JulesBischof/Praxismodul/README.txt

Praxismodul Julian Bischof

Die Dokumentation wird mit LaTex erstellt. 

Der Projektplan befindet sich auf GitHub unter dem link https://github.com/users/JulesBischof/projects/2/views/13

Das Repo befindet sich unter dem Link https://github.com/JulesBischof/Praxismodul.git
