JulesBischof/Praxismodul/02_Recherche/09_Encoder_Motor_Anschluss.txt

Shield zu Print Verbindung Motor: 

https://www.digikey.ch/de/products/detail/harwin-inc/S8091-46R/3131051
