JulesBischof/Praxismodul/00_Doku/Wiki_stand0805.pdf

# IOLxS Entwicklung

## Bauteile und 2nd Sources

SMD LED's

Grün; Bauform 0805
Lite-On LTST-C171GKT 0.04270 CHF Knightbright APT2012CGCK 0.06434 CHF

### Speisung

Common Mode Choke mit ~0.8mH - Grenzfrequenz ausgelegt auf ca. 60kHz. Störungen sind laut Louis zu erwarten ab 150kHz. Damit trotzdem die Impedanz des Filters nicht zu klein und die Störung einfach auf das Shield umgeleitet wird, wird die Grenzfrequenz bei 60kHz und nicht bei 15kHz angesetzt. Differential Mode Filterung mit ~1.5uH Streuinduktivität - Grenzfrequenz ausgelegt auf fg ~80kHz Dämpfungskondensator nur einbauen wenn benötigt. Aber für Anfang Footprint mal vorsehen, da C recht gross ist und Dämpfung gering. Weiter hinten in Richtung Motorentreiber befinden sich weitere Kapazitäten als Stützkondensatoren, welche ebenfalls dabei helfen Differentialmode Störungen zu unterdrücken. Von dem her wird davon abgesehen, die Grenzfrequenz allzu niedrig anzusetzen.

Inrush Limiter mit einer Ladekonstante für das C von in etwa 1ms. Dadurch wird der Anstieg des Stromes während der ersten paar us für die Stützkondensatoren auf ein gewisses Mass begrenzt. Durch die höheren Widerstände wird gewährleistet, dass im Zweifelsfall schnell auf eine Höhere Kapazität ausgewichen werden kann falls die Begrenzung bei der Inbetriebnahme nicht ausreichen sollte.

3.3V über LDO bereitstellen.

Bauteile & Secondsourcen

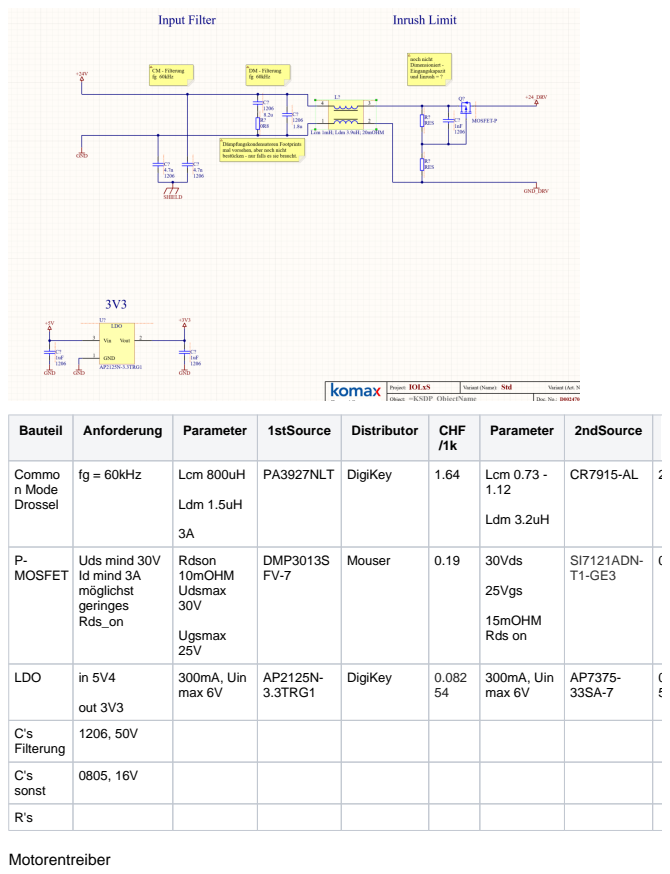
[picture p1: page 2]
Bauteil; Anforderung; Parameter; 1stSource; Distributor; CHF; 2ndSource; Commo n Mode Drossel; fg = 60kHz; Lcm 800uH; Ldm 1.5uH; PA3927NLT DigiKey; Lcm 0.73 -; Ldm 3.2uH; P- MOSFET; Uds mind 30V Id mind 3A möglichst geringes Rds_on; Rdson 10mOHM Udsmax 30V; Ugsmax 25V; DMP3013S FV-7; Mouser; 30Vds; 25Vgs; 15mOHM Rds on; SI7121ADN- T1-GE3; LDO; out 3V3; 300mA, Uin max 6V; AP2125N- 3.3TRG1; DigiKey; C's Filterung; C's sonst; Motorentreiber

Stützkondensator - worst Case Szenario für den Stützkondensator ist, wenn bei der niedrigsten PWM-Frequenz der volle Strom benötigt wird. Überschlagsmässig gerechnet mit einer Frequenz von ~20kHz (Datenblatt). Der Ausgangswiderstand eines Standartnetzteils beträgt zurückgerechnet über die Load Regulation (1%) 12mOHM. 10 Meter Kabel (5m Speisung) haben erwartungsgemäss bei einem Querschnitt von 075mm2 einen Innenwiderstand 680mOHM. Die dies ergibt gesamthaft ein R von ~700mOHM (inkl Choke + Leiterbahnen) parasitäre Indutivitäten und Kapazitäten mal vernachlässigt. Über die Formel U(t) = U0*e^(-t/tau) lässt sich das sich ergebende Spannungsripple pro Periode abschätzen. Bei einem C von 470uF kommt man so auf in etwa 107mV. Dies sollte vorerst ausreichen, das die Differentialmode Filterung ebenfalls noch einen Teil dieses Ripples herausfiltern wird und laut Datenblatt des Industrienetzteils ein Ripple von 100mV so oder so zu erwarten ist. Ausserdem betrachten wir hierbei den Worst-Case.

Die Weiteren Kondensatoren vor der Speisung wurden so vom Evaluationboard übernommen und werden bei höheren Frequenzen bereits niederohmig und sollen so Hochfrequente Spitzen bereits abfangen können.

Clock

Bezüglich des Encoders kann der interne Clock genug schnell zählen, um alle Schritte zu erfassen. (bis zu 2/3 des Clocks ist ein typischer Wert).

Der interne Clock ist allerdings nicht sehr genau (+-0.65MHz). Es ist abzuwägen, ob von Board zu Board eine Abweichung von +-5% tolerierbar sind oder nicht. Das Board bezieht sich in seinen Rechnungen für Geschwindigkeit und Beschleunigung auf den Clock als Zeitreferenz.

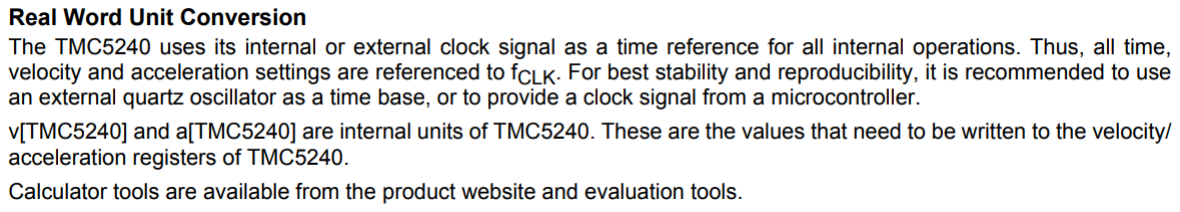
[picture p2: figure]
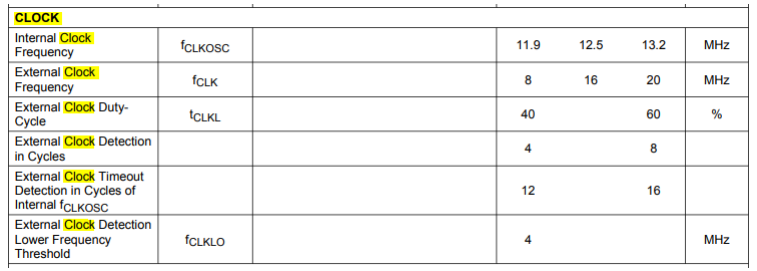
[picture p3: figure]
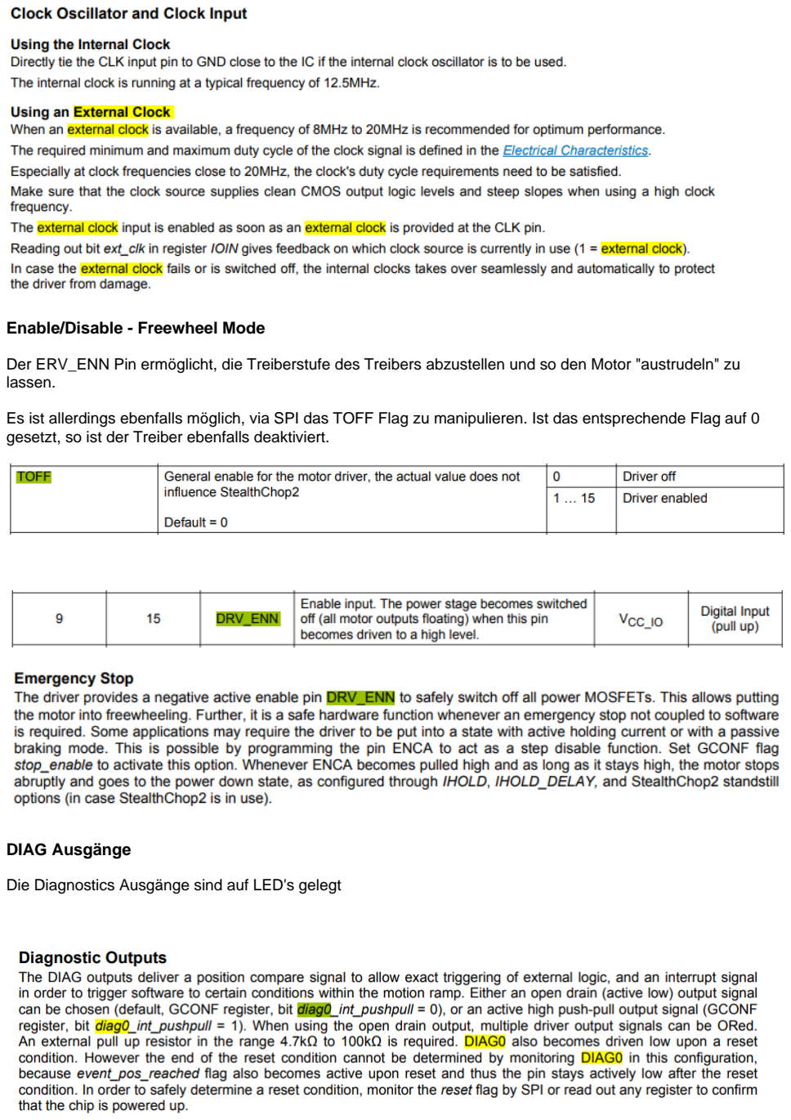
[picture p4: page 4]

Enable/Disable - Freewheel Mode

Der ERV_ENN Pin ermöglicht, die Treiberstufe des Treibers abzustellen und so den Motor "austrudeln" zu lassen.

Es ist allerdings ebenfalls möglich, via SPI das TOFF Flag zu manipulieren. Ist das entsprechende Flag auf 0 gesetzt, so ist der Treiber ebenfalls deaktiviert.

DIAG Ausgänge

Die Diagnostics Ausgänge sind auf LED's gelegt

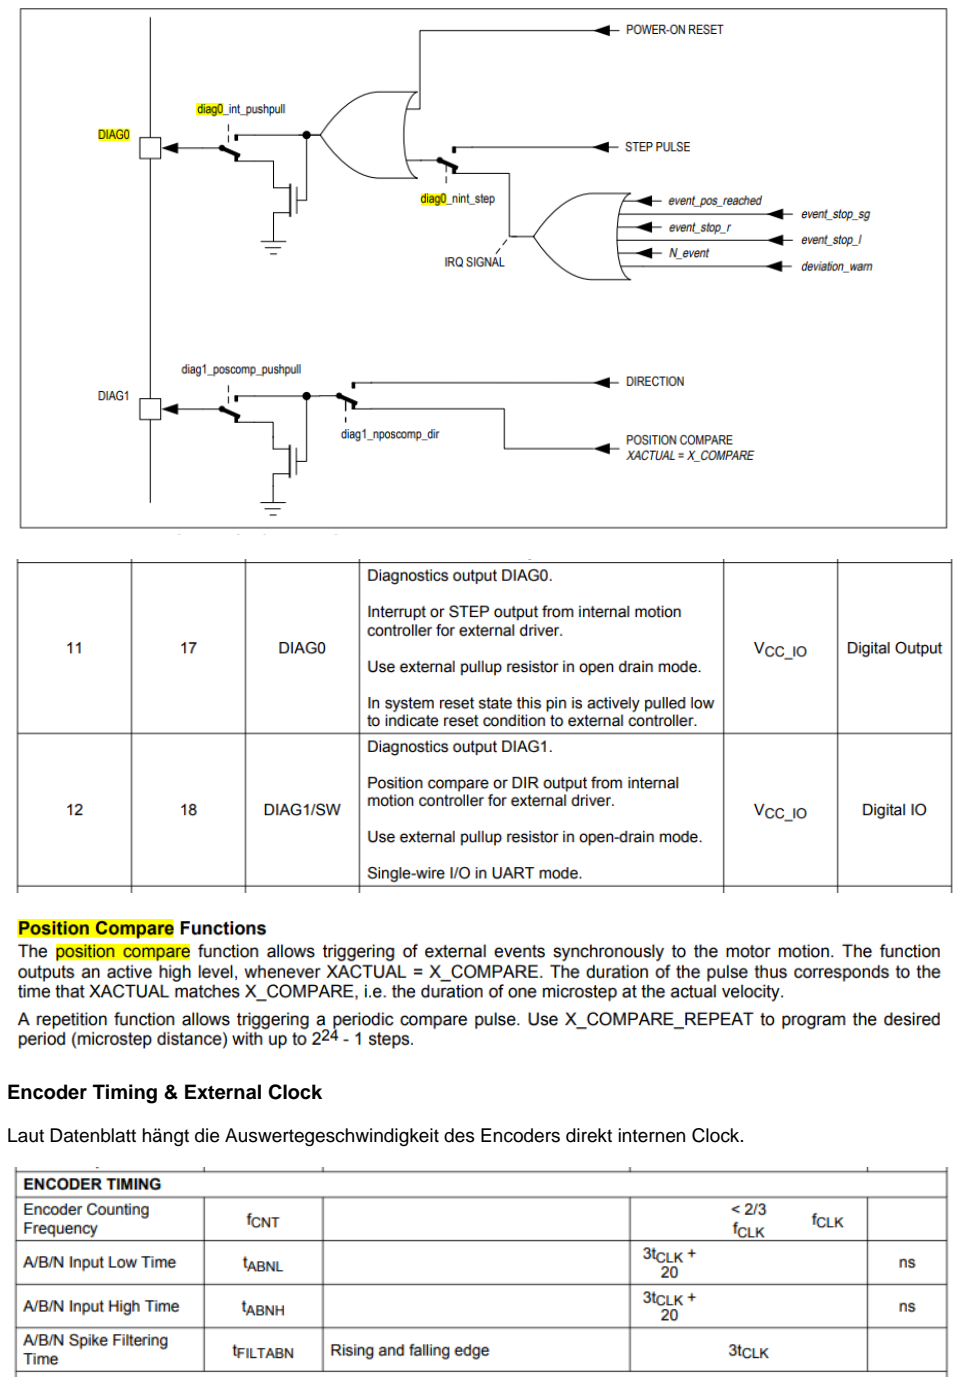
[picture p5: page 5]

Encoder Timing & External Clock

Laut Datenblatt hängt die Auswertegeschwindigkeit des Encoders direkt internen Clock.

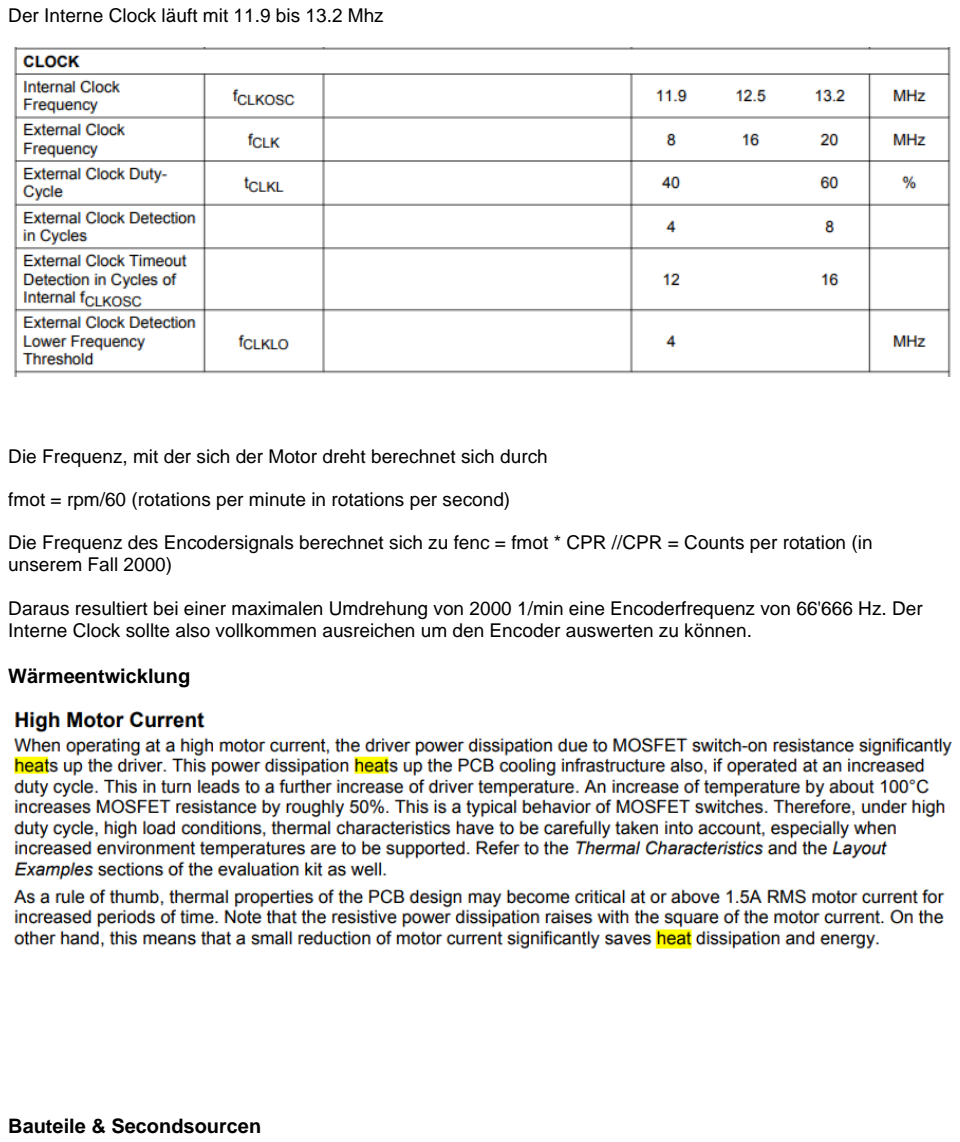
[picture p6: page 6]

Der Interne Clock läuft mit 11.9 bis 13.2 Mhz

Die Frequenz, mit der sich der Motor dreht berechnet sich durch

fmot = rpm/60 (rotations per minute in rotations per second)

Die Frequenz des Encodersignals berechnet sich zu fenc = fmot * CPR //CPR = Counts per rotation (in unserem Fall 2000)

Daraus resultiert bei einer maximalen Umdrehung von 2000 1/min eine Encoderfrequenz von 66'666 Hz. Der Interne Clock sollte also vollkommen ausreichen um den Encoder auswerten zu können.

Wärmeentwicklung

Bauteile & Secondsourcen

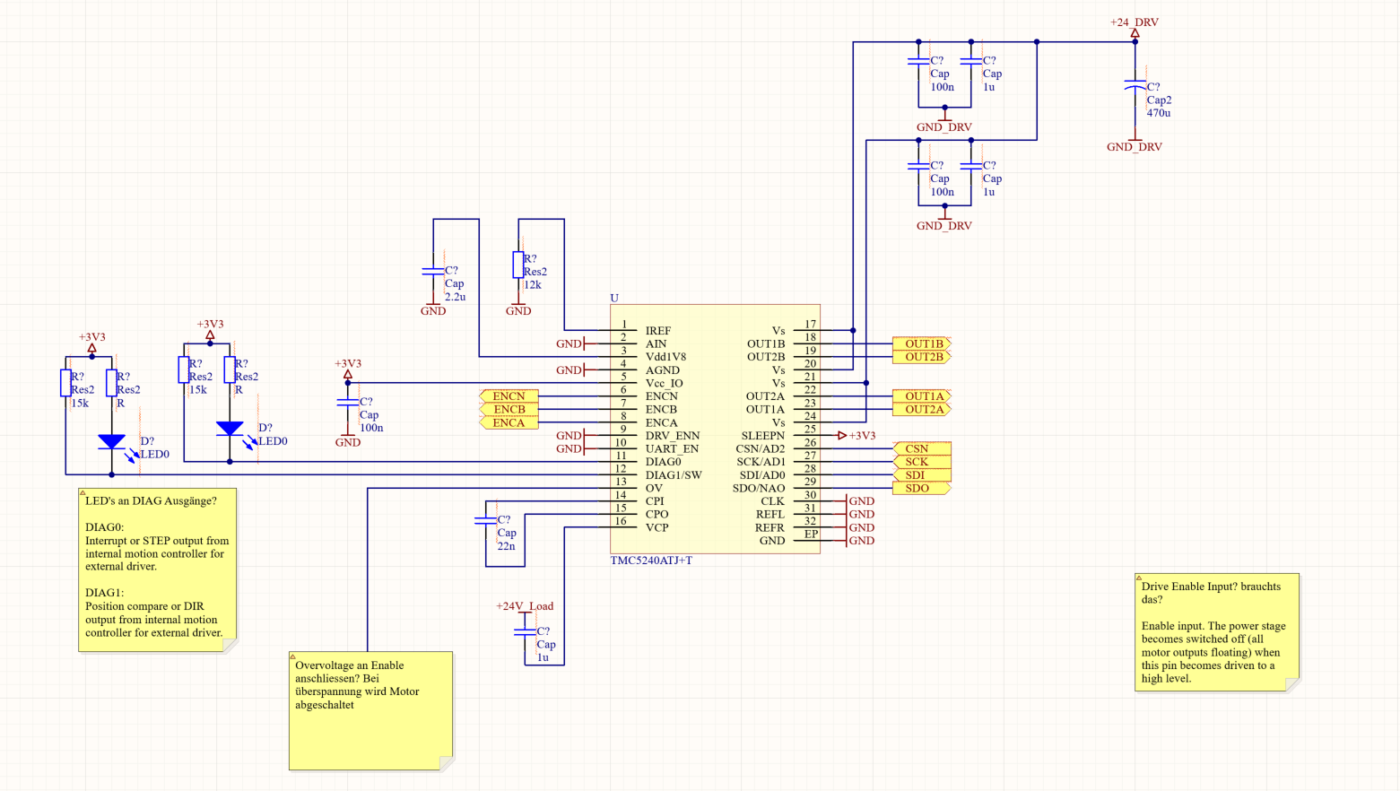
[picture p7: figure]
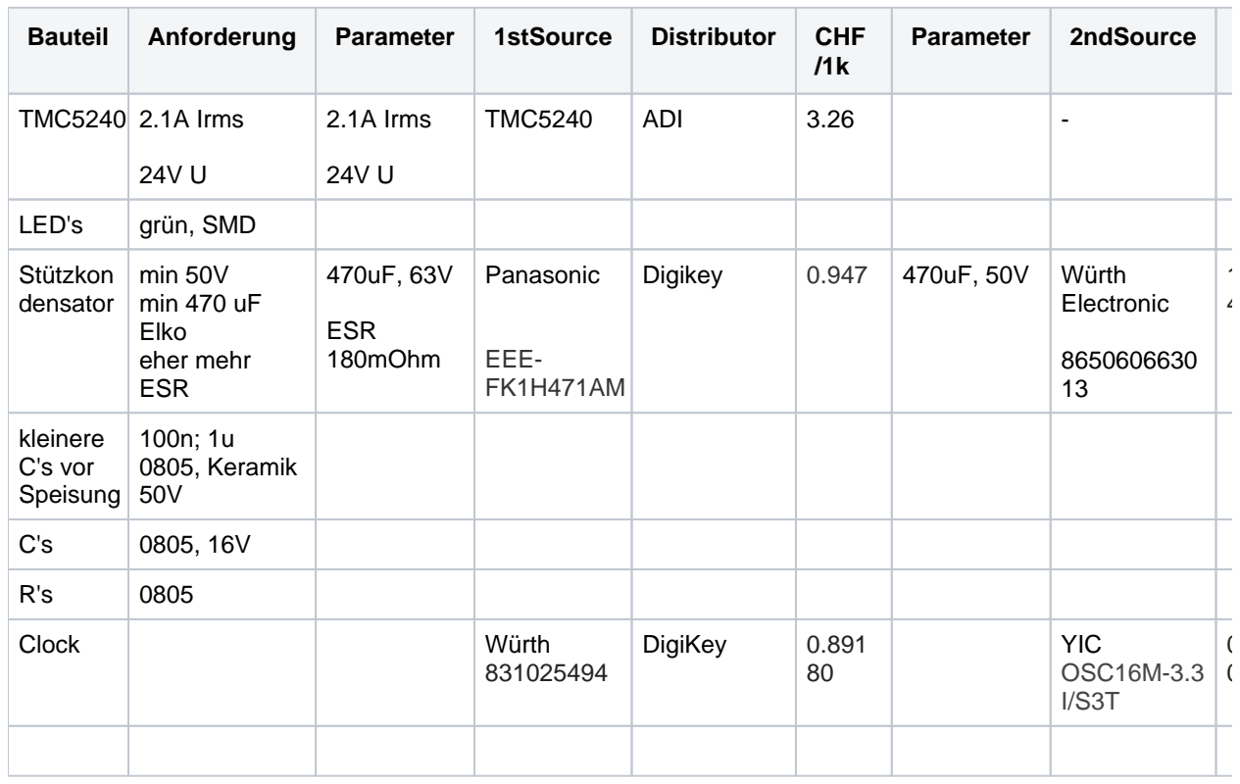
[picture p8: figure]
Bauteil; Anforderung; Parameter; 1stSource; Distributor; CHF; 2ndSource; TMC5240 2.1A Irms; 2.1A Irms; TMC5240; ADI; LED's; grün, SMD; Stützkon densator; min 50V min 470 uF Elko eher mehr ESR; ESR 180mOhm; Panasonic; EEE- FK1H471AM; Digikey; 470uF, 50V Würth; Electronic; kleinere C's vor Speisung; 100n; 1u 0805, Keramik 50V; Clock; Würth; DigiKey; YIC OSC16M-3.3 I/S3T

### Encoderanschluss

Kurzschlusssicherung

Kurzschlusssicherung: P-Fuses in der benötigten Grössenordnung haben einen Widerstand von 1.5OHM im nicht ausgelösten Zustand (z.B. 1206L010/30). Daher, dass die Speisung über die gegebenenfalls lange Encoder Leitung so oder so schon eher knapp ist, wird auf die Kurzschlusssicherung über eine P-Fuse verzichtet und ein USB-Switch mit Stromlimitierung eingesetzt. Der herausgesuchte USB-Switch hat einen Drain-Source Widerstand von ~100mOHM.

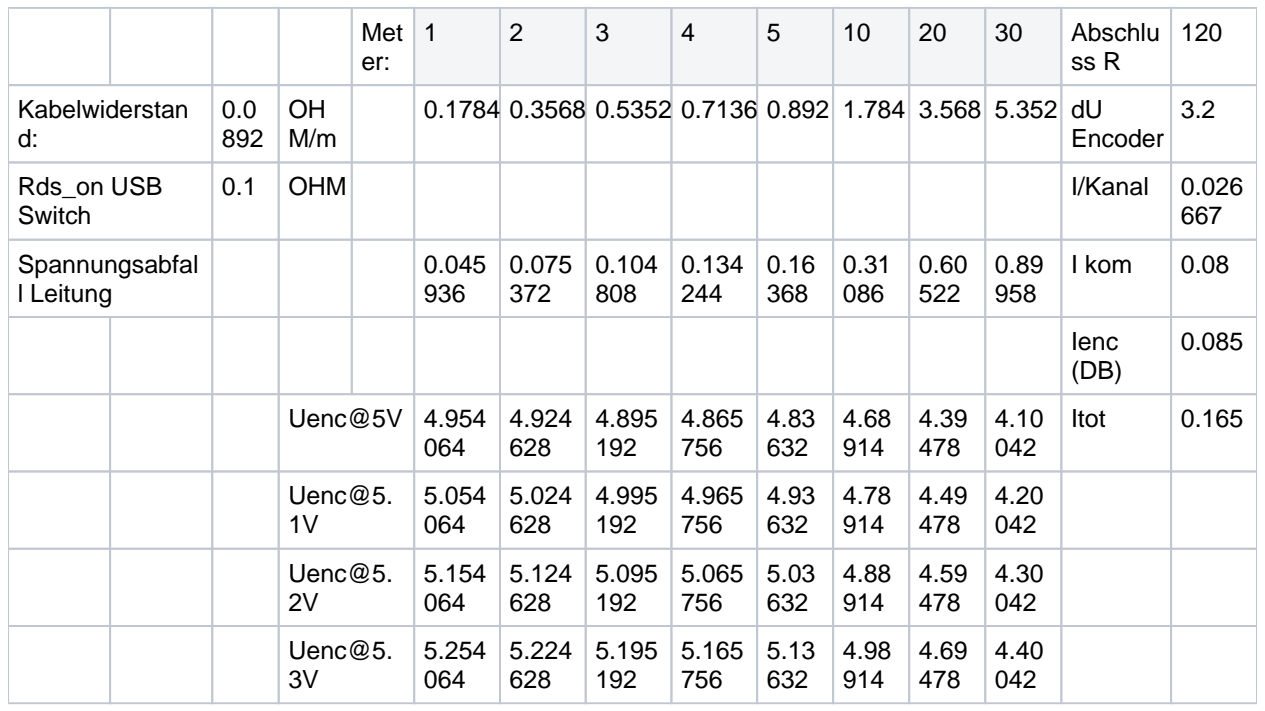
[picture p9: figure]
Met er:; Abschlu; Kabelwiderstan d:; Encoder; Rds_on USB Switch; 0.1 OHM; I/Kanal 0.026; Spannungsabfal l Leitung; I kom; Ienc (DB); Uenc@5V 4.954 064; Itot; Uenc@5. 1V; Uenc@5. 2V; Uenc@5. 3V

0.1784 0.3568 0.5352 0.7136 0.892 1.784 3.568 5.352 dU

Wünschenwert wäre, wenn die 5V Speisung seitens des IOe2 mindestens 5.2V bringen könnte

Die einzelnen Signalleitungen sind über TVS Dioden gegen Ground gegen ESD-Events geschützt. DAs Ausgangssignal des Encoders hat laut Datenblatt US Digital - Business relations (wire CH) - Komax Wiki (https://wiki.komax.org/display/BRDIN/US+Digital) einen Pegel von maximal 4.8V. Die Ausgesuchten TVS Dioden haben eine Durchbruchsspannung von 6 - 8V. Der Reciever Eingang verträgt einen Dauerhaften Pegel von 7V. Einer der beiden Reciever hat selbst gewisse ESD Eigenschaften, wobei der andere maximal Pulse mit 500V verträgt. Die TVS Diode schluckt so ab einem Pegel von typischerweise 7V den Impuls weg, den Rest muss dann der Recievereingang lösen können. Die Speisung ist ebenfalls mit einer TVS Diode gegen Ground geschaltet - wobei bei dieser die Durchbruchsspannung ein wenig höher gewählt wurde. Dies da die Speisespannung für die Encoder ein wenig höher angesetzt wird. Der USB Switch verträgt ebenfalls ein gewisses Mass an ESD-Impulsen. Ein Spannungsunterschied von Ein zu Ausgang von +-6V ist hier zulässig. Also sollte eine TVS Diode mit einer Klemmspannung von 6 - 7V ausreichend sein.

Der RS422 Reciever kann mit 5V Eingängen umgehen, wohingegen der Logik Ausgang nur 3.3V beträgt.

Tiefpass vor Reciever

Siehe weiter oben unter Encoder Timing & External Clock Die maximale Encodergeschwindigkeit, mit welcher zu rechnen ist, beträgt 66'666 kHz unter der Annahme dass die Motoren mit maximal 2000rpm drehen. Um noch ein wenig Kapazität nach oben frei zu haben, wird mit einer Frequenz von 100kHz gerechnet. Die Grenzfrequenz des Eingangs - Tiefpassfilters (einfaches RC Glied) wird deshalb mit 1MHz angenommen. Der Widerstand wird eher hoch angesetzt, damit einerseits die Flanke des einkommenden Signals scharf möglichst scharf bleibt, aber auch übrigbleibsel einkommender ESD-Impulse eher abgeblockt werden können.

Um das Signal nicht zu verfälschen wir auf den Tiefpass verzichtet

Bauteile und Secondsources

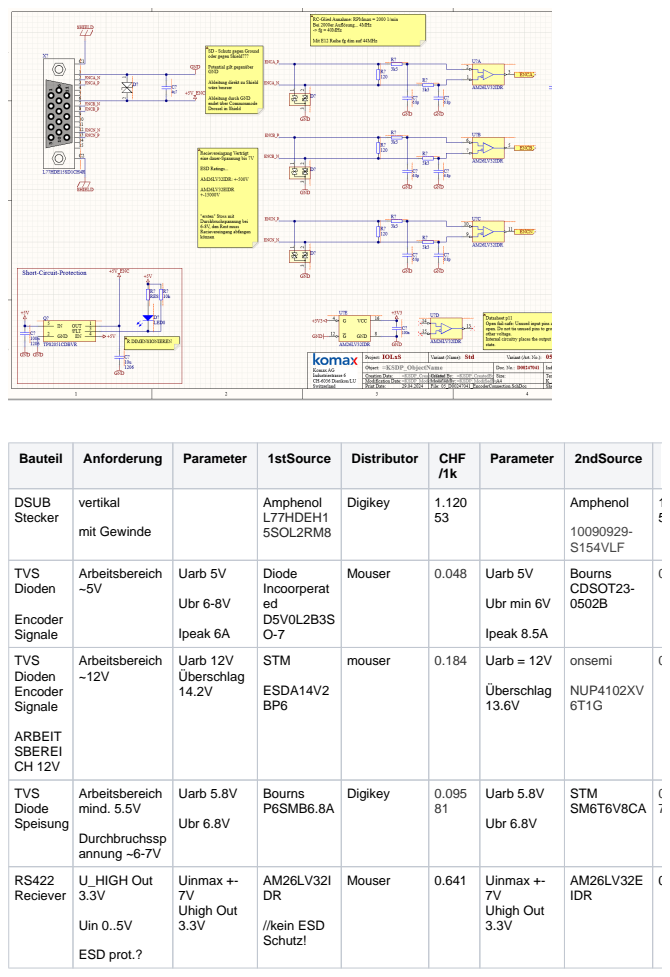
[picture p10: page 9]
Bauteil; Anforderung; Parameter; 1stSource; Distributor; CHF; 2ndSource; DSUB Stecker; vertikal; mit Gewinde; Amphenol L77HDEH1 5SOL2RM8; Digikey; Amphenol; 10090929- S154VLF; TVS Dioden; Encoder Signale; Arbeitsbereich ~5V; Uarb 5V; Ubr 6-8V; Ipeak 6A; Diode Incoorperat ed D5V0L2B3S O-7; Mouser; Ubr min 6V; Ipeak 8.5A; Bourns CDSOT23- 0502B; TVS Dioden Encoder Signale; ARBEIT SBEREI CH 12V; Arbeitsbereich ~12V; Uarb 12V Überschlag 14.2V; STM; ESDA14V2 BP6; mouser; Uarb = 12V; Überschlag 13.6V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

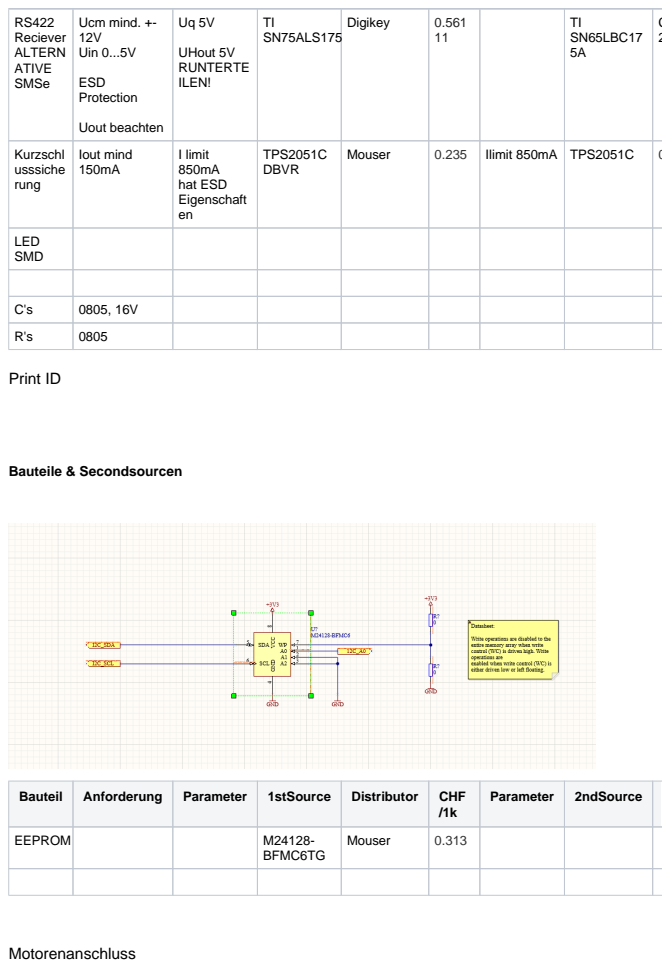
[picture p11: page 10]
RS422 Reciever ALTERN ATIVE SMSe; Ucm mind. +- 12V Uin 0...5V; ESD Protection; Uout beachten; UHout 5V RUNTERTE ILEN!; TI SN75ALS175; Digikey; TI SN65LBC17 5A; CHF 2.30; Kurzschl usssiche rung; Iout mind 150mA; I limit 850mA hat ESD Eigenschaft en; TPS2051C DBVR; Mouser; Ilimit 850mA TPS2051C; LED SMD; Print ID; Bauteile & Secondsourcen; Bauteil; Anforderung; Parameter; 1stSource; Distributor; CHF; 2ndSource; EEPROM; BFMC6TG; Motorenanschluss

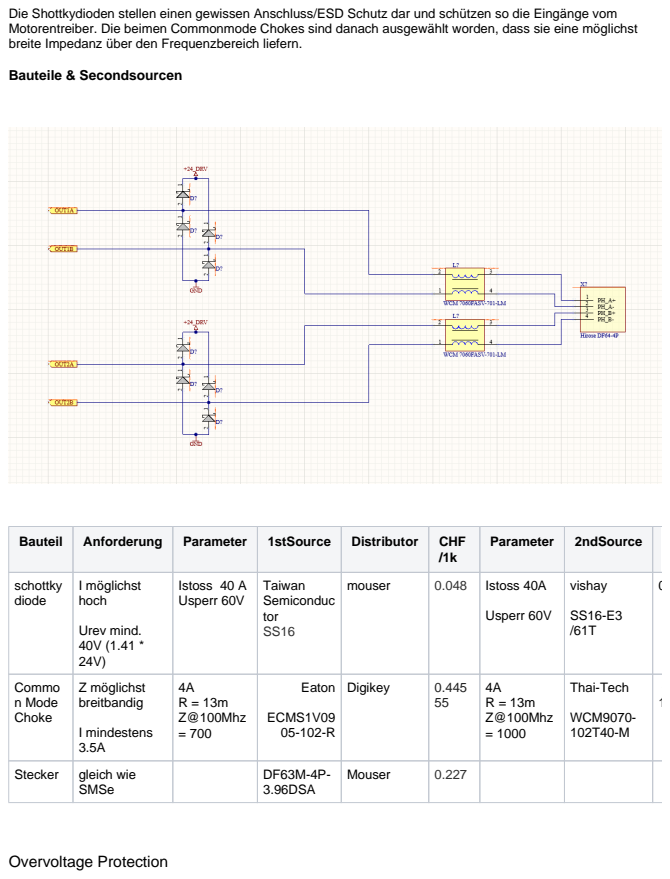
[picture p12: page 11]
Bauteil; Anforderung; Parameter; 1stSource; Distributor; CHF; 2ndSource; schottky diode; I möglichst hoch; Urev mind. 40V (1.41 * 24V); Istoss 40 A Usperr 60V; Taiwan Semiconduc tor SS16; mouser; Istoss 40A; Usperr 60V; vishay; Commo n Mode Choke; Z möglichst breitbandig; I mindestens 3.5A; 4A R = 13m Z@100Mhz = 700; Eaton; ECMS1V09 05-102-R; Digikey; 4A R = 13m Z@100Mhz = 1000; Thai-Tech; WCM9070- 102T40-M; Stecker; gleich wie; SMSe; DF63M-4P- 3.96DSA; Mouser; Overvoltage Protection

Die Shottkydioden stellen einen gewissen Anschluss/ESD Schutz dar und schützen so die Eingänge vom
Motorentreiber. Die beimen Commonmode Chokes sind danach ausgewählt worden, dass sie eine möglichst
breite Impedanz über den Frequenzbereich liefern.
Bauteile & Secondsourcen

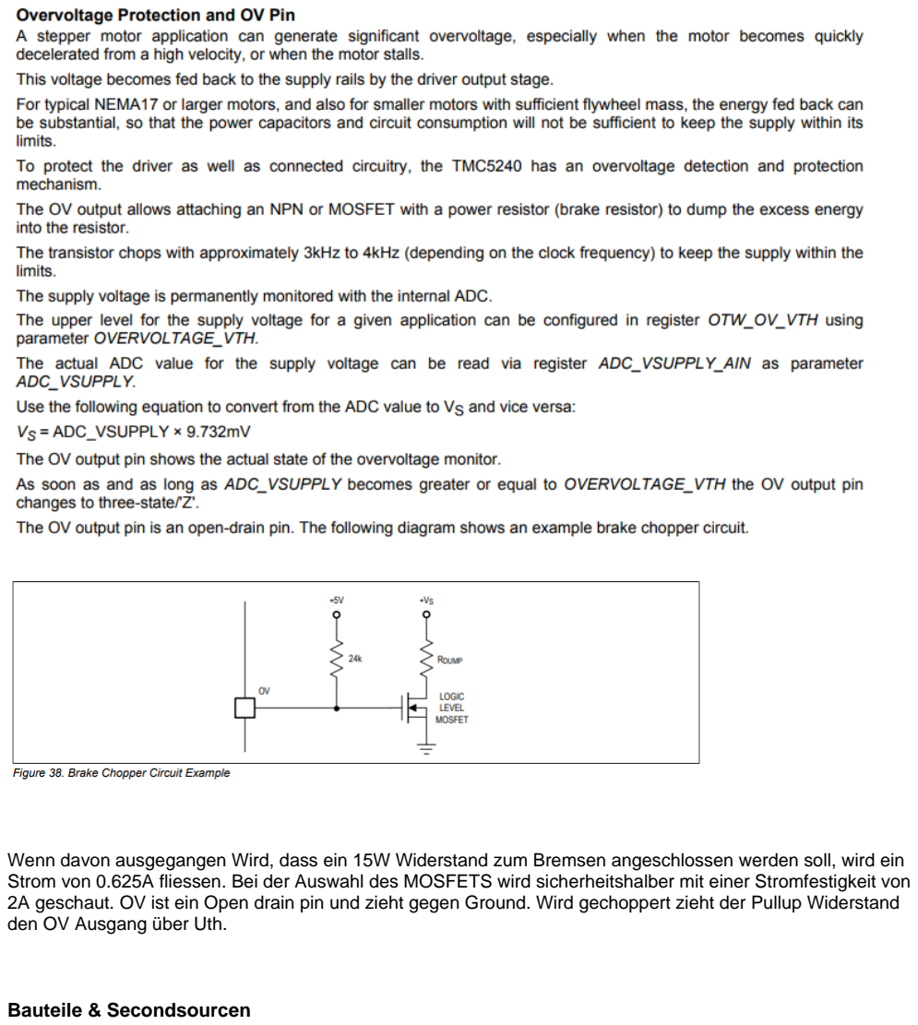
[picture p13: page 12]

Wenn davon ausgegangen Wird, dass ein 15W Widerstand zum Bremsen angeschlossen werden soll, wird ein Strom von 0.625A fliessen. Bei der Auswahl des MOSFETS wird sicherheitshalber mit einer Stromfestigkeit von 2A geschaut. OV ist ein Open drain pin und zieht gegen Ground. Wird gechoppert zieht der Pullup Widerstand den OV Ausgang über Uth.

Bauteile & Secondsourcen

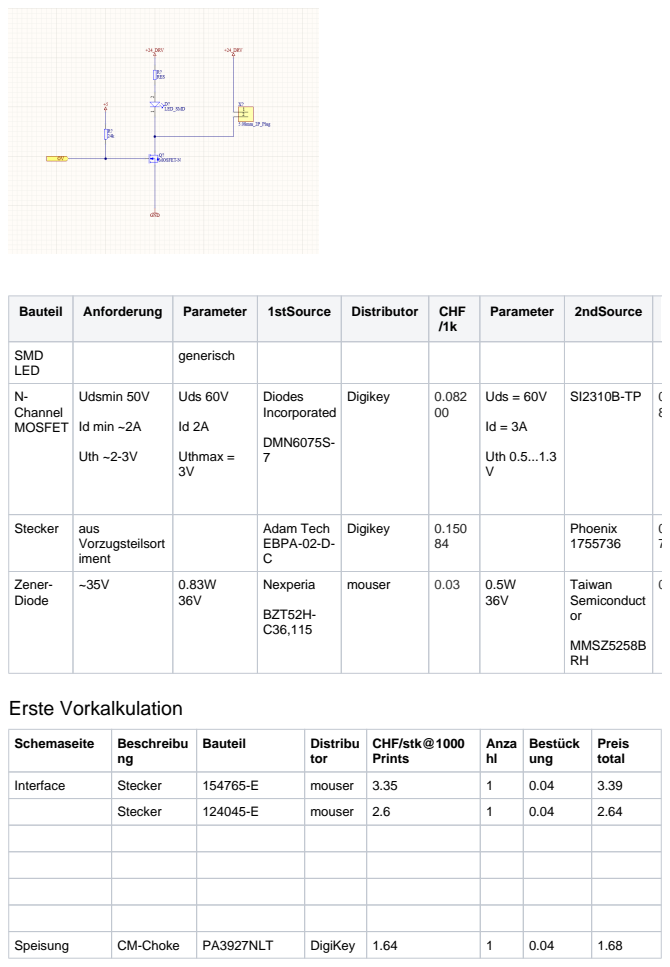
[picture p14: page 13]
Bauteil; Anforderung; Parameter; 1stSource; Distributor; CHF; 2ndSource; SMD LED; generisch; N- Channel MOSFET; Udsmin 50V; Id min ~2A; Uth ~2-3V; Uds 60V; Uthmax = 3V; Diodes Incorporated; DMN6075S- 7; Digikey; Uds = 60V; Uth 0.5...1.3 V; Stecker; aus; Vorzugsteilsort iment; Adam Tech EBPA-02-D- C; Phoenix 1755736; Zener- Diode; Nexperia; BZT52H- C36,115; mouser; Taiwan Semiconduct or; MMSZ5258B RH; Erste Vorkalkulation; Schemaseite; Beschreibu; Distribu; tor; CHF/stk@1000 Prints; Anza hl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

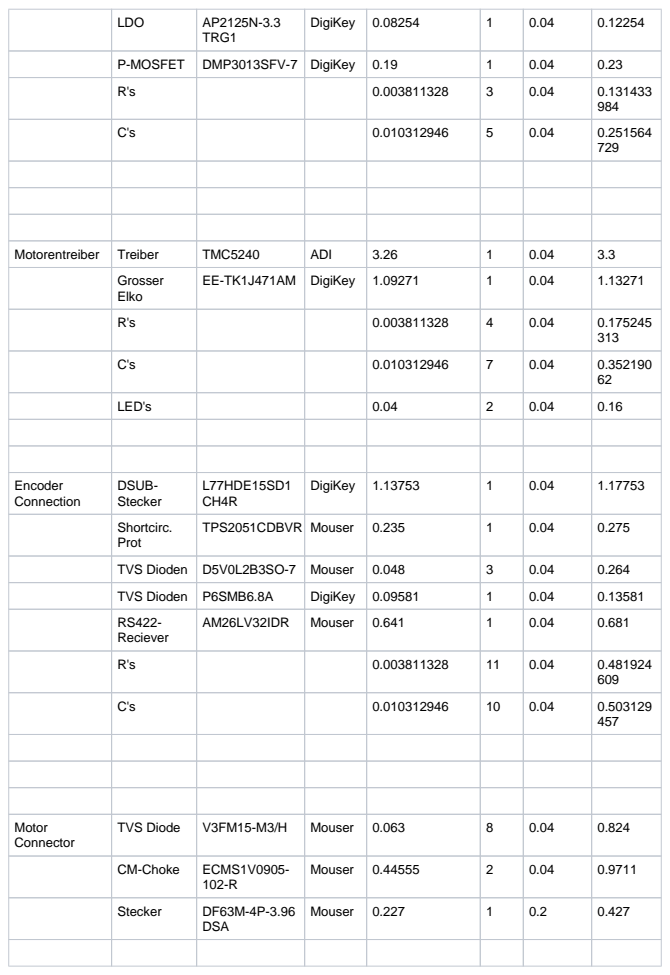
[picture p15: page 14]
LDO; TRG1; DigiKey 0.08254; P-MOSFET DMP3013SFV-7 DigiKey 0.19; Motorentreiber Treiber; TMC5240; ADI; Grosser Elko; EE-TK1J471AM DigiKey 1.09271; LED's; Encoder Connection; DSUB- Stecker; L77HDE15SD1 CH4R; DigiKey 1.13753; Shortcirc. Prot; TPS2051CDBVR Mouser; TVS Dioden D5V0L2B3SO-7 Mouser; TVS Dioden P6SMB6.8A; DigiKey 0.09581; RS422- Reciever; AM26LV32IDR; Mouser; Motor Connector; TVS Diode; CM-Choke; ECMS1V0905-; Stecker; DSA

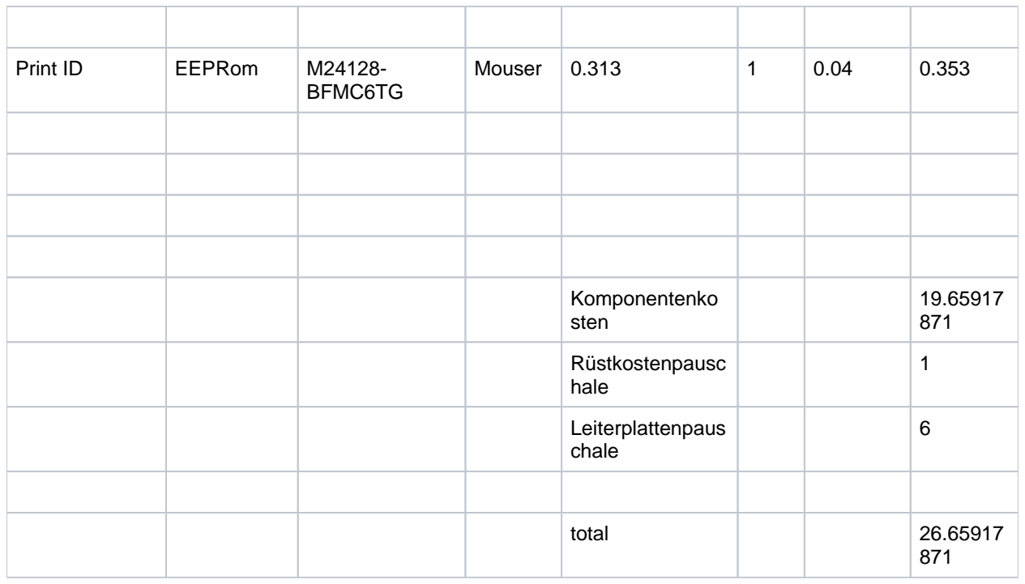
[picture p16: figure]
Print ID; EEPRom; BFMC6TG; Mouser; Komponentenko sten; Rüstkostenpausc hale; Leiterplattenpaus chale; total

1.
2.
3.

## Sitzungsprotokolle

### 30.04.2024 Besprechung der Konzepte

Anwesende
Julian Bischof
Christoph Peter
Rolf Christen
Francesco Casamassima

Themen

Vorstellung der Methodik bei der Konzeptierung (Kostenschätzung u.ä.) Vorstellung ausgearbeiteter Konzepte & Diskussion
Entscheidung für ein Konzept

Notitzen

zu 1.

- bei Berechnung der Leiterplattenkosten wurden die Kosten für die 2. Schnittstelle vergessen
- die Filterschaltung braucht es auch auf der Ausgangsseite

zu 2.

- 6 und 7 sehr ähnlich -> Entscheidung wenn für 7 da bessere Performance bei gleichem Preis & Second Sources.
- Konzept 6 & 7 wahrscheinlich wesentlich aufwändeiger in der Entwicklung Softwareseitig
- Favorit also Nummer 8, da schneller entwickelt, günstig und gute Erfahrungen in der Vergangenheit mit ADI gemacht
- Speisung kann über IOe bezogen werden, da dieses über seine Pins 1.7A pro Pin liefern kann.

zu 3.

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
Entscheid für Konzept 8 unter der Vorraussetzung, dass die Schnittstelle des IOe2 genügend Strom über die Schnittstelle zur Verfügung stellen kann. Dies beinhaltet den Treiberchip TMC5240, Encoderauswertung über diesen auf der Erweiterung sowie Speisung über die IOe2 Schnittstelle.

### 03.04.2024 Präsentation des Zwischenstands

Anwesende
Julian Bischof
Daniel Signer
Rolf Christen
Francesco Casamassima

Themen

Vorstellung des Altium-Schemas und Diskussion Vorstellung der ersten Kostenvorabschätzung
Weiteres Vorgehen besprechen, eventuelle Inputs abholen
offene Fragen klären
Testpunkte - wohin und wieviele
ESD Schutz - Speisungsseite nichts, Motorenausgang besser mit TVS Dioden? Befestigung des Shield von Motorenkabel im Schaltschrank in Ordnung?
Soll ich dem TMC5240 einen seperaten Clock verpassen?
LED's für DIAG Ausgänge?
übriges Budget für Anschlussmöglichkeit eines Brenswiderstands? (z.B. Stecker vorsehen)

Notizen

zu 1.

Es sollte die Möglichkeit eingeplant werden, einen Bremswiderstand zu verbauen. Voraussichtlich wird dieser nicht benötigt, allerdings wäre die Möglichkeit diesen zu bestücken nicht schlecht. Dafür den entsprechenden MOSFET mit einem Anschlussstecker anschliessen. Hierfür auch gegebenenfalls nochmal bei Schleuniger nachfragen, ob sie einen Bremswiderstand für ihre kleineren Boards vorsehen? Testpunkte fehlen noch
Wie schnell kann der Encoder eigentlich drehen? und wie schnell kann der Teiber eigentlich zählen? Nochmals Grenzfrequenz vor Recievereingang prüfen

zu 2.

Gegebenenfalls kommen hier noch eine Ansteckmöglichkeit für einen Bremswiderstand als auch für eine Shieldanbindung des Motorenkabels dazu.

zu 3.

Bei ADI & Bei Schleuniger Infos holen über Wärmeabführung, Brems-R
TVS Dioden sollten gegen Shield geführt werden, nicht gegen GND Wärmeabführung abklären
Encoder-Zählgeschwindigkeit abklären
fg Encodereingang
Enableanschluss der Kurzschlusssicherung auf das IOe hängen - LED behalten. Alle Boards können ruhig auf gleichen GPIO gehängt werden.

zu 4.

a) Testpunkte sollten eingeplant werden. Das Board soll in einem Funktionstest in Betrieb genommen werden. Hierfür also an allen wichtigen Netzen, welche zur Fehlersuche sinnvoll wären, Testpunkte vorsehen.
b) Der Spannungsausgang kann ruhig mit den Dioden wie geplant geklemmt werden. Das sollte er vertragen.

1.
2.
3.
4.
a.
b.
c.
c) Eine Befestigungsmöglichkeit auf dem Print wäre schön - gegebenenfalls bei ICOTEC schauen, ob es anlötbare Klammern gibt. Im Zweifelsfall bräuchte es ein Befestigungsloch im Print mitsamt einer Schraube um das Shield anzubinden
d) Ob der Treiberchip einen externen Clock benötigt sollte bei ADI nachgefragt werden. Ebenfalls, ob es Hinweise oder Tipps bezüglich der Wärmeabführung gäbe.
e) Für den Einrichtbetrieb sicher sinnvoll, ob es das dann späte noch braucht wird sich noch zeigen und kann ggf. immernoch weggelassen werden
f) Ja, wäre sinnvoll

### 01.05.2024 Präsentation des Zwischenstands (nur Christoph und Julian)

Anwesende
Julian Bischof
Christoph Peter

Themen

Vorstellung des Altium-Schemas und Diskussion Vorstellung der ersten Kostenvorabschätzung
Weiteres Vorgehen besprechen, eventuelle Inputs abholen offene Fragen klären
Befestigung des Shield von Motorenkabel auf das Board?
Soll ich dem TMC5240 einen seperaten Clock verpassen?
übriges Budget für Anschlussmöglichkeit eines Brenswiderstands? (z.B. Stecker vorsehen)

Notizen

zu 1.

Die Inrush Limiter Schaltung sollte in einer ersten Bestückung mal versucht werden, wegzulassen. Es wäre interessant zu wissen, ob es diesen tatsächlich benötigt, oder ob wir damit nur einen unnötigen Kostenpunkt erstellen
Die interne Clockreferenz hat eine Streuung von +-0.65%. Es gilt abzuwägen, ob eine genauere Berechnung von Geschwindigkeit und Beschleunigung in den geforderten Anwendungsbereichen überhaupt notwendig ist. Ein Clock kostet ebenfalls wieder 1CHF
Disable DRV_ENN Pin könnte theoretisch auch über TOFF Bit erreicht werden. Es sollte abgeklärt werden, ob mit dem entsprechenden Flag genau die gleiche Funktionalität erreicht werden kann wie mit dem Enable Pin.
