JulesBischof/Praxismodul/04_Konzepte/Visio_PDF.pdf

Fuer dieses Dokument und den darin dargestellten Gegenstand behalten wir uns alle Rechte vor. Vervielfaeltigung, Bekanntgabe an Dritte oder Verwendung seines Inhaltes sind ohne unsere ausdrueckliche Zustimmung verboten.
© Komax AG CH-6036 Dierikon Schweiz

We reserve all rights in this document and the information contained therein. Reproduction, use or disclosure to third parties without express authority is strictily forbidden.
© Komax AG CH-6036 Dierikon Switzerland

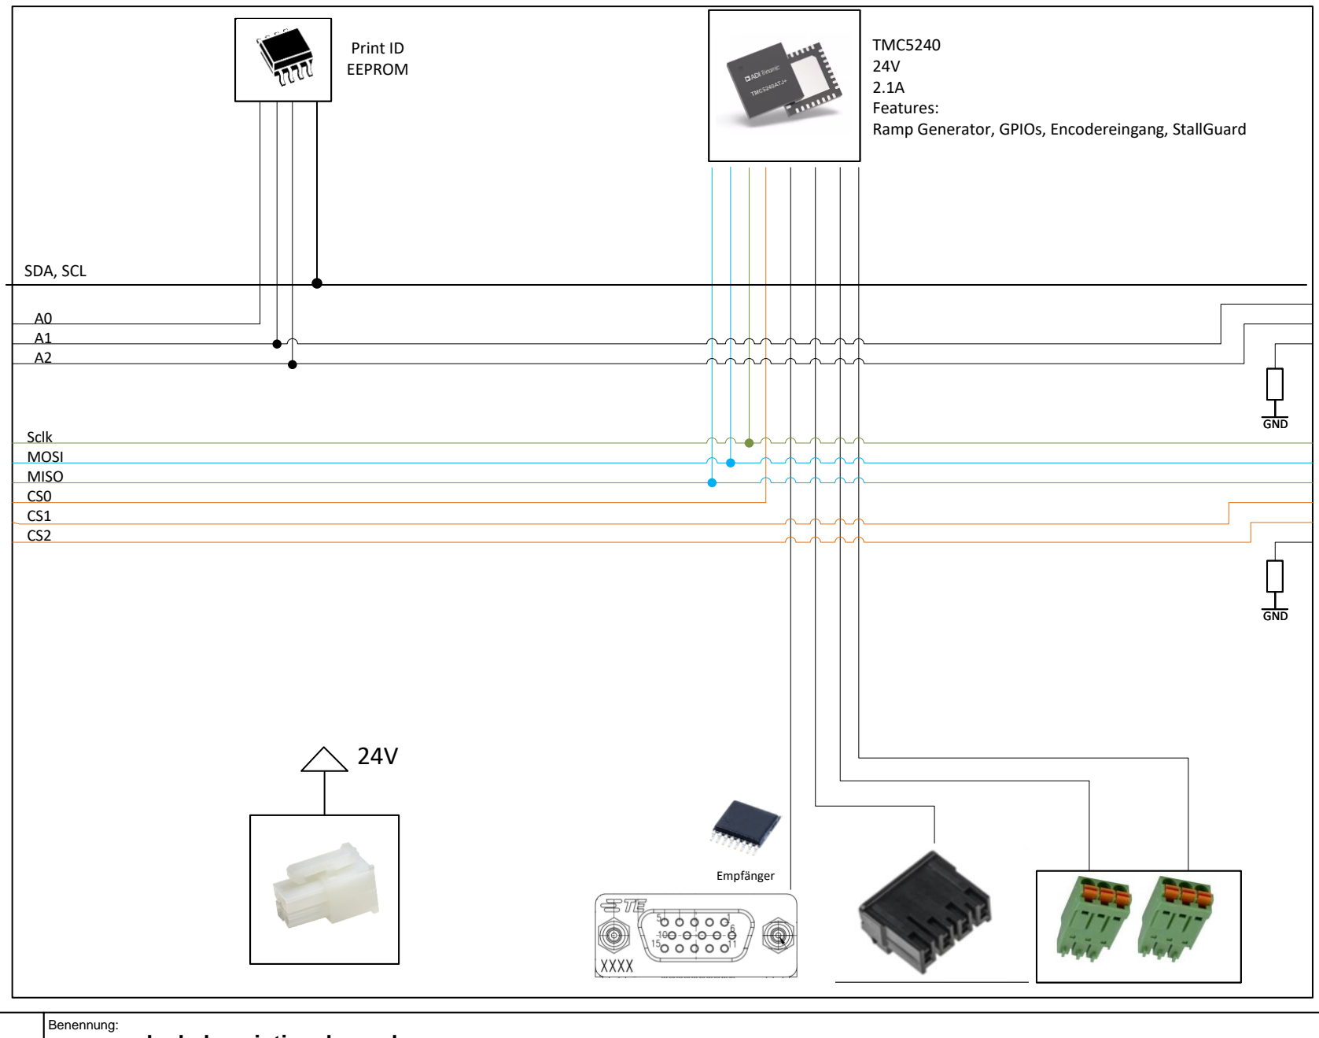
[picture p17: figure]
Benennung:; GND; Sclk MOSI MISO CS0 CS1 CS2; Empfänger; Print ID EEPROM; TMC5240 24V 2.1A Features:; SDA, SCL

Dok.Nr:

Verwendung in ArtNr: | A4 quer | Seite: | 1 of 8
Index: | Status: | Erstellt: | Freigabe: | Geändert:
| | 01_Konzepte_Visio.vsdx

# <kxd_description_long_de>

D90000043

000 | avle_a | avle_a | avle_a

<joined_status
_name_en>

A0
A1
A2

## Ramp Generator, GPIOs, Encodereingang, StallGuard

## Sclk MOSI MISO

CS0
CS1
CS2

# I2C SPI

# IOe2

© Komax AG CH-6036 Dierikon Schweiz

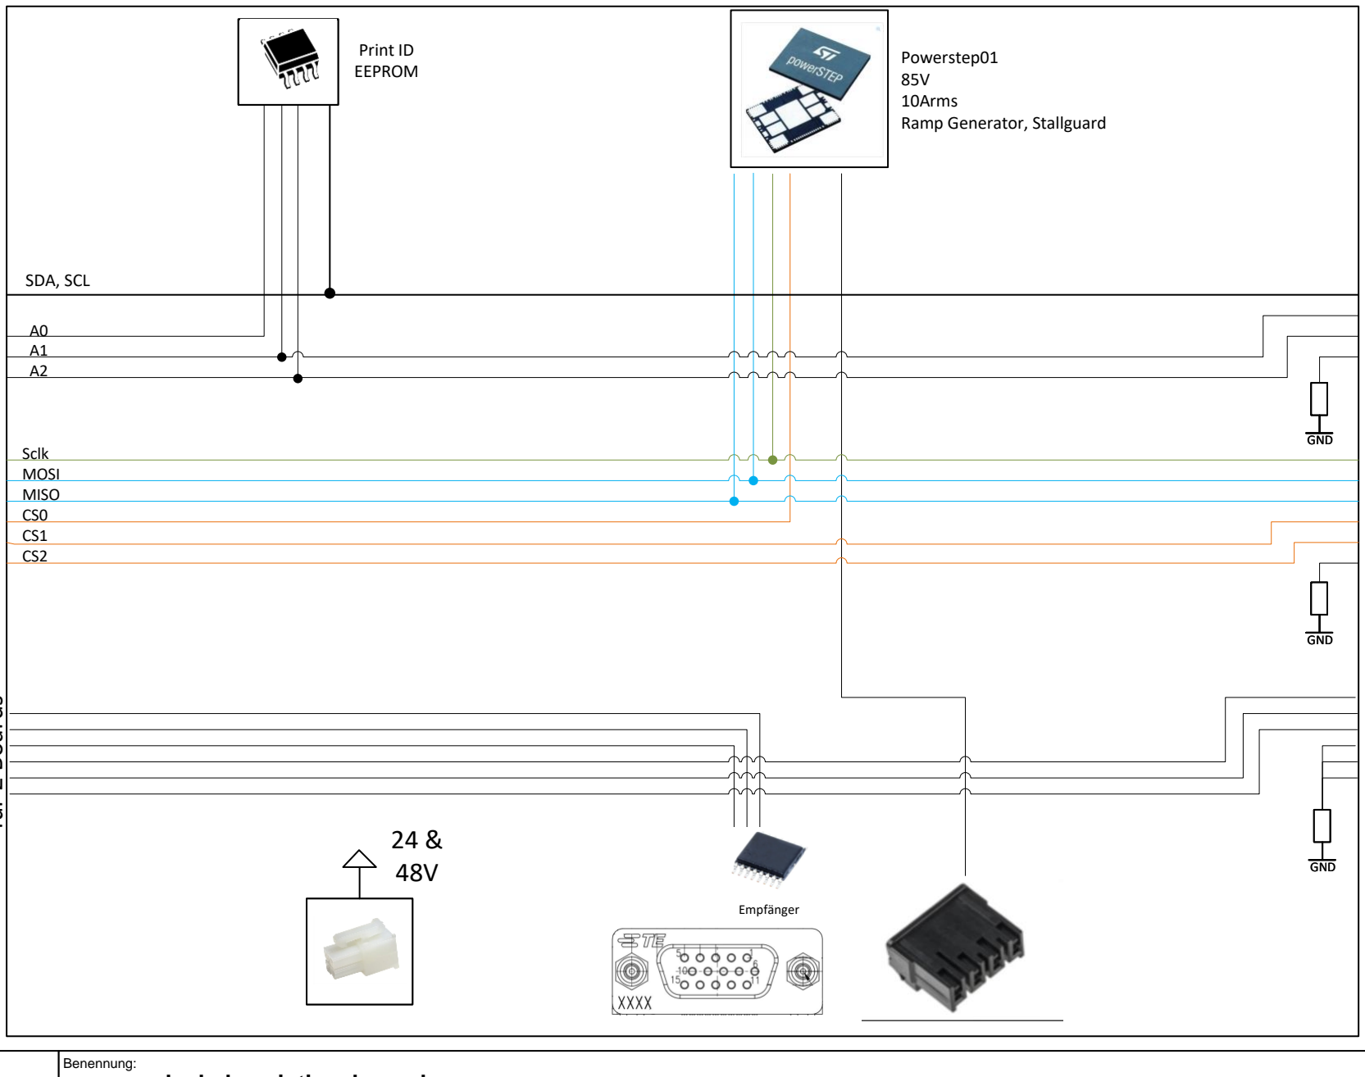
[picture p18: figure]
Benennung:; GND; Sclk MOSI MISO CS0 CS1 CS2; Print ID EEPROM; Powerstep01 85V 10Arms Ramp Generator, Stallguard; Empfänger; SDA, SCL

Verwendung in ArtNr: | A4 quer | Seite: | 2 of 8

# <kxd_description_long_de>

A0
A1
A2

## Sclk MOSI MISO

CS0
CS1
CS2

# I2C SPI

# IOe2

# 6x Encoder

# für 2 Boards

# Ios von IOe2

# Nächster Encoder

© Komax AG CH-6036 Dierikon Schweiz

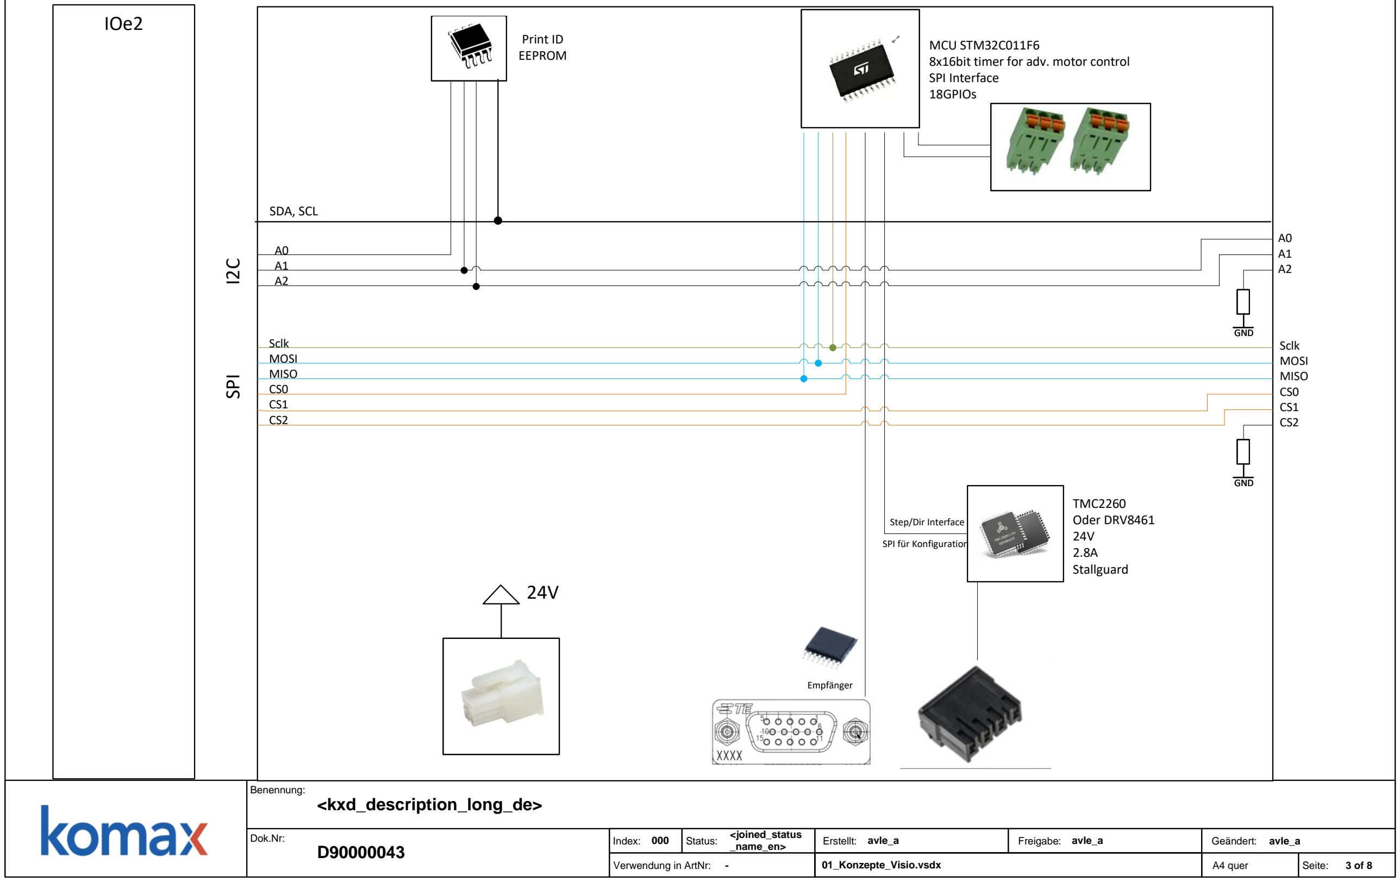
[picture p19: figure]
Benennung:; Verwendung in ArtNr:; A4 quer; Seite:; <kxd_description_long_de>; GND; Sclk MOSI MISO CS0 CS1 CS2; Empfänger; Print ID EEPROM; MCU STM32C011F6 8x16bit timer for adv. motor control SPI Interface 18GPIOs; I2C SPI; IOe2; Step/Dir Interface; TMC2260 Oder DRV8461 24V 2.8A Stallguard; SPI für Konfiguration; SDA, SCL

© Komax AG CH-6036 Dierikon Schweiz

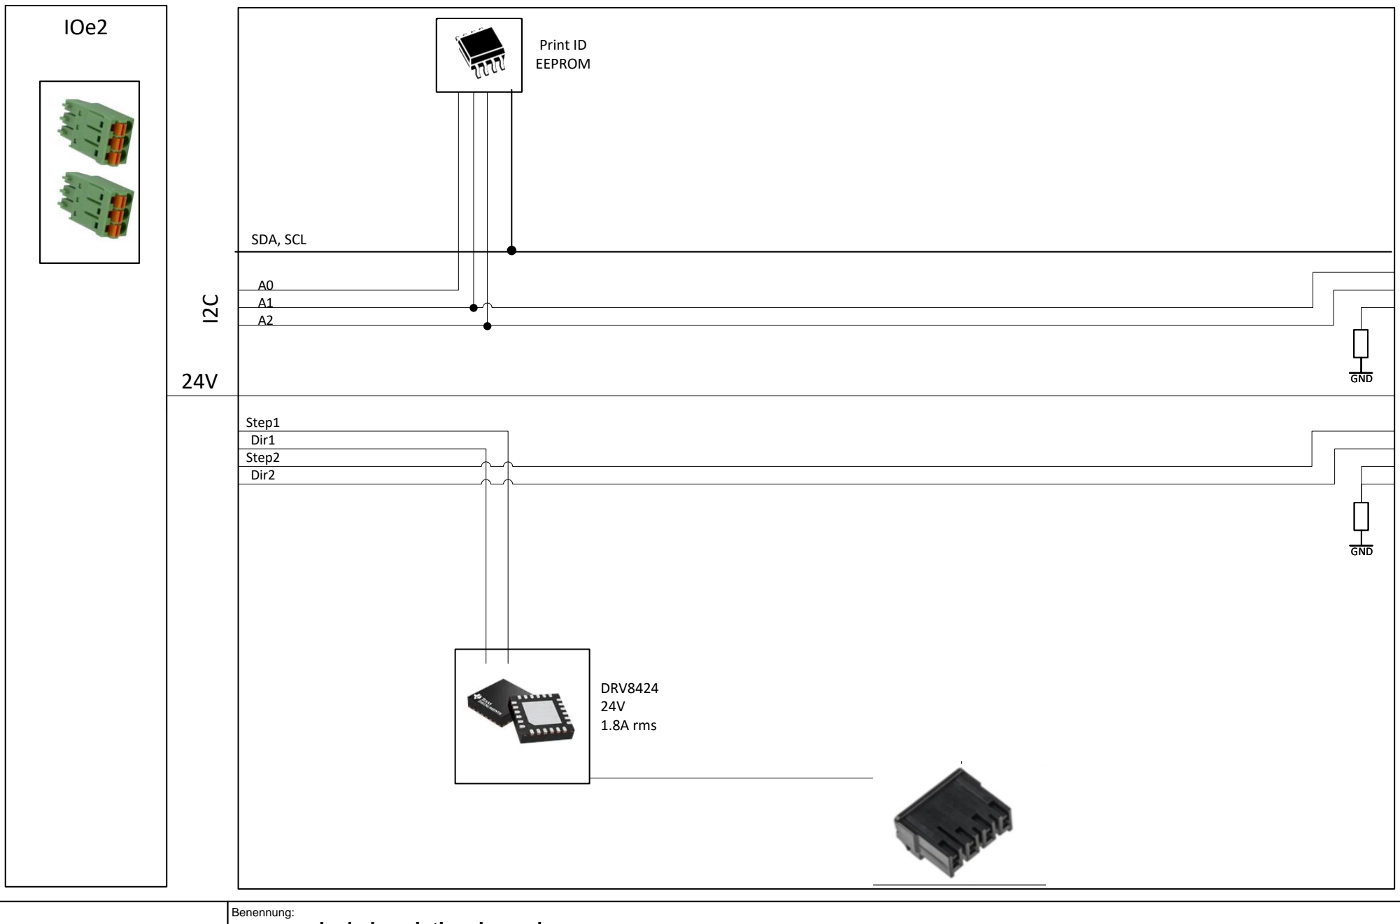
[picture p20: figure]
Benennung:; GND; Print ID EEPROM; DRV8424 24V 1.8A rms; IOe2; Step1 Dir1 Step2 Dir2; SDA, SCL

Verwendung in ArtNr: | A4 quer | Seite: | 4 of 8

# <kxd_description_long_de>

A0
A1
A2

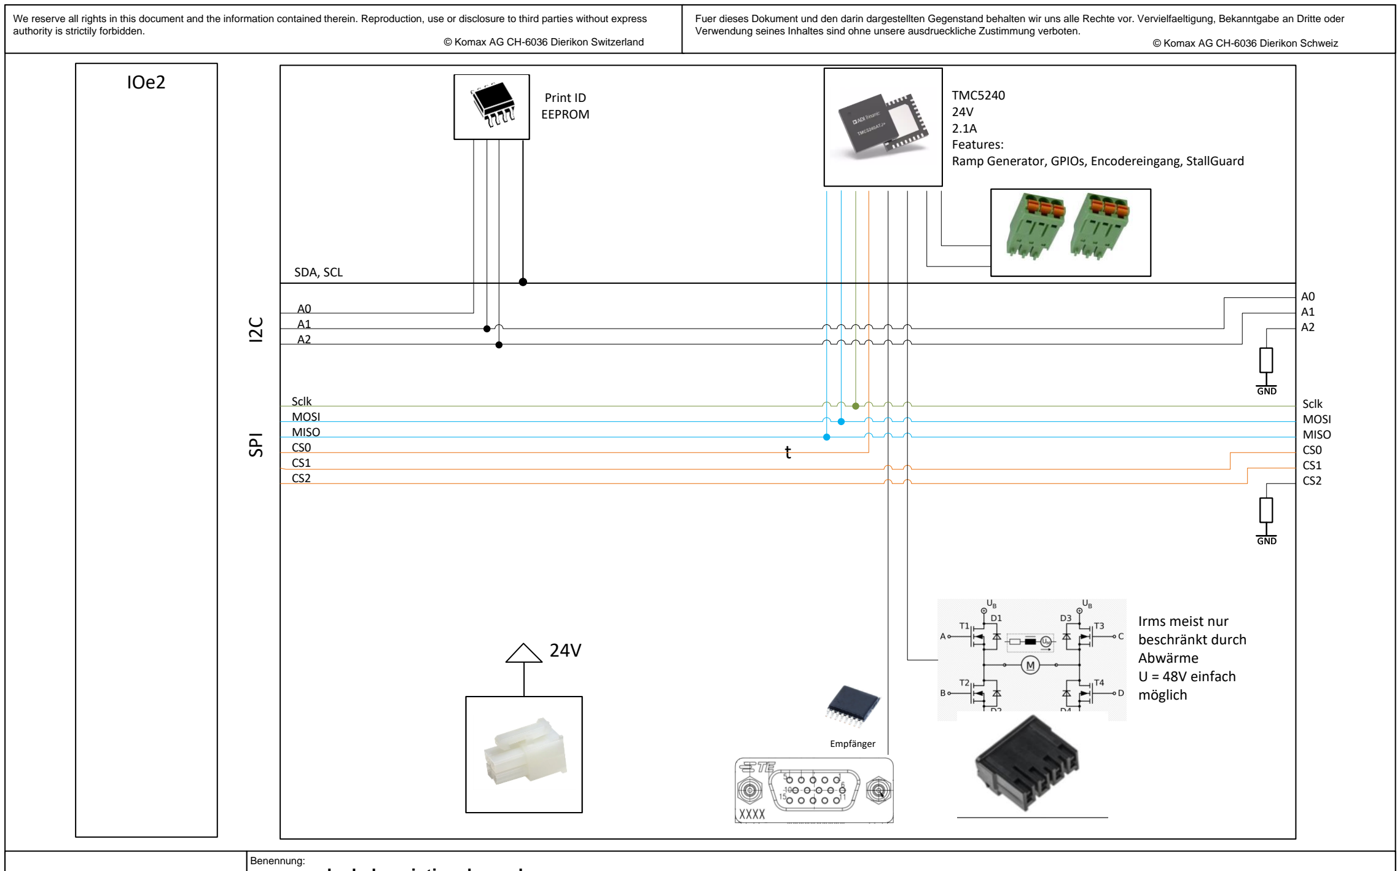
[picture p21: figure]
© Komax AG CH-6036 Dierikon Schweiz; Benennung:; GND; Sclk MOSI MISO CS0 CS1 CS2; Empfänger; Print ID EEPROM; TMC5240 24V 2.1A Features:; I2C SPI; IOe2; Irms meist nur beschränkt durch Abwärme U = 48V einfach möglich; SDA, SCL

Verwendung in ArtNr: | A4 quer | Seite: | 5 of 8

# <kxd_description_long_de>

## Ramp Generator, GPIOs, Encodereingang, StallGuard

© Komax AG CH-6036 Dierikon Schweiz

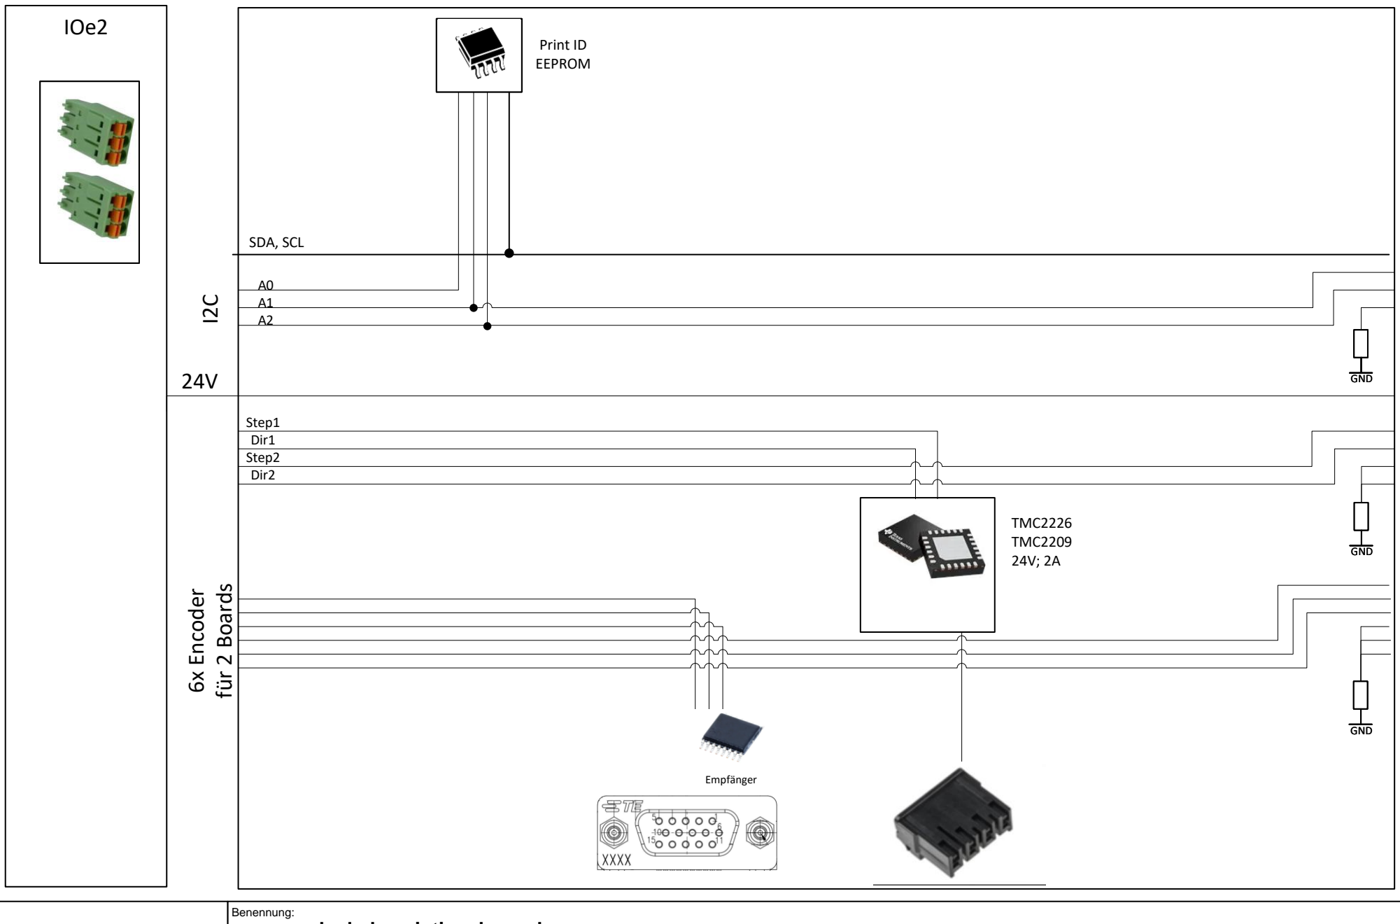
[picture p22: figure]
Benennung:; GND; Print ID EEPROM; TMC2226 TMC2209 24V; 2A; IOe2; Step1 Dir1 Step2 Dir2; 6x Encoder; für 2 Boards; Empfänger; SDA, SCL

Verwendung in ArtNr: | A4 quer | Seite: | 6 of 8

# <kxd_description_long_de>

A0
A1
A2

A0
A1

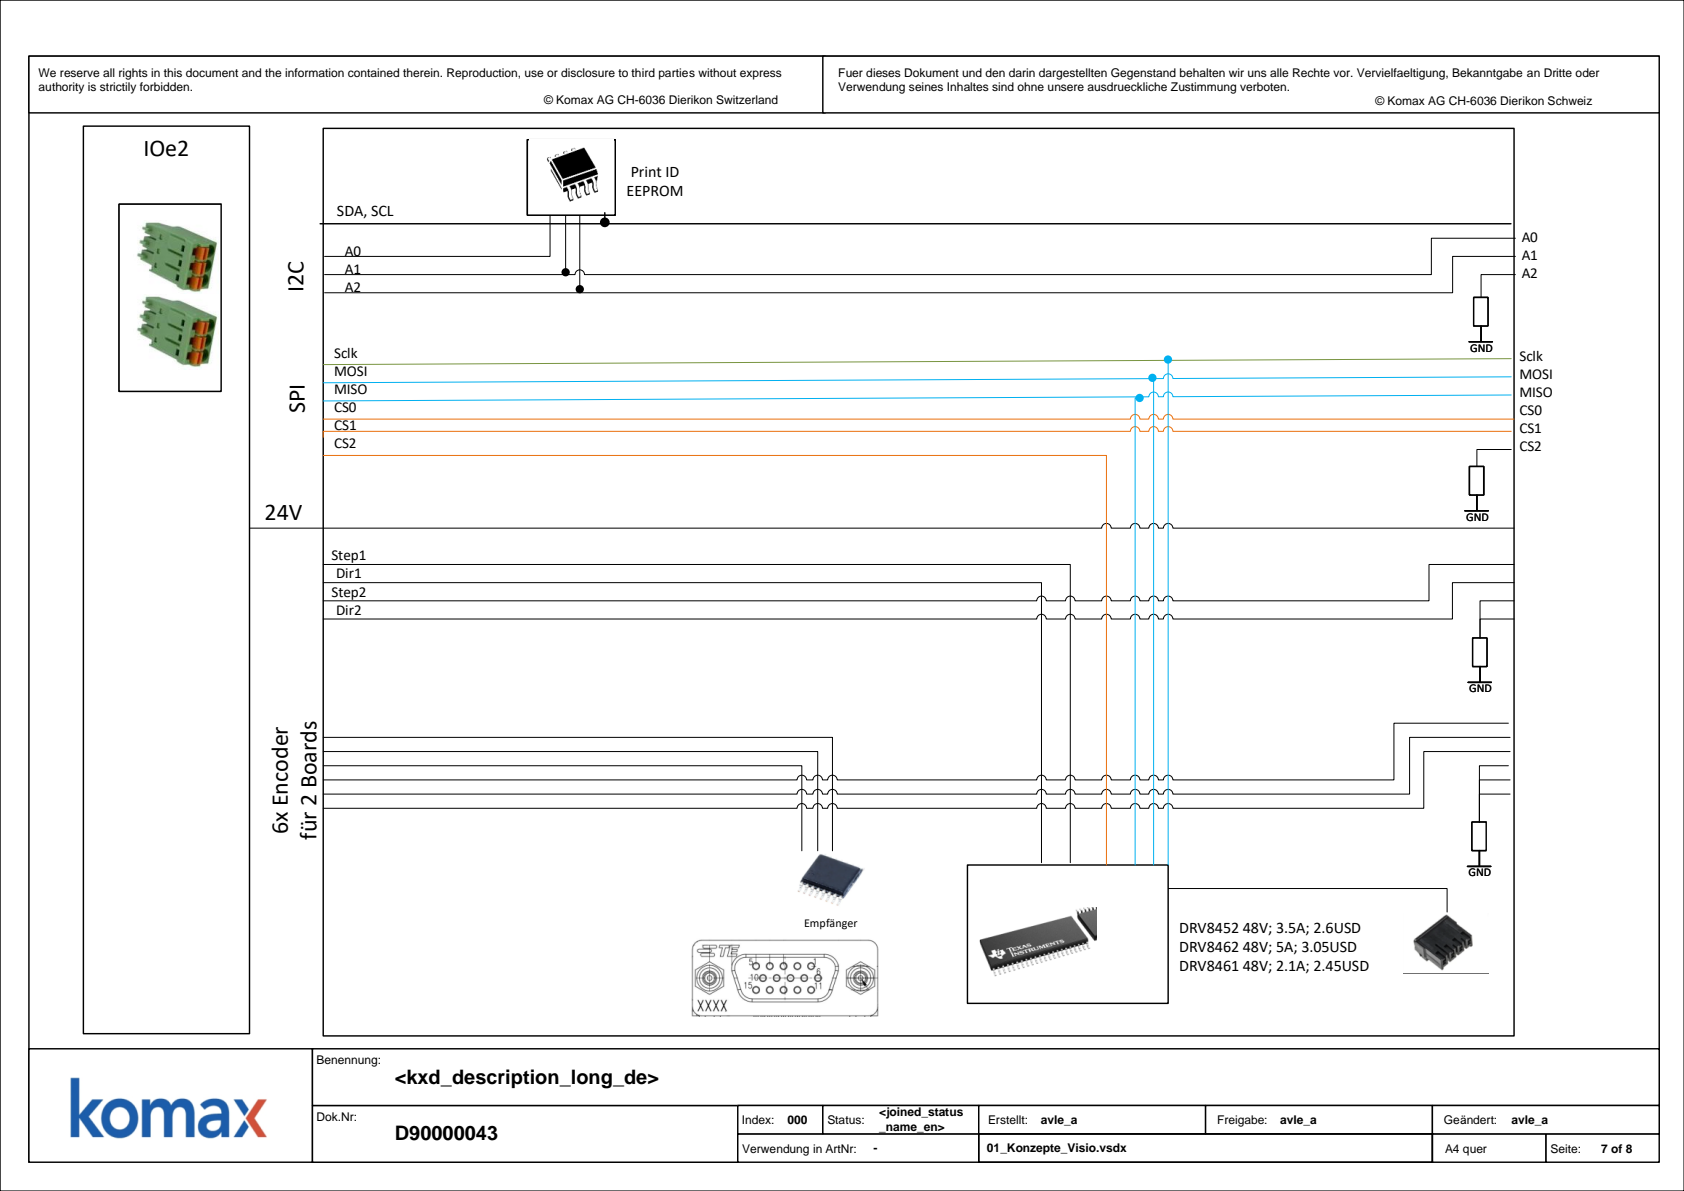
[picture p23: page 7]
Benennung:; Verwendung in ArtNr:; A4 quer; Seite:; <kxd_description_long_de>; GND; Print ID EEPROM; IOe2; Step1 Dir1 Step2 Dir2; 6x Encoder; für 2 Boards; Empfänger; Sclk MOSI MISO CS0 CS1 CS2; SPI; DRV8452 48V; 3.5A; 2.6USD DRV8462 48V; 5A; 3.05USD DRV8461 48V; 2.1A; 2.45USD; SDA, SCL

© Komax AG CH-6036 Dierikon Schweiz

© Komax AG CH-6036 Dierikon Schweiz

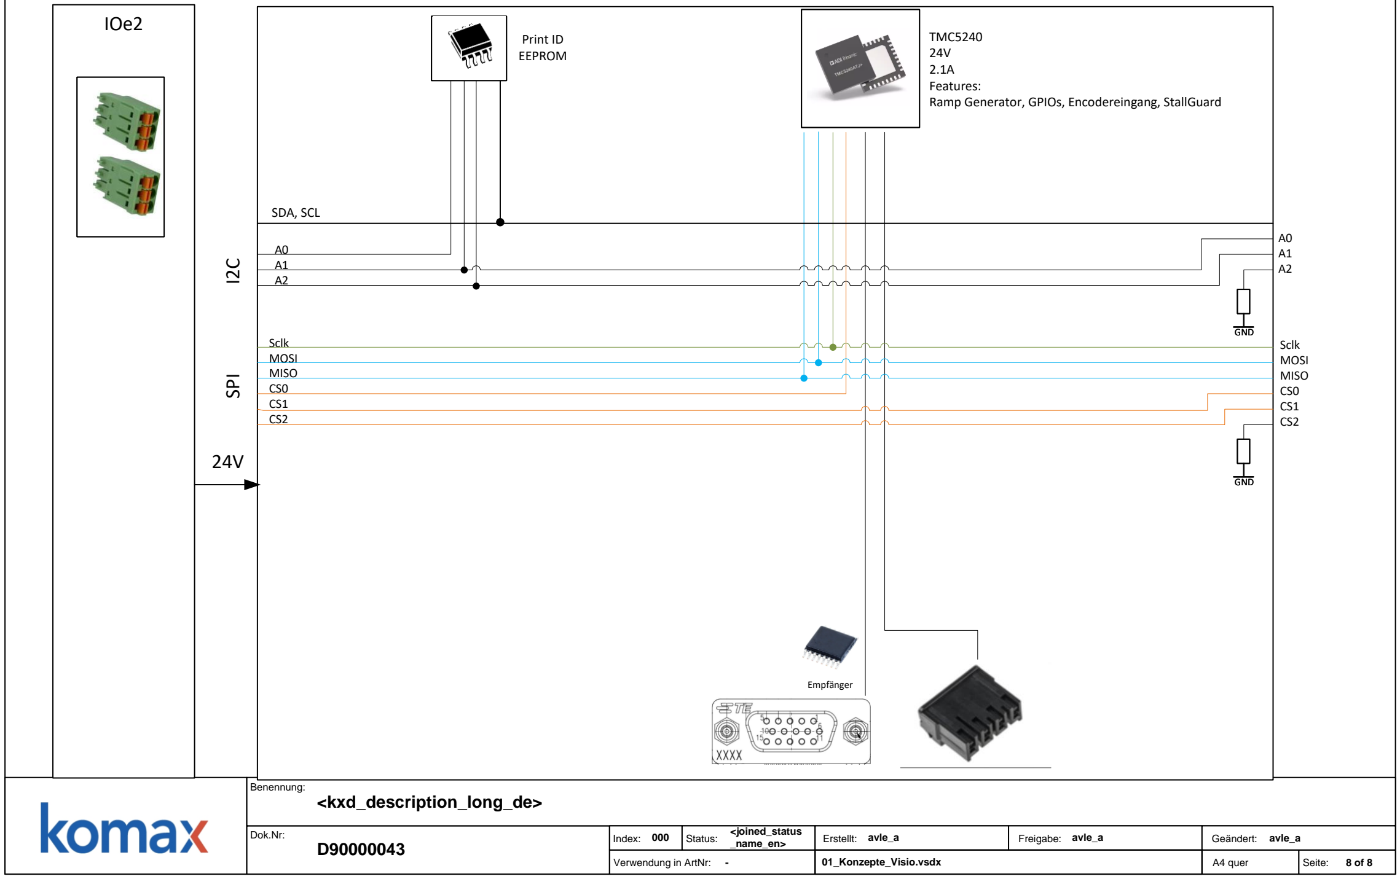
[picture p24: figure]
Benennung:; Verwendung in ArtNr:; A4 quer; Seite:; <kxd_description_long_de>; GND; Sclk MOSI MISO CS0 CS1 CS2; Empfänger; Print ID EEPROM; TMC5240 24V 2.1A Features:; I2C SPI; IOe2; SDA, SCL

## Ramp Generator, GPIOs, Encodereingang, StallGuard
