JulesBischof/Praxismodul/01_Korrespondenzen/02_Lastenheft.pdf

# EtherCAT HW IOe2 Erweiterung Stepper

## Anforderungen

Das IOe2 Stepper Erweiterungsboard (Name wird noch definiert) soll eine einfache Möglichkeit bieten einen zwei Phasen Schrittmotoren im Openloop anzusteueren. Ziel ist es den Print für einfache Stellachsen als kostengünstige Erweiterung zum IOe2Smart einsetzen zu können, ohne gleich einen SMSe zu benötigen. Fokus liegt entsprechend auf HK, Einfachheit und nicht auf Performance.

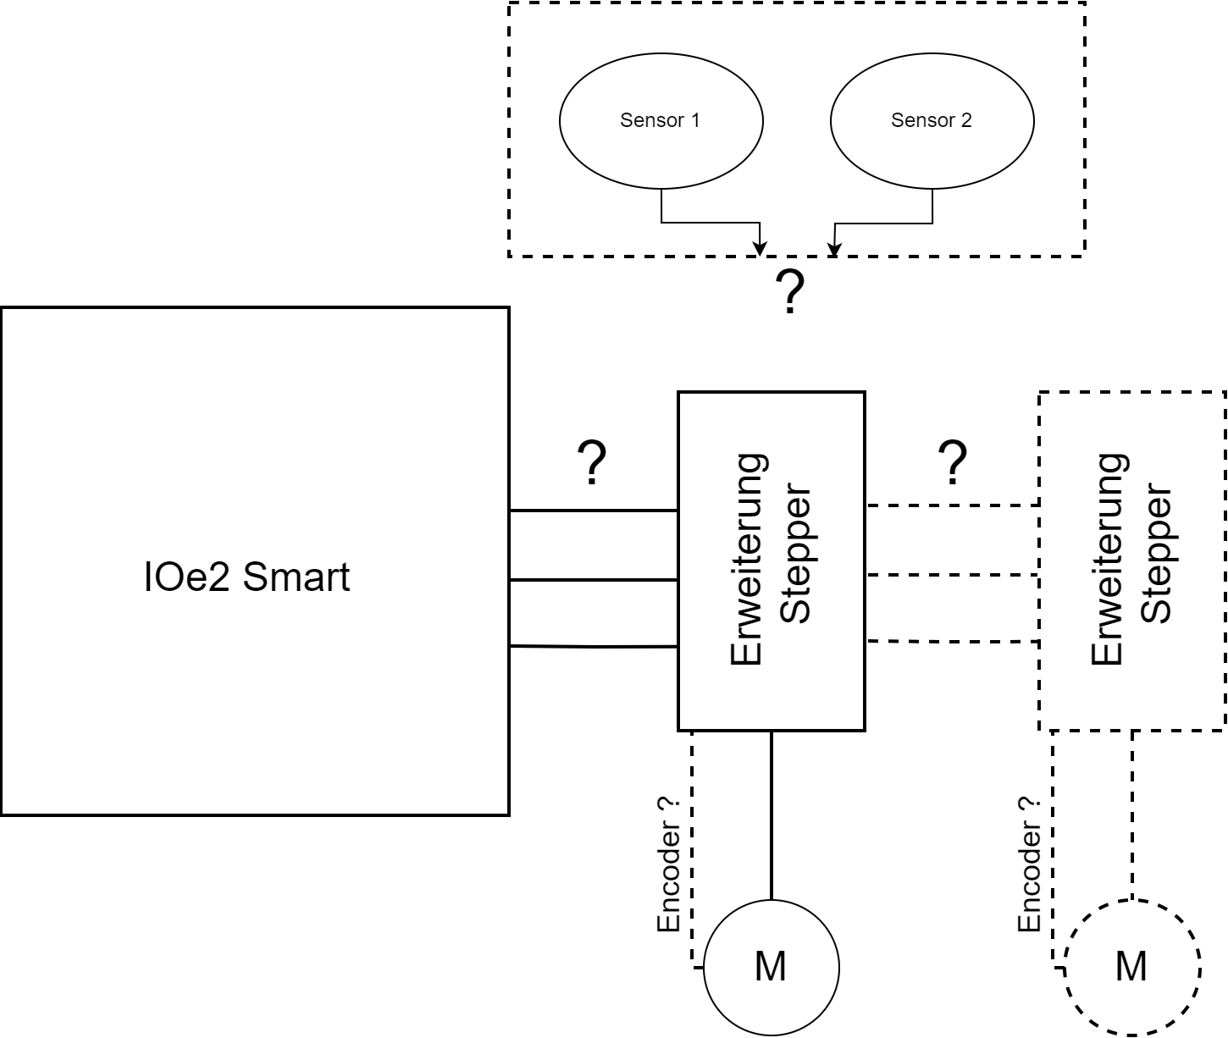
[picture p25: figure]

## Status Jira

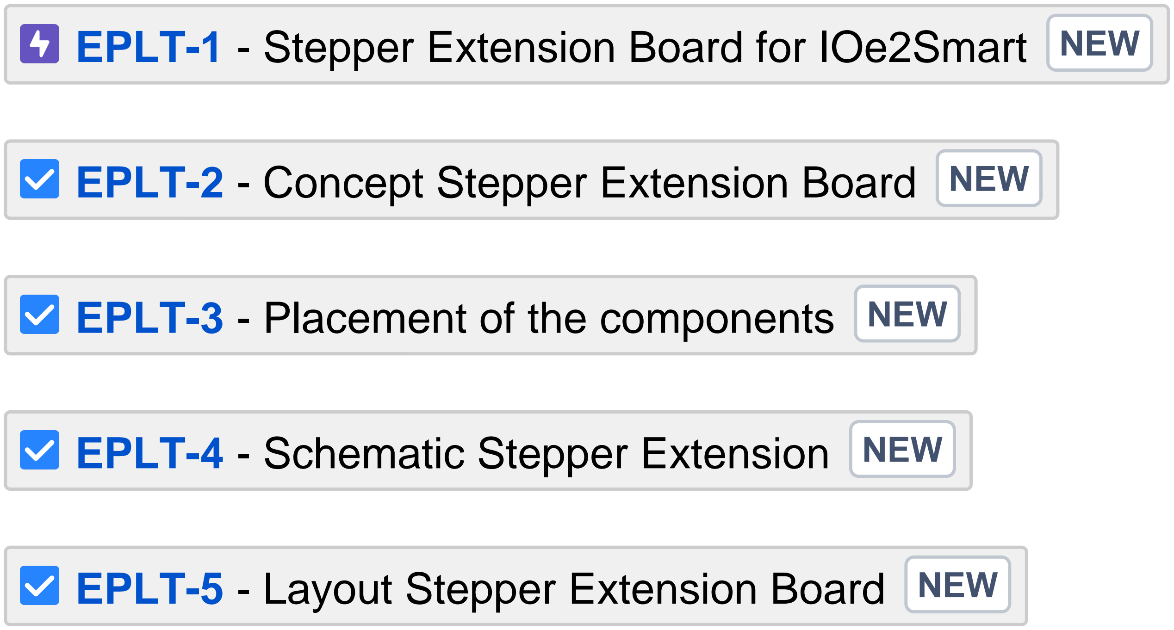
[picture p26: figure]

EPLT-1 (https://jira.komax.org/browse/EPLT-1) - Stepper Extension Board for IOe2Smart NEW

EPLT-2 (https://jira.komax.org/browse/EPLT-2) - Concept Stepper Extension Board NEW

EPLT-3 (https://jira.komax.org/browse/EPLT-3) - Placement of the components NEW

EPLT-4 (https://jira.komax.org/browse/EPLT-4) - Schematic Stepper Extension NEW

EPLT-5 (https://jira.komax.org/browse/EPLT-5) - Layout Stepper Extension Board NEW

## Pflichtenheft

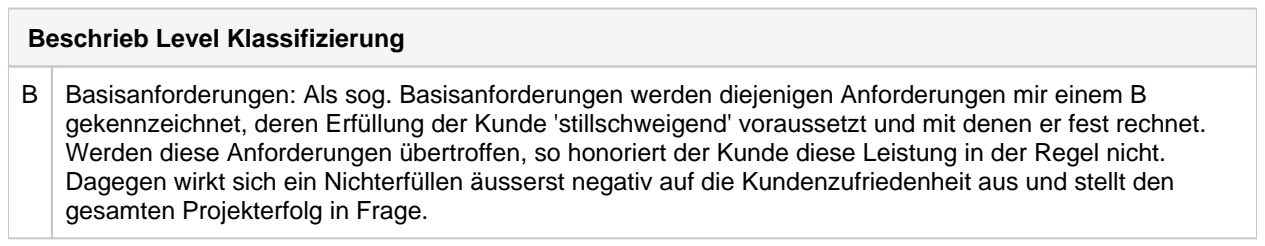
[picture p27: figure]
Beschrieb Level Klassifizierung; gesamten Projekterfolg in Frage.

B Basisanforderungen: Als sog. Basisanforderungen werden diejenigen Anforderungen mir einem B gekennzeichnet, deren Erfüllung der Kunde 'stillschweigend' voraussetzt und mit denen er fest rechnet. Werden diese Anforderungen übertroffen, so honoriert der Kunde diese Leistung in der Regel nicht. Dagegen wirkt sich ein Nichterfüllen äusserst negativ auf die Kundenzufriedenheit aus und stellt den

L Leistungsanforderungen: Extra-Leistungen, die mit Blick auf die Wettbewerber angeboten werden müssen oder angeboten werden sollten, werden als Leistungsanforderung mit einem L gekennzeichnet.

X Anforderungen für das gewisse X-tra: Mit einem X werden sog. Begeisterungsfaktoren gekennzeichnet. Dies sind Anforderungen, mit deren Erfüllung der Kunde nicht rechnet und die bei ihm starke Begeisterung und eine überaus hohe Kundenzufriedenheit auslösen.

V Verzicht: Ein Verzicht kennzeichnet eine Anforderung, auf die bewusst verzichtet wird.

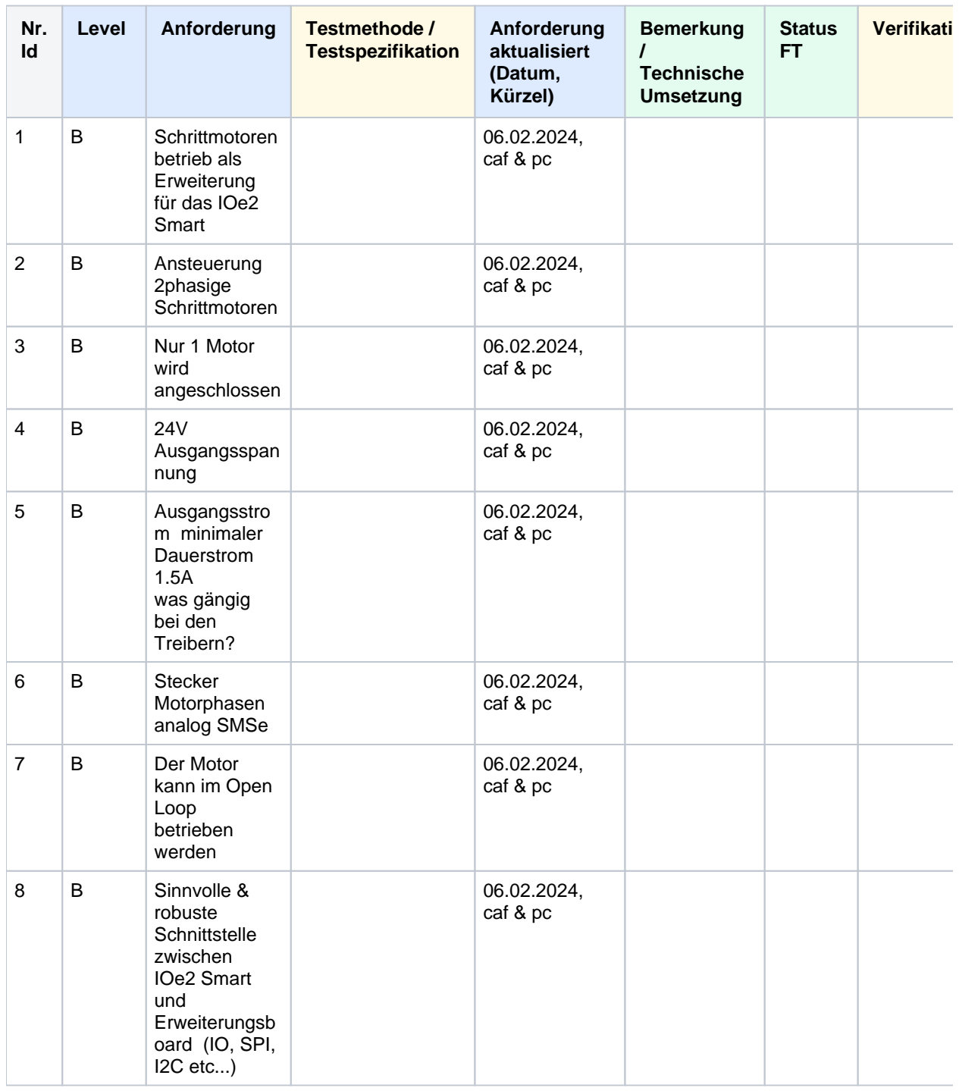
[picture p28: figure]
Level; Anforderung; Testmethode /; Testspezifikation; Anforderung aktualisiert (Datum, Kürzel); Bemerkung / Technische Umsetzung; Status FT; Verifikation; Schrittmotoren; betrieb als Erweiterung für das IOe2 Smart; 06.02.2024, caf & pc; Ansteuerung; 2phasige Schrittmotoren; Nur 1 Motor; wird angeschlossen; Ausgangsspan nung; Ausgangsstro; m minimaler Dauerstrom 1.5A was gängig bei den Treibern?; Stecker; Motorphasen analog SMSe; Der Motor; kann im Open Loop betrieben werden; Sinnvolle &; robuste Schnittstelle zwischen IOe2 Smart und Erweiterungsb oard (IO, SPI, I2C etc...)
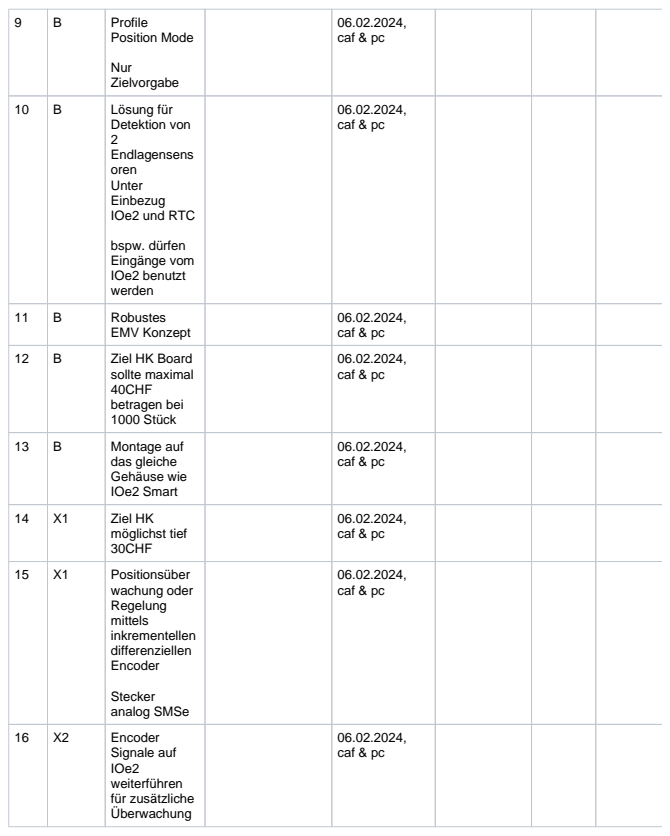
[picture p29: page 3]
Profile; Position Mode; Nur Zielvorgabe; 06.02.2024, caf & pc; Lösung für; Detektion von 2 Endlagensens oren Unter Einbezug IOe2 und RTC; bspw. dürfen Eingänge vom IOe2 benutzt werden; Robustes; EMV Konzept; Ziel HK Board; sollte maximal 40CHF betragen bei 1000 Stück; Montage auf; das gleiche Gehäuse wie IOe2 Smart; Ziel HK; möglichst tief 30CHF; Positionsüber; wachung oder Regelung mittels inkrementellen differenziellen Encoder; Stecker analog SMSe; Encoder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

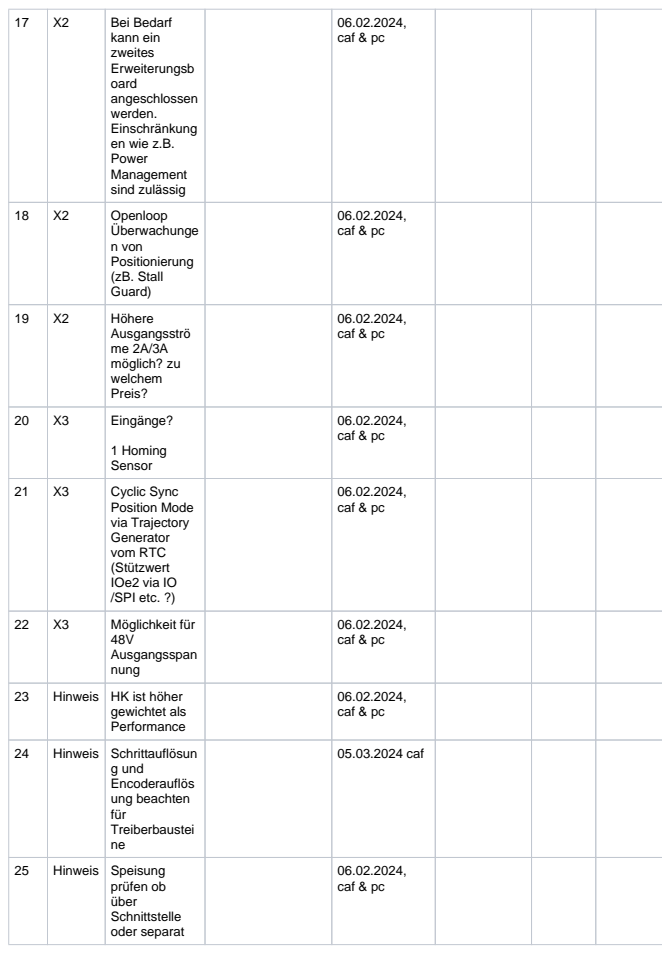
[picture p30: page 4]
Bei Bedarf; kann ein zweites Erweiterungsb oard angeschlossen werden. Einschränkung en wie z.B. Power Management sind zulässig; caf & pc; Openloop; Überwachunge n von Positionierung (zB. Stall Guard); 06.02.2024, caf & pc; Höhere; Ausgangsströ me 2A/3A möglich? zu welchem Preis?; Eingänge?; 1 Homing Sensor; Cyclic Sync; Position Mode via Trajectory Generator vom RTC (Stützwert IOe2 via IO /SPI etc. ?); Möglichkeit für; 48V Ausgangsspan nung; Hinweis HK ist höher; gewichtet als Performance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

26 Hinweis Bei Variantenausa rbeitung sollen Verkabelungsk osten mitberücksichti gt werden
caf & pc

27 Hinweis Initialisation beachten. StallGuard wird heute bspw. beim IP 3734 Motion SGuard verwendet, funktioniert einigermassen . Was haben andere Chips für Möglichkeiten?

13.02.2024 caf

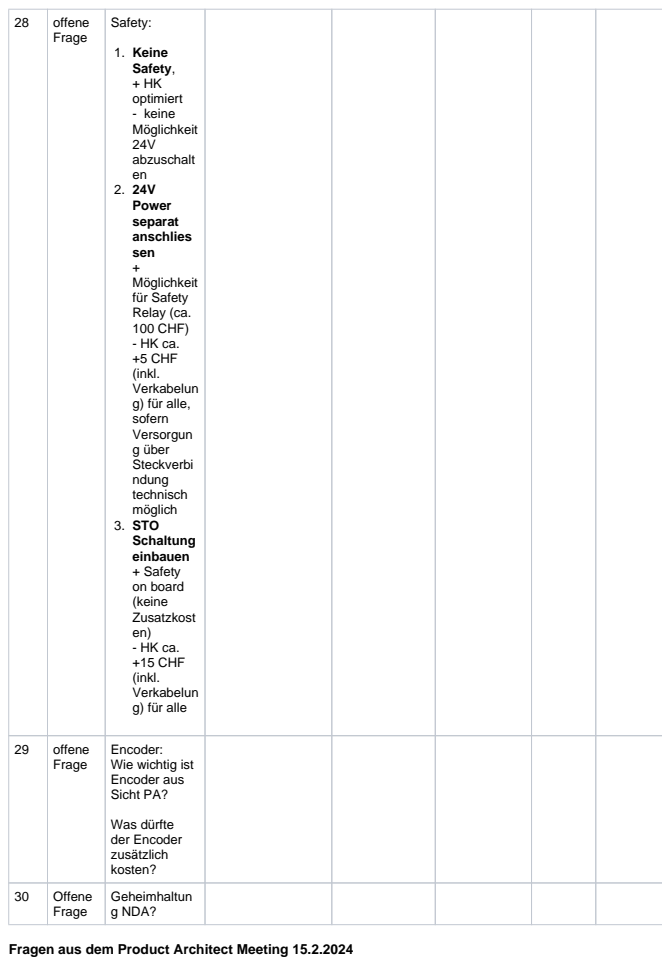
[picture p31: page 6]
offene; Frage; Safety:; Keine Safety, + HK optimiert - keine Möglichkeit 24V abzuschalt en 24V Power separat anschlies sen + Möglichkeit für Safety Relay (ca. 100 CHF) - HK ca. +5 CHF (inkl. Verkabelun g) für alle, sofern Versorgun g über Steckverbi ndung technisch möglich STO Schaltung einbauen + Safety on board (keine Zusatzkost en) - HK ca. +15 CHF (inkl. Verkabelun g) für alle; Was dürfte der Encoder zusätzlich kosten?; Offene; Geheimhaltun g NDA?

Encoder:
Wie wichtig ist
Encoder aus
Sicht PA?

Fragen aus dem Product Architect Meeting 15.2.2024

Alternativer Stepper Driver mit IO-Link. Kosten? caf
Safety: Kein PL, sondern nur Maschinenverhaltensziel mit zusätzlichem Eingang
Idee: Input vom Smart IOe verwenden. Abschaltung innerhalb Firmware des IOe behandeln. Eingang kann wegkonfiguriert werden keine zusätzlichen HK
Kontakt zu Schleuniger für Einsatz/Anwendungen oder Erfahrung einfache Stepper: Timan Schneider / Marco Wyss caf
Kosten Encoder pc
onBoard genauer schätzen
Variante: zusätzlicher ExtensionPrint für Positionsüberwachung
