JulesBischof/Praxismodul/06_Referenzen/TMC5240-EVAL/V10/BOM/TMC5240-EVAL_V10 - BOM.xlsx

Sheet: Revision History
Release | Date | Comment
TMC5240-EVAL_V10 | 2022-01-10 | First release.

Sheet: TMC5240-EVAL_V10
# | QTY | REFDES | VALUE | PACKAGE | HEIGHT | ASSY | CPN | PN | MANUFACTURER | MANUFACTURER PN | SUPPLIER | SUPPLIER PN | COMMON
1 | 1 | R202 | 0R | 0603 | 0.55 | SMD | A00561 | RE7BA082 | Panasonic | ERJ-3GEY0R00V | DigiKey | P0.0GCT-ND | X
2 | 1 | R317 | 1k8/1W | 2512 | 0.65 | SMD | A01714 | REDD95BC | TE Connectivity | CRGCQ2512F1K8 | DigiKey | A129996CT-ND | X
3 | 4 | R206-R208, R306 | 1k/1% | 0603 | 0.55 | SMD | A00314 | REE225C4 | Panasonic | ERJ-3EKF1001V | DigiKey | P1.00KHCT-ND | X
4 | 1 | C309 | 1nF/16V | 0603 | 0.9 | SMD | A01727 | CA93F477 | Yageo | CC0603KRX7R7BB102 | DigiKey | 311-4063-1-ND | X
5 | 5 | C207, C210, C215, C302, C304 | 1uF/16V | 0603 | 0.9 | SMD | A00766 | CAD76FF0 | Kemet | C0603C105K4RACTU | DigiKey | 399-7847-1-ND | X
6 | 2 | C307, C308 | 1uF/50V | 0603 | 0.95 | SMD | A01037 | CAD8CDF3 | Taiyo Yuden | UMK107AB7105KA-T | DigiKey | 587-3247-1-ND | X
7 | 2 | Q301, Q302 | 2N7002 | SOT23 | 1.1 | SMD | A00678 | TR33A3BE | Nexperia | 2N7002P,215 | DigiKey | 1727-4692-1-ND | X
8 | 1 | C208 | 4.7uF/6.3V | 0603 | 0.9 | SMD | A00940 | CA98AC49 | Samsung | CL10B475KQ8NQNC | DigiKey | 1276-2087-1-ND | X
9 | 6 | R203-R205, R209, R210, R307 | 4k7/1% | 0603 | 0.55 | SMD | A00017 | REEB20E6 | Panasonic | ERJ-3EKF4701V | DigiKey | P4.70KHCT-ND | X
10 | 3 | C211-C213 | 15pF/50V | 0603 | 0.9 | SMD | A00287 | CA23E60E | Kemet | C0603C150K5GACTU | DigiKey | 399-7854-1-ND | X
11 | 1 | C303 | 22nF/50V | 0603 | 0.9 | SMD | A00120 | CAEBF3C4 | Yageo | CC0603KRX7R9BB223 | DigiKey | 311-1370-1-ND | X
12 | 6 | R301-R305, R308 | 24k/1% | 0603 | 0.55 | SMD | A01715 | RE8DEBC2 | Panasonic | ERJ-3EKF2402V | DigiKey | P24.0KHCT-ND | X
13 | 1 | J201 | 46-3492-44-3-00-10-PPTR | HLE-122-02-F-DV | 3.7 | SMD | A01716 | CO80AAF7 | W+P | 46-3492-44-3-00-10-PPTR
14 | 1 | IC203 | 74LVC3G17 | VSSOP8 | 1 | SMD | A00031 | ICA678B7 | Nexperia | 74LVC3G17DC,125 | DigiKey | 1727-7043-1-ND | X
15 | 3 | C209, C214, C301 | 100nF/16V | 0603 | 0.9 | SMD | A00239 | CA2CAFF1 | Yageo | CC0603KRX7R7BB104 | DigiKey | 311-1088-1-ND | X
16 | 2 | C305, C306 | 100nF/50V | 0603 | 0.95 | SMD | A00331 | CA1180F6 | Murata | GRM188R71H104KA93D | DigiKey | 490-1519-1-ND | X
17 | 1 | R318 | 100R/1% | 0603 | 0.55 | SMD | A00002 | RE6FD5F9 | Panasonic | ERJ-3EKF1000V | DigiKey | P100HCT-ND | X
18 | 2 | C201, C202 | 150uF/50V | EL100 | 14 | THM | A01717 | CA52BCD9 | Panasonic | EEU-FR1H151 | DigiKey | P14456-ND
19 | 1 | IC202 | AT25128B-SSHL | SO8 | 1.75 | SMD | A00306 | IC8F93C6 | Atmel | AT25128B-SSHL | DigiKey | AT25128B-SSHL-B-ND
20 | 2 | D203, D204 | BAT54A | SOT23 | 1.1 | SMD | A01730 | DI9BE8A4 | Diodes Incorporated | BAT54A-7-F | DigiKey | BAT54A-FDICT-ND | X
21 | 1 | Q303 | DMN6075S-7 | SOT23 | 1.1 | SMD | A01199 | TREC42E2 | Diodes Incorporated | DMN6075S-7 | DigiKey | DMN6075S-7DICT-ND
22 | 1 | J302 | HEADER-1X2 | HEADER-1X2_V | 8.55 | THM | 1004-1 | CO1073A6 | Würth | 61300211121 | DigiKey | 732-5315-ND | X
23 | 1 | J205 | HEADER-1X4 | HEADER-1X4_V | 8.55 | THM | A01012 | CO9237CB | Würth | 61300411121 | DigiKey | 732-5317-ND | X
24 | 1 | J204 | HEADER-1X5 | HEADER-1X5_V | 8.55 | THM | A00722 | COD47CF4 | Würth | 61300511121 | DigiKey | 732-5318-ND | X
25 | 1 | D301 | KPT-1608EC | 0603 | 0.75 | SMD | A00848 | LEE5CE54 | Kingbright | KPT-1608EC | Farnell | 2099221
26 | 1 | IC201 | MAX8881EUT33 | SOT23-6 | 1.45 | SMD | A01723 | ICAFE088 | Maxim Integrated | MAX8881EUT33+T | DigiKey | MAX8881EUT33+TCT-ND
27 | 1 | D302 | MSS1P6 | MICROSMP | 0.8 | SMD | A00045 | DIAF8C11 | Vishay | MSS1P6-M3/89A | DigiKey | MSS1P6-M3/89AGICT-ND
28 | 1 | J303 | PT113-T182-02 | PT113-T182-02 | 8.7 | THM | A01718 | COE63B9B | Metz Connect | 31182102 | Farnell | 2434322
29 | 1 | J203 | PT113-T182-04 | PT113-T182-04 | 8.7 | THM | A01719 | CO4D1B14 | Metz Connect | 31182104 | Farnell | 2434324
30 | 1 | J202 | PT115-T330-02 | PT115-T330-02 | 8.4 | THM | A01720 | CO0C6E35 | Metz Connect | 31330102 | Farnell | 2774498
31 | 1 | IC301 | TMC5240 | TQFN32 | 0.8 | SMD | A01731 | IC7BE886 | Trinamic | TMC5240-LA | Trinamic | TMC5240-LA
32 | 1 | D201 | TPSMB36A | SMB | 2.45 | SMD | A01725 | DIEEB70E | Littelfuse | TPSMB36A | DigiKey | F6324CT-ND
DO NOT MOUNT:
# | QTY | REFDES | VALUE | PACKAGE | HEIGHT | ASSY | CPN | PN | MANUFACTURER | MANUFACTURER PN | SUPPLIER | SUPPLIER PN | COMMON
1 | 2 | R201, R309 | 0R | 0603 | 0.55 | SMD | A00561 | RE7BA082 | Panasonic | ERJ-3GEY0R00V | DigiKey | P0.0GCT-ND | X
2 | 4 | C203-C206 | 1nF/100V | 0603 | 0.9 | SMD | CA7BA082 | CA7BA082 | Kemet | C0603C102K1RACTU | DigiKey | 399-7831-1-ND | X
3 | 1 | R312 | 4k7/1% | 0603 | 0.55 | SMD | A00017 | REEB20E6 | Panasonic | ERJ-3EKF4701V | DigiKey | P4.70KHCT-ND | X
MATING CONNECTORS:
# | QTY | REFDES | VALUE | PACKAGE | HEIGHT | ASSY | CPN | PN | MANUFACTURER | MANUFACTURER PN | SUPPLIER | SUPPLIER PN | COMMON
1 | 1 | Connect to J202 | RP015-T349-02 |  |  |  | A00999 |  | Metz Connect | 31349102 | Farnell | 2774518
2 | 1 | Connect to J203 | RP013-T169-02 |  |  |  | A01722 |  | Metz Connect | 31169104 | Farnell | 2434300
3 | 1 | Connect to J303 | RP013-T169-02 |  |  |  | A01721 |  | Metz Connect | 31169102 | Farnell | 2434298
