JulesBischof/Praxismodul/05_Kostenanalysen/03_DRAFT01_Kostenaufstellung.xlsx

Schemaseite | Beschreibung | Bauteil | Distributor | CHF/stk@1000 Prints | Anzahl | Bestückung | Preis total
Interface | Stecker_mal | NOCH NICHT GANZ GEKLÄRT |  | 5 | 1 | 0.04 | 3.39 | 50p Var | 154765-E | mouser | 3.35
 | Stecker_fem | NOCH NICHT GANZ GEKLÄRT |  | 5 | 1 | 0.04 | 2.64 | 50p Var | 124045-E | mouser | 2.6
Speisung | CM-Choke | PA3927NLT | DigiKey | 1.64 | 1 | 0.04 | 1.68
 | LDO | AP2125N-3.3TRG1 | DigiKey | 0.08254 | 1 | 0.04 | 0.12254
 | P-MOSFET | DMP3013SFV-7 | DigiKey | 0.19 | 1 | 0.04 | 0.23
 | R's |  |  | 0.003811328125 | 3 | 0.04 | 0.1314339844
 | C's |  |  | 0.01031294574 | 5 | 0.04 | 0.2515647287
 | Z-Diode | BZT52H-C36,115 | mouser | 0.03 | 1 | 0.04 | 0.07
Motorentreiber | Treiber | TMC5240 | ADI | 3.26 | 1 | 0.04 | 3.3
 | Grosser Elko | EE-TK1J471AM | DigiKey | 1.09271 | 1 | 0.04 | 1.13271
 | R's |  |  | 0.003811328125 | 4 | 0.04 | 0.1752453125
 | C's |  |  | 0.01031294574 | 9 | 0.04 | 0.4528165116
 | LED's |  |  | 0.04 | 2 | 0.04 | 0.16
 | Cock | 831025494 | DigiKey | 0.8918 | 1 | 0.04 | 0.9318
Encoder Connection | DSUB-Stecker | L77HDE15SD1CH4R | DigiKey | 1.13753 | 1 | 0.04 | 1.17753
 | Shortcirc. Prot | TPS2051CDBVR | Mouser | 0.235 | 1 | 0.04 | 0.275
 | TVS Dioden | D5V0L2B3SO-7 | Mouser | 0.048 | 3 | 0.04 | 0.264
 | TVS Dioden | P6SMB6.8A | DigiKey | 0.09581 | 1 | 0.04 | 0.13581
 | RS422-Reciever | AM26LV32IDR | Mouser | 0.641 | 1 | 0.04 | 0.681
 | R's |  |  | 0.003811328125 | 11 | 0.04 | 0.4819246094
 | C's |  |  | 0.01031294574 | 10 | 0.04 | 0.5031294574
Motor Connector | TVS Diode | V3FM15-M3/H | Mouser | 0.063 | 8 | 0.04 | 0.824
 | CM-Choke | ECMS1V0905-102-R | Mouser | 0.44555 | 2 | 0.04 | 0.9711
 | Stecker | DF63M-4P-3.96DSA | Mouser | 0.227 | 1 | 0.2 | 0.427
Print ID | EEPRom | M24128-BFMC6TG | Mouser | 0.313 | 1 | 0.04 | 0.353
 | R's |  |  | 0.003811328125 | 2 | 0.04 | 0.08762265625
 | C's |  |  | 0.01031294574 | 2 | 0.04 | 0.1006258915
 |  |  |  | Komponentenkosten |  |  | 20.94985315
 |  |  |  | Rüstkostenpauschale |  |  | 1
 |  |  |  | Leiterplattenpauschale |  |  | 6
 |  |  |  | total |  |  | 27.94985315
