JulesBischof/Praxismodul/02_Recherche/03_Verschiedene_Chips.xlsx

Trinamic Suche - integrated smart driver |  |  | usteps 256 |  |  |  |  |  |  |  | Package
Part | 1ku price USD | supply voltage | phase current | communication | Feedback | Motioncontrol
TMC2210 | 2.78 - 3.06 | 4,5 - 36 | 2,1 | Step/Dir | - | MicroPlyer, Passive Braking, SpreadCycle, StealthChop2 | kein Profile mode!
TMC5240 | 3.26 - 3.59 | 4,5 - 36 | 2,1 | SPI, UART | Enc & 2x Ref Sw. In | CoolStep, MicroPlyer, Passive Braking, SpreadCycle, StallGuard2, StallGuard4, StealthChop2 | Profile Generator on board! |  |  | Preis octoparts 4 - 5 dollar | TSSOP38 | TQFN32 | ähnlich: TMC2240, aber ohne Inputs
TMC2240 | 2.78 - 3.06 | 4,5 - 36 | 2,1 | 1wire UART, SPI, Step/Dir | Enc | CoolStep, MicroPlyer, Passive Braking, SpreadCycle, StallGuard2, StallGuard4, StealthChop2 | kein Profile mode!
TMC2260 | 3,44 | 5,0 - 30 | 2,8 | SPI, Step/Dir | - |  | kein Profile mode!
TMC2226 | 1,89 | 5-36V | 2 | Step/Dir, UART | - | CoolStep, MicroPlyer, SpreadCycle, StallGuard4, StealthChop2 | kein Profile mode!
TMC2209 | 1,86 | 5-29V | 2 | Step/Dir, UART | - | CoolStep, MicroPlyer, SpreadCycle, StallGuard4, StealthChop2 | kein Profile mode!
TMC2660C | 3.44 | 5-30V | 2.8 | SPI,Step/Dir | - | CoolStep, MicroPlyer, SpreadCycle, StallGuard2 | kein Profile mode!
Trinamic Suche - ohne Endstufe
TMC262 | 4.62 | 5-60V | ohne Endstufe | SPI,Step/Dir | - | 256 µSteps, CoolStep, StallGuard2 and SpreadCycle
TMC2160 | 3.01 | 8-60V | ohne Endstufe | SPI,Step/Dir | - | 256 µSteps, CoolStep, StallGuard2, SpreadCycle and StealthChop2
TMC5160 | 3.4(mouser) | 8 - 60V | ohne Endstufe | Step/Dir, SPI | Enc & 2x Ref Sw. In |  | OHNE H - BRÜCKE
Trinamic Suche - reine Treiberbausteine |  |  | usteps 128
Part | 1ku price USD | supply voltage | phase current | communication | Feedback | Motioncontrol
MAX22210 | 1,51 | 36V | 2
Trinamic Suche - reine Motion Controller
Part | 1ku price USD | supply voltage | phase current | communication | Feedback | Motioncontrol
TMC429 | 6.7 |  |  | SPI | - | Microstep Table, Ramp Generator
TMC4361 | 7.86 |  |  | PWM, SPI, SSI, Step/Dir | encoder, refwitch | ChopSync, Closed Loop, DcStep, Ramp Generato
TMC454 | ? |  |  | IIC, SPI | encoder, refwitch | Microstep Table | altes teil (2009)
Texas Industries Suche
Part | 1ku price USD | supply voltage | phase current | communication | Feedback | Motioncontrol
DRV8461 | 2.45 | 4.5 - 65V | 2.1 | SPI / STEP/DIR | - | Current Regulation, Integrated Current Sensing, Open-Load Detection, Smart Tune, Stall Detection | kein Profile mode! | Daisychain SPI ready
DRV8462 | 3.67 | 4.5-65V | 7 | SPI / STEP/DIR | - | smart tune, stall detect and auto-torque
DRV8424 | 1.26 | 4.5 - 35V | 1.8 | STEP/DIR | - | Current Regulation,Integrated Current Sensing,Smart Tune
DRV8425 | 1.2 | 24V | 2 | STEP/DIR | - | 265 usteps, current regulation, smart tune(tune decay - different options)
DRV8886 | 1.356 | 24V | 2 | STEP/DIR | - | 16usteps
DRV8811 | 1.292 | 24V | 1.9 | STEP/DIR | - | 8usteps
STMicroelectronicss Suche - intergrated driver
Part | 1ku price USD | supply voltage | phase current | communication | Feedback | Motioncontrol
powerSTEP01 | 7.48 | 7.5 - 85V | 10 | SPI |  | 1/128 usteps, Stalldetection, overcurrent detection, Programmable Speed Profile
STMicroelectronicss Suche - reiner Treiberbaustein
Part | 1ku price USD | supply voltage | phase current | communication | Feedback | Motioncontrol
L6209 | 5.6114 | 8-52V | 2.8 | Paralell |  | fast&slow decay, fullstep & half step, full current protection |  |  | Kein Stallguard!!!
L6470 | 3.555 - 4.1167 | 8-45V | 3A | SPI |  | 1/128 usteps, stall detection, overcurrentprotection, programmable speed profile & positioning | Profile Generator on board!
L6472 | 3.555 - 4.1167 | 8-45V | 3A | SPI |  | 1/16 usteps, overcurrentprotection, programmable speed profile, Programmable non-dissipative overcurrent protection on all power MOS??, Two-level overtemperature protection | nur Geschwindigkeitsvorgabe mögl |  | Kein Stallguard!!!
L6474 | 2.9561 - 3.36 | 8-45V | 3A | Paralell, SPI |  | wie eins drüber, fokus der Funktinnen vor allem auf Protection-Features. A very rich set of protections (thermal, low bus voltage, overcurrent) makes the L6474 device “bullet proof” as required by the most demanding motor control applications |  |  | Kein Stallguard!!!
STSPIN820 | 1.98 | 7-45V | 1.5A | Step/Dir |  | rein Stromgesteuert!! 1/256usteps, full protection set,
TEA3718 | 1.67 - 1.98 | 10-50V | 1.5A | 2xParalell |  | ALT (2009) & treibt nur eine Windung. Braucht also 6 Outpus aus ioe … nee
Toshiba
Part | 1ku price USD | supply voltage | phase current | communication | Feedback | Motioncontrol
TB67S105FTG | (octoparts)22 | 50 | 3 | 8bit shift register | - | Thermal shutdown (TSD), over current shutdown (ISD), and power on reset(POR), Chopping frequency of a motor can be customized, full and half step 4 bit (16 steps) adjustable torque function
TB67S265FTG | (octoparts)1.35 | 50 | 2 | 8bit shift register | - | Thermal shutdown (TSD), over current shutdown (ISD), and power on reset(POR), Chopping frequency of a motor can be customized, full and half step 4 bit (16 steps) adjustable torque function
TB62214AFG | (octoparts)1.482 | 40 | 2 | clock |  | n (TSD), overcurrent shutdown (ISD), and power-on-resets (PORs)
TB67S269FTG | (octoparts)1.32 | 50 | 2 | clock |  | half, quarter, 1/8, 1/16, 1/32 step operation, (Advanced Dynamic Mixed Decay), Error detection (TSD/ISD)
TB62208FTG | (octoparts)1.45 | 40 | 1.8 | Phase
Encoder Empfänger
