JulesBischof/Praxismodul/05_Kostenanalysen/00_Kosten.xlsx

Sheet: Kostenanalys_Features
Feature | Standartkomponenten Anzahl |  |  |  | S-Faktor: | 1.1 |  |  | Stecker |  |  |  |  | IC's |  |  |  |  | sonstiges |  |  |  |  | Kosten/Komponente
 | R | C | L | D | Q | Komp | Bestück. | CHF/tot | Bez. | Bestück. | CHF/stück | Anzahl | CHF/tot | Bez. | Bestück. | CHF/stück | Anzahl | CHF/tot | Bez. | Bestück. | CHF/stück | Anzahl | CHF/tot | R | C | L | D | Q(FETS)
ext Speisung | 10 | 10 |  | 4 | 2 | 1.011256492 | 1.04 | 2.051256492 | Molex Minifit print | 0.2 | 0.2 | 2 | 0.8 |  |  |  |  |  | Filter/Drossel | 0.04 | 0.85 | 2 | 1.78 | 0.001 | 0.002 | 0.16765 | 0.03312133333 | 0.378419375
9.92 |  |  |  |  |  |  |  |  | Molex Minifit steck | 2.28 | 0.03 | 1 | 2.31 |  |  |  |  |  | Ferritkern? | 0.04 | 0.511 | 2 | 1.102
Molex MiniFit |  |  |  |  |  |  |  |  | Crimpkontakte/AEH | 0.58 | 0.1 | 2 | 1.36 |  |  |  |  |  | litzen | 0.1 | 0.16 | 2 | 0.52
7.733256492 | 2 | <- Kabel Mouser@1000 |  | 4.19 | <- Kabel Komax |  |  | 2.051256492 |  |  |  |  | 4.47 |  |  |  |  | 0 |  |  |  |  | 3.402
ext Speisung | 10 | 10 |  | 4 | 2 | 1.011256492 | 1.04 | 2.051256492 | Dinkle_4P_print | 0.2 | 1.42 | 1 | 1.62 |  |  |  |  |  | Filter/Drossel | 0.04 | 0.85 | 2 | 1.78
9.81 |  |  |  |  |  |  |  |  | Dinkle_4P_Litz | 0.2 | 1.6 | 1 | 1.8 |  |  |  |  |  | Ferritkern? | 0.04 | 0.511 | 2 | 1.102
Dinkle |  |  |  |  |  |  |  |  | AEH | 0.45 | 0.02 | 2 | 0.94 |  |  |  |  |  | litzen | 0.1 | 0.16 | 2 | 0.52
 |  |  |  |  |  |  |  | 2.051256492 |  |  |  |  | 4.36 |  |  |  |  | 0 |  |  |  |  | 3.402
Speisung IOe2 | 10 | 10 |  | 4 | 2 | 0.1787338667 | 1.04 | 1.218733867 |  |  |  |  |  |  |  |  |  |  | Filter/Drossel | 0.04 | 0.85 | 2 | 1.78
4.1 |  |  |  |  |  |  |  |  |  |  |  |  |  |  |  |  |  |  | Ferritkern? | 0.04 | 0.511 | 2 | 1.102
 |  |  |  |  |  |  |  | 1.218733867 |  |  |  |  | 0 |  |  |  |  | 0 |  |  |  |  | 2.882
Leiterplatte |  | 4 |  |  |  | 0.0088 | 0.16 | 0.1688 | Interface Ioe | 0.04 | 3.25935 | 2 | 6.5987 | I2C PrintID | 0.02 | 0.32756 | 1 | 0.34756 | Leiterplatte |  | 6 | 1 | 6
15.36606 |  |  |  |  |  |  |  |  | Motorstecker | 0.2 | 0.511 | 1 | 0.711 |  |  |  |  |  | Filter/Drossel |  | 0.77 | 2 | 1.54
 |  |  |  |  |  |  |  | 0.1688 |  |  |  |  | 7.3097 |  |  |  |  | 0.34756 |  |  |  |  | 7.54
Encoderstecker | 12 | 6 |  |  |  | 0.0264 | 0.72 | 0.7464 | Encoder Stecker | 0.2 | 1.01 | 1 | 1.21 | Diff. Reciever | 0.04 | 0.65565 | 1 | 0.69565
2.65205
 |  |  |  |  |  |  |  | 0.7464 |  |  |  |  | 1.21 |  |  |  |  | 0.69565 |  |  |  |  | 0
Inp OnBoard | 5 | 4 |  | 2 |  | 0.08716693333 | 0.44 | 0.5271669333 | MTA100 | 0.2 | 0.395 | 1 | 0.595 | HexTrigger | 0.04 | 0.054 | 1 | 0.094
1.216166933
 |  |  |  |  |  |  |  | 0.5271669333 |  |  |  |  | 0.595 |  |  |  |  | 0.094 |  |  |  |  | 0
MCU on Board | 8 | 8 |  |  |  | 0.0264 | 0.64 | 0.6664 |  |  |  |  |  | STM32C011F6P6 | 0.04 | 0.746 | 1 | 0.786 | Spannungsregler | 0.04 | 0.09421 | 1 | 0.13421
1.58661
Wie kalkulieren |  |  |  |  |  |  |  | 0.6664 |  |  |  |  | 0 |  |  |  |  | 0.786 |  |  |  |  | 0.13421
Treiber+Index | 5 | 10 |  |  |  | 0.0275 | 0.6 | 0.6275 |  |  |  |  |  | Baustein | 0.04 | 3.67 | 1 | 3.71 | Dicke Elkos | 0.2 | 0.08068 | 2 | 0.56136
4.89886 | TMC5240 | DRV8424 | DRV8462 |  |  |  |  |  |  |  |  |  |  |  | TMC5240 | DRV8424 | DRV8462
1.8-2.1A ; 24V | 3.59 | 1.26 | 3.67 |  |  |  |  |  |  |  |  |  |  |  | 3.59 | 1.26 | 3.67
Step/Dir, StGrd | 4.77886 | 2.44886 | 4.85886 |  |  |  |  | 0.6275 |  |  |  |  | 0 |  |  |  |  | 3.71 |  |  |  |  | 0.56136
Treiber+Index | 5 | 10 |  |  |  | 0.0275 | 0.6 | 0.6275 |  |  |  |  |  | Baustein | 0.04 | 3.5 | 1 | 3.54 | Dicke Elkos | 0.2 | 0.08068 | 2 | 0.56136
4.72886 |  |  |  |  |  |  |  |  |  |  |  |  |  | z.B.
2.8A ; 24V |  |  |  |  |  |  |  |  |  |  |  |  |  | TMC2260
Step/Dir, StGrd |  |  |  |  |  |  |  | 0.6275 |  |  |  |  | 0 |  |  |  |  | 3.54 |  |  |  |  | 0.56136
Treiber+Index | 5 | 10 |  |  |  | 0.02528141229 | 0.6 | 0.6252814123 |  |  |  |  |  | Baustein | 0.04 | 7.4868 | 1 | 7.5268 | Dicke Elkos | 0.2 | 0.08068 | 2 | 0.56136
8.713441412 |  |  |  |  |  |  |  |  |  |  |  |  |  | PowerStep01
10A ; 48V
Step/Dir, StGrd |  |  |  |  |  |  |  | 0.6252814123 |  |  |  |  | 0 |  |  |  |  | 7.5268 |  |  |  |  | 0.56136
Treiber+Index | 5 | 10 |  |  |  | 0.0275 | 0.6 | 0.6275 |  |  |  |  |  | Baustein | 0.04 | 3.67 | 1 | 3.71 | Dicke Elkos | 0.2 | 0.08068 | 2 | 0.56136
4.89886 |  |  |  |  |  |  |  |  |  |  |  |  |  | z.B.
7A; 48V |  |  |  |  |  |  |  |  |  |  |  |  |  | DRV8462
Step/Dir, StGrd |  |  |  |  |  |  |  | 0.6275 |  |  |  |  | 0 |  |  |  |  | 3.71 |  |  |  |  | 0.56136
Indexer | 5 | 5 |  |  |  | 0.0165 | 0.4 | 0.4165 |  |  |  |  |  | Baustein | 0.04 | 3.01 | 1 | 3.05
3.4665 |  |  |  |  |  |  |  |  |  |  |  |  |  | z.B.
Ohne Endstufe |  |  |  |  |  |  |  |  |  |  |  |  |  | TMC2160
Step/Dir, StGrd |  |  |  |  |  |  |  | 0.4165 |  |  |  |  | 0 |  |  |  |  | 3.05
Eigene Endstufe | 12 | 8 |  |  |  | 0.0308 | 0.8 | 0.8308 |  |  |  |  |  | N_Channel MOSFET | 0.04 | 0.47146 | 8 | 4.09168 | Dicke Elkos | 0.2 | 0.08068 | 2 | 0.56136
5.48384 |  |  |  |  |  |  |  |  |  |  |  |  |  |  | 40A-> | 0.719
 |  |  |  |  |  |  |  |  |  |  |  |  |  |  | oben 7A
 |  |  |  |  |  |  |  | 0.8308 |  |  |  |  | 0 |  |  |  |  | 4.09168 |  |  |  |  | 0.56136
Shift f. I2C | 5 | 5 |  |  |  | 0.0165 | 0.4 | 0.4165 |  |  |  |  |  | Schiebereg. | 0.04 | 0.0154 | 1 | 0.0554
 |  |  |  |  |  |  |  | 0.4165 |  |  |  |  |  |  |  |  |  | 0.0554
Treiber vollInt. | 5 | 10 |  |  |  | 0.0275 | 0.6 | 0.6275 |  |  |  |  |  | Baustein | 0.04 | 3.91161 | 1 | 3.95161 | Dicke Elkos | 0.2 | 0.08068 | 1 | 0.28068
4.85979
2.1A; 24V
SPI, Step/dir |  |  |  |  |  |  |  | 0.6275 |  |  |  |  | 0 |  |  |  |  | 3.95161 |  |  |  |  | 0.28068
Indexer vollInt. | 5 | 10 |  |  |  | 0.0275 | 0.6 | 0.6275 |  |  |  |  |  | Baustein | 0.04 | 3.91161 | 1 | 3.95161 | Dicke Elkos | 0.2 | 0.08068 | 1 | 0.28068
4.85979
2.1A; 24V
SPI, Step/dir |  |  |  |  |  |  |  | 0.6275 |  |  |  |  | 0 |  |  |  |  | 3.95161 |  |  |  |  | 0.28068

Sheet: Morphologischer Kasten
 |  |  |  |  |  |  |  | Konzept 1 |  | Konzept 2 |  | Konzept 3 |  | Konzept 4 |  | Konzept 5 |  | Konzept 6 |  | Konzept 7 |  | Konzept 8
 |  |  |  |  |  |  | Leiterplatte |  | 15.36606 |  | 15.36606 |  | 15.36606 |  | 15.36606 |  | 15.36606 |  | 15.36606 |  | 15.36606 |  | 15.36606
 |  |  |  |  |  |  | 15.36606
1 | Chip | Treiber+Indexer | reiner Indexer | Vollintegriert |  |  |  | TMC5240 | 4.77886 | powerstep01 | 8.713441412 | TMC2260 | 4.72886 | DRV8424 | 2.44886 | TMC5160 | 4.77886 | TMC2226 | 4.77886 | DRV8462 | 4.85886 | TMC5240 | 4.77886
 |  |  |  |  |  |  |  |  |  |  |  | DRV8462 |  |  |  |  |  | TMC2209 |  | 2 Alternativen
2 | Irms | 1.5A - 2A | 2A - 2.5A | > 2.5A |  |  |  | 24V |  | 48V |  | 24V |  | 24V |  | 48V |  | 24V |  | 24V
 |  |  |  |  |  |  |  |  |  |  |  |  |  |  |  |  |  |  |  | 24 begrenz durch IOe2
3 | Uout | 24V | 48V |  |  |  |  | 2.1A |  | 10A |  | 2.8A |  | 1.8 |  | abh. V. Endstufe |  | 2A |  | 3.5A |  | 2.1A
 |  |  |  |  |  |  |  |  |  |  |  |  |  |  |  |  |  |  |  | 2.1 & 7A alternativen |  | 2.1 & 7A alternativen
4 | Endstufe | integriert im Treiber | eigenbau |  |  |  |  | integriert im Treiber |  | integriert im Treiber |  | integriert im Treiber |  | integriert im Treiber |  | eigenbau | 5.48384 | integriert im Treiber |  | integriert im Treiber |  | integriert im Treiber
 |  | 0 | 5.48384
5 | Anzahl Erweiterungen | 1 | 2 | mehr |  |  |  | mehr |  | 2 |  | mehr |  | 1 |  | mehr |  | 1 |  | 1 |  | mehr
6 | Schnittstelle zu IOe2 | Step/dir | SPI | UART | I2C |  |  | SPI |  | SPI, Step/dir |  | SPI |  | Step/Dir |  | /Step/Dir/SPI |  | Step/Dir |  | Step/Dir |  | SPI
7 | Adresskonfiguration I2C | Inkrementelle Leiter | mit Shiftregister |  |  |  |  | Inkrementelle Leiter |  | Inkrementelle Leiter |  | Inkrementelle Leiter |  | Inkrementelle Leiter |  | Inkrementelle Leiter |  | Inkrementelle Leiter |  | Inkrementelle Leiter |  | Inkrementelle Leiter
8 | SPI Board erweitern | Inkrementelle Leiter | Logisch verknüpfung | garnicht |  |  |  | Inkrementelle Leiter |  | Inkrementelle Leiter |  | Inkrementelle Leiter |  | garnicht |  | Inkrementelle Leiter |  | garnicht |  | garnicht |  | Inkrementelle Leiter
9 | Sensoren anschliessen | Stecker auf Board | an Ioe direkt | An MCU/Controller |  |  |  | integriert in Treiber | 2.432333867 | an Ioe direkt |  | Stecker auf Board | 2.432333867 | an Ioe |  | an Ioe |  | an Ioe direkt |  | an Ioe direkt |  | an Ioe direkt
 |  | 2.432333867 | 0 | 2.432333867
10 | Encoder auswerten | Stecker auf Board | eigener MCU | integriert in Treiber | an Ioe weiterleiten | garnicht |  | integriert in Treiber | 2.65205 | an Ioe weiterleiten | 0 | eigene MCU | 2.65205 | garnicht | 0 | integriert in Treiber | 2.65205 | an Ioe Weiterleiten | 0 | an Ioe Weiterleiten | 0 | an Ioe Weiterleiten | 0
 |  | 2.65205 |  | 0 |  | 0
11 | Ramp Generation | Ioe macht das | eigener MCU | integriert in Treiber |  |  |  | integriert in Treiber |  | Ioe macht das |  | eigene MCU |  | Ioe macht das |  | Ioe macht das |  | Ioe macht das |  | Ioe macht das |  | Ioe macht das
12 | Spannungsversorgung | extern | über IOe2 |  |  |  |  | extern | 9.92 | extern | 9.92 | extern | 9.92 | Über IOe2 | 4.1 | extern | 9.92 | über IOe2 | 4.1 | über IOe2 | 4.1 | über IOe2 | 4.1
 |  | 9.92 | 4.1
13 | Schrittsteuerung | von IOe2 | über MCU | über Controller |  |  |  | über Controller | 0 | vom IOe2 | 0 | MCU | 1.58661 | von IOe2 | 0 | von IOe2 | 0 | über IOe2 | 0 | über IOe2 | 0 | über IOe2 | 0
 |  | 0 | 1.58661
 |  |  |  |  |  |  |  |  |  |  |  | Entwicklungsaufw. |  | Entwicklungsaufw. |  | Entwicklungsaufw.
 |  |  |  |  |  |  |  |  |  |  |  | höher |  | höher |  | höher
 |  |  |  |  |  |  | Gehäuse |  | 3 |  | 3 |  | 3 |  | 3 |  | 3 |  | 3 |  | 3 |  | 3
 |  |  |  |  |  |  | 3
 |  |  |  |  |  |  | Rüstk. pauschal |  | 1 |  | 1 |  | 1 |  | 1 |  | 1 |  | 1 |  | 1 |  | 1
 |  |  |  |  |  |  | 1
 |  |  |  |  |  |  | HK vorkalkulation |  | 39.14930387 |  | 37.99950141 |  | 40.68591387 |  | 25.91492 |  | 42.20081 |  | 28.24492 |  | 28.32492 |  | 28.24492
 |  |  |  |  |  |  | Reserve-Faktor
 |  |  |  |  |  |  | 1.2 |  | 46.97916464 |  | 45.59940169 |  | 48.82309664 |  | 31.097904 |  | 50.640972 |  | 33.893904 |  | 33.989904 |  | 33.893904 |  | 48V | 24V
 |  |  |  |  |  |  |  |  |  |  |  |  |  |  |  |  |  |  |  |  |  |  |  | Treiber mit eigenbau Endstufe: | 9 | 9
 |  |  |  |  |  |  |  |  |  |  |  |  |  |  |  |  |  |  |  |  |  |  |  | reiner indexer + Tteiber | 3.67 | 3.3
 |  |  |  |  |  | Pflichtenheft Erfüllung |  |  |  |  |  |  |  |  |  |  |  |  |  |  |  |  |  | integrierter treiber | 7.48 | 3.6
 |  |  |  |  |  | B | 1
 |  |  |  |  |  | B | 2
 |  |  |  |  |  | B | 3
 |  |  |  |  |  | B | 4
 |  |  |  |  |  | B | 5
 |  |  |  |  |  | B | 6
 |  |  |  |  |  | B | 7
 |  |  |  |  |  | B | 8
 |  |  |  |  |  | B | 9
 |  |  |  |  |  | B | 10
 |  |  |  |  |  | B | 11
 |  |  |  |  |  | B | 12
 |  |  |  |  |  | B | 13
 |  |  |  |  |  | X1 | 14
 |  |  |  |  |  | X1 | 15
 |  |  |  |  |  | X2 | 16
 |  |  |  |  |  | X2 | 17
 |  |  |  |  |  | X2 | 18
 |  |  |  |  |  | X2 | 19 |  |  |  |  |  |  | je nach Treiber | je nach Treiber
 |  |  |  |  |  | X3 | 20
 |  |  |  |  |  | X3 | 21
 |  |  |  |  |  | X3 | 22 |  |  |  |  | ADI-nein TI-ja | ADI-nein TI-ja
 |  |  |  |  |  | NWA
 |  |  |  |  |  | Pflichtenheft | Gewichtung | Bewertung [%] | Teilnutzwert | Bewertung [%] | Teilnutzwert | Bewertung [%] | Teilnutzwert | Bewertung [%] | Teilnutzwert | Bewertung [%] | Teilnutzwert | Bewertung [%] | Teilnutzwert | Bewertung [%] | Teilnutzwert | Bewertung [%] | Teilnutzwert
 |  |  |  |  |  | 1 | 4 | 100 | 400 | 100 | 400 | 100 | 400 | 100 | 400 | 100 | 400 | 100 | 400 | 100 | 400 | 100 | 400
 |  |  |  |  |  | 2 | 4 | 100 | 400 | 100 | 400 | 100 | 400 | 100 | 400 | 100 | 400 | 100 | 400 | 100 | 400 | 100 | 400
 |  |  |  |  |  | 3 | 4 | 100 | 400 | 100 | 400 | 100 | 400 | 100 | 400 | 100 | 400 | 100 | 400 | 100 | 400 | 100 | 400
 |  |  |  |  |  | 4 | 4 | 100 | 400 | 100 | 400 | 100 | 400 | 100 | 400 | 100 | 400 | 100 | 400 | 100 | 400 | 100 | 400
 |  |  |  |  |  | 5 | 4 | 100 | 400 | 100 | 400 | 100 | 400 | 100 | 400 | 100 | 400 | 100 | 400 | 100 | 400 | 100 | 400
 |  |  |  |  |  | 6 | 4 | 100 | 400 | 100 | 400 | 100 | 400 | 100 | 400 | 100 | 400 | 100 | 400 | 100 | 400 | 100 | 400
 |  |  |  |  |  | 7 | 4 | 100 | 400 | 100 | 400 | 100 | 400 | 100 | 400 | 100 | 400 | 100 | 400 | 100 | 400 | 100 | 400
 |  |  |  |  |  | 8 | 4 | 100 | 400 | 100 | 400 | 50 | 200 | 80 | 320 | 100 | 400 | 100 | 400 | 100 | 400 | 100 | 400
 |  |  |  |  |  | 9 | 4 | 100 | 400 | 100 | 400 | 100 | 400 | 100 | 400 | 100 | 400 | 100 | 400 | 100 | 400 | 100 | 400
 |  |  |  |  |  | 10 | 4 | 100 | 400 | 100 | 400 | 100 | 400 | 100 | 400 | 100 | 400 | 100 | 400 | 100 | 400 | 100 | 400
 |  |  |  |  |  | 11 | 4 |  | 0 |  | 0 |  | 0 |  | 0 |  | 0 |  | 0 |  | 0 |  | 0
 |  |  |  |  |  | 12 | 5 | 50 | 250 | 80 | 320 | 80 | 400 | 100 | 500 | 50 | 250 | 100 | 500 | 100 | 500 | 100 | 500
 |  |  |  |  |  | 13 | 4 | 100 | 400 | 100 | 400 | 100 | 400 | 100 | 400 | 100 | 400 | 100 | 400 | 100 | 400 | 100 | 400
 |  |  |  |  |  | 14 | 4 | 0 | 0 | 0 | 0 | 0 | 0 | 100 | 400 | 0 | 0 | 100 | 400 | 100 | 400 | 20 | 80
 |  |  |  |  |  | 15 | 3 | 100 | 300 | 100 | 200 | 100 | 300 | 0 | 0 | 100 | 300 | 100 | 300 | 100 | 300 | 100 | 300
 |  |  |  |  |  | 16 | 2 | 100 | 200 | 100 | 200 | 100 | 200 | 0 | 0 | 100 | 200 | 100 | 200 | 100 | 200 | 100 | 200
 |  |  |  |  |  | 17 | 2 | 100 | 200 | 100 | 200 | 100 | 200 | 100 | 200 | 100 | 200 | 100 | 200 | 100 | 200 | 100 | 200
 |  |  |  |  |  | 18 | 2 | 100 | 200 | 100 | 200 | 0 | 0 | 0 | 0 | 100 | 200 | 0 | 0 | 100 | 200 | 100 | 200
 |  |  |  |  |  | 19 | 2 | 50 | 100 | 100 | 100 | 75 | 150 | 20 | 40 | 100 | 200 | 50 | 100 | 100 | 200 | 50 | 100
 |  |  |  |  |  | 20 | 1 | 100 | 100 | 100 | 100 | 100 | 100 | 0 | 0 | 100 | 100 | 100 | 100 | 100 | 100 | 100 | 100
 |  |  |  |  |  | 21 | 1 |  | 0 |  | 0 |  | 0 |  | 0 |  | 0 |  | 0 |  | 0 |  | 0
 |  |  |  |  |  | 22 | 1 | 0 | 0 | 100 | 0 | 0 | 0 | 100 | 100 | 100 | 100 | 0 | 0 | 0 | 0 | 0 | 0
 |  |  |  |  |  | Gesamtnutzwert |  |  | 5750 |  | 5720 |  | 5550 |  | 5560 |  | 5950 |  | 6200 |  | 6500 |  | 6080
 |  |  |  |  |  | Ranking |  |  | 5 |  | 6 |  | 8 |  | 7 |  | 4 |  | 2 |  | 1 |  | 3
 |  |  |  |  |  |  |  | Kostentechnisch knapp |  | Kostentechnisch knapp |  | zu teuer! |  |  |  | zu teuer!

Sheet: Kostenanalyse_SMSe
Erfahrungs-/Durchschnittswerte SMSe
Position: | R | C | L | D | Q (fets) | Schm.Trig. | Best. SMD | Best. THT | Leiterplatte
ges.Kosten | 0.9757 | 1.33037 | 1.6765 | 2.4841 | 12.10942 | 0.11
ges.Anzahl | 256 | 129 | 10 | 75 | 32 | 1 |  |  | maximal
Preis/Stück | 0.003811328125 | 0.01031294574 | 0.16765 | 0.03312133333 | 0.378419375 | 0.11 | 0.04 | 0.02 | 6
Rüstkosten |  | 9 pro Komponente @ 500stk
 |  | 1.48 pro SMSe bei 82 Komponenten |  |  |  | : 1CHF annahme
ICT ?
