JulesBischof/Praxismodul/(list of files, cad)

Other CAD files:
06_Referenzen/SGuard/3D/D00173334_IP3734_pcb.DWG
