JulesBischof/Praxismodul/06_Referenzen/TMC5240-EVAL/V10/FABRICATION/TMC5240-EVAL_V10 - Info.txt

Date:				2022-01-10
Name:				TMC5240-EVAL_V10
Layers:				4
PCB Width:			55mm
PCB Height:			85mm
PCB Thickness:			1.6mm

Outer Layer Copper:		35µm (end)
Inner Layer Copper:		35µm

Silk Screen Top:		required (black)
Silk Screen Bottom:		required (black)
Solder Mask Top:		white
Solder Mask Bottom:		white
UL logo:			required (not for protos / pool services)
