JulesBischof/Praxismodul/(threads)

Thread 20 (2024-03-07):

Chip-Suchstrategie aufstellen

JulesBischof, 2024-03-07:

JulesBischof, 2024-03-25:
Allgemeinen Überblick über Hersteller verschafft, Kenngrössen herausgesucht - paralellen zwischen MArkenbezeichnungen finden (z.B. Stallguard bei STM/TI)

Haben alle sehr ähnliche Bezeichnungen.

Gesucht werden sollte in den Kategorien:
-> Vollintegrierter Treiber mit Kommunikationsschnittstelle, Indexer und Endstufe.

Closed 2024-03-25.

Thread 5 (2024-03-07):

Schnittstellen final abklären

JulesBischof, 2024-03-07:

JulesBischof, 2024-03-25:
Es steht noch nicht zu 100% fest welche Ausgänge alle auf der IOe2 Schnittstelle vorhanden sein werden

JulesBischof, 2024-04-15:
5.4V bekomme ich über SChnittstelle, Ansonten genug pins für 24V Speisung vorhanden

Closed 2024-04-15.

Thread 42 (2024-03-08):

Cyclic Sync Position Mode via Trajectory Generator?

JulesBischof, 2024-03-08:

JulesBischof, 2024-03-25:
Aktuell ist die Ansteuerung der Motoren auf der Maschine so gelöst, dass der RT-Controller dem Print in sehr kleinen Inkrementen eine neue soll-position vorgiebt, die der Motorentreiber dann anfahren muss. So steuert indirekt der RT-Controller also das steuern der Motoren

JulesBischof, 2024-03-25:
Positionsüberwachung heisst: IOe2 bekommt Rückmeldung darüber an welchemOrt der Motor aktuell steht. Regelung hingegen würde bedeuten, dass aktiv nach dem Encodersignal die Position eingeregelt wird.

Closed 2024-03-25.

Thread 46 (2024-03-08):

Stall Guard - was ist das? (Openloop überwachung, pkt 18)

JulesBischof, 2024-03-08:

Closed 2024-03-11.

Thread 47 (2024-03-08):

Initialisierung über Stallguard

JulesBischof, 2024-03-08:

JulesBischof, 2024-03-25:
Stallguard bedeutet die "Back-EMF" des Motors zu überwachen und darüber Rückschlüsse über den momentanen Lastzustand sowie eventuelle Schrittverluste zu erkennen.

Closed 2024-03-25.

Thread 49 (2024-03-11):

MotionControl

JulesBischof, 2024-03-11:
https://www.analog.com/en/lp/001/motion-control-technology.html

lesen und verstehen

JulesBischof, 2024-03-11:
es gibt Stromgesteuerte und Spannungsgesteuerte Chopper mit ihren jeweiligen vor und Nachteilen.

Spannungsgesteuerte Chopper haben eine höhere Laufruhe, verlieren allerdings früher an Drehmoment. Stromgesteuerte Chopper hingegen sind unruhiger - liefern dagegen ein besseres Drehmoment. Trinamic bietet eine Kombination von beiden für verschiedene Drehzahlbereiche.

Closed 2024-03-11.

Thread 50 (2024-03-11):

Parameterization of StallGuard2™ & CoolStep™

JulesBischof, 2024-03-11:
