JulesBischof/Praxismodul/06_Referenzen/TMC5240-EVAL/V10/PDF/TMC5240-EVAL_V10 - Schematic Drawing.pdf

## Revision History

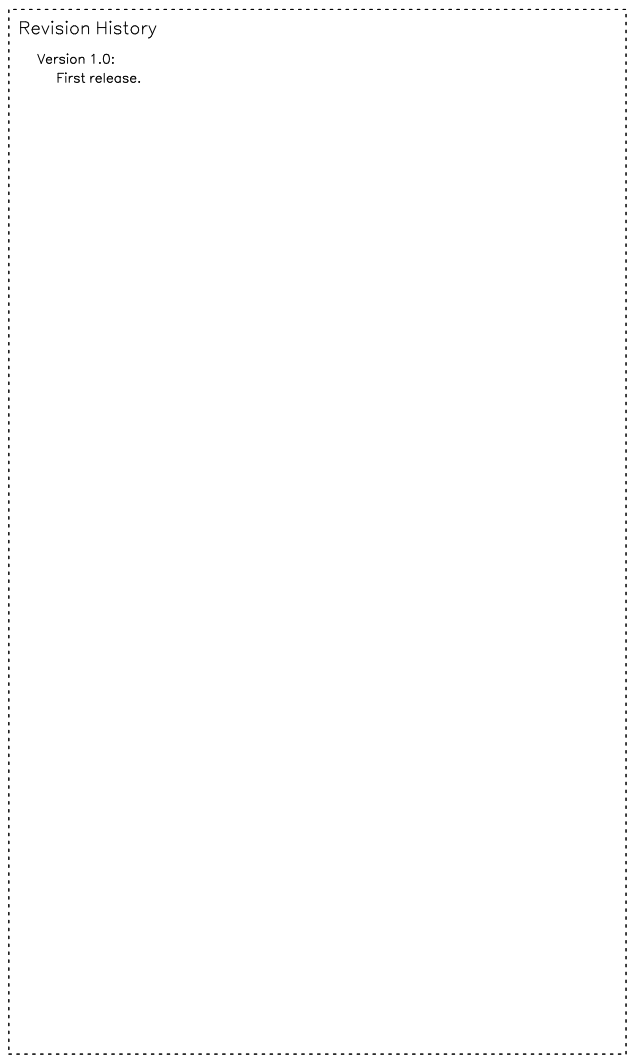
[picture p34: page 1]
OPEN; SOURCE; Designed by:; Approved by:; Release date:; Schematic title:; Sheet title:; Revision:; Sheet:; REVISION; HISTORY; TMC5240-EVAL; Version 1.0:; First release.

## Interface Connector

## Supply Connector

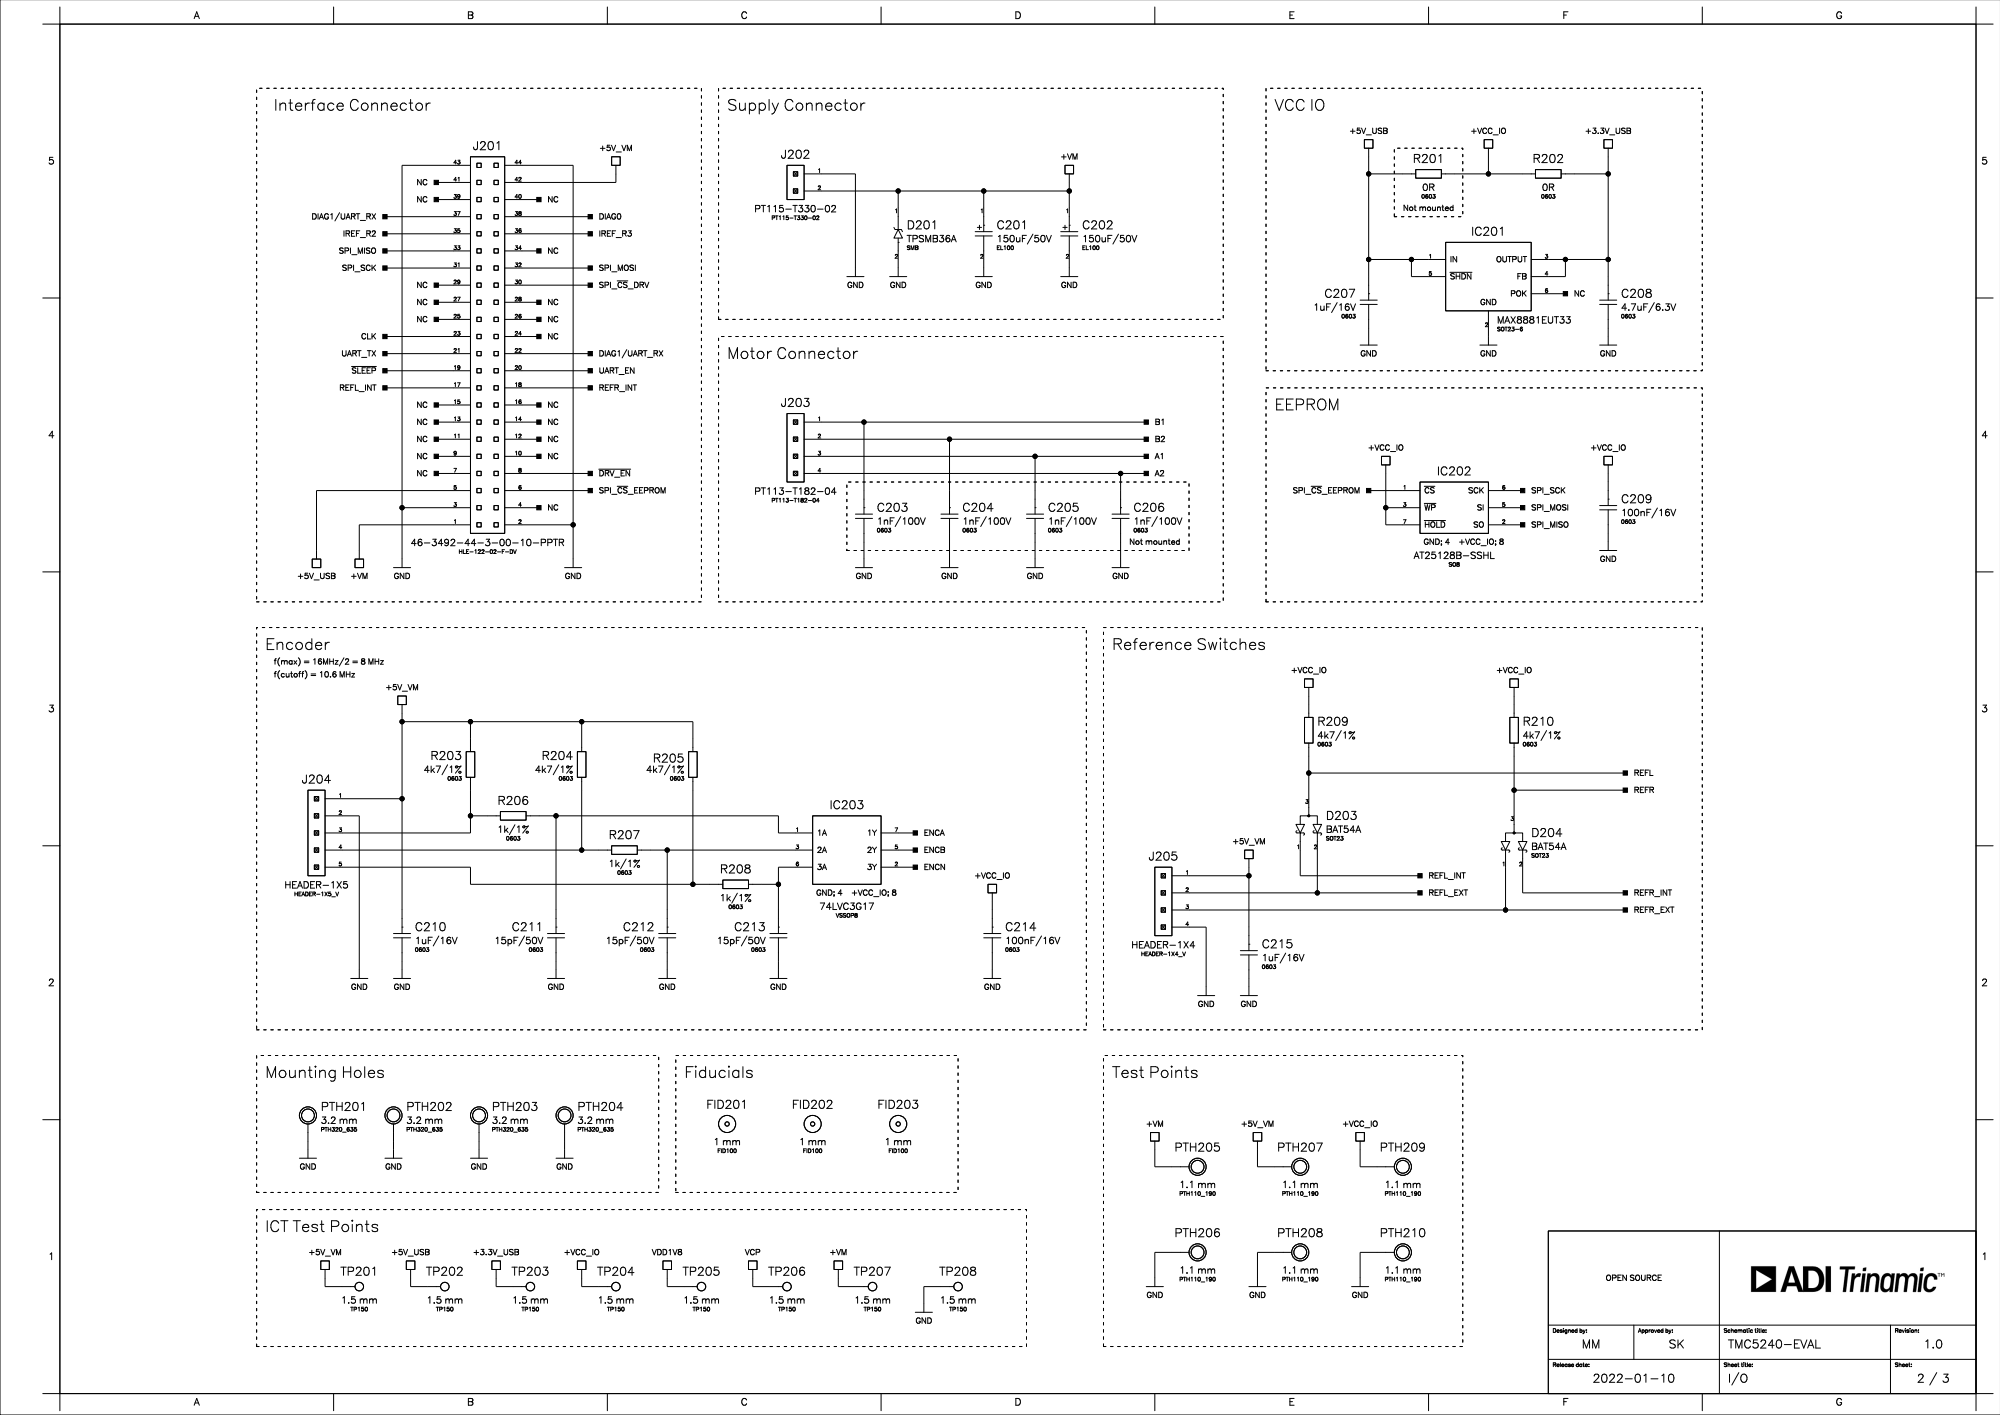
[picture p35: page 2]

## Motor Driver

C305

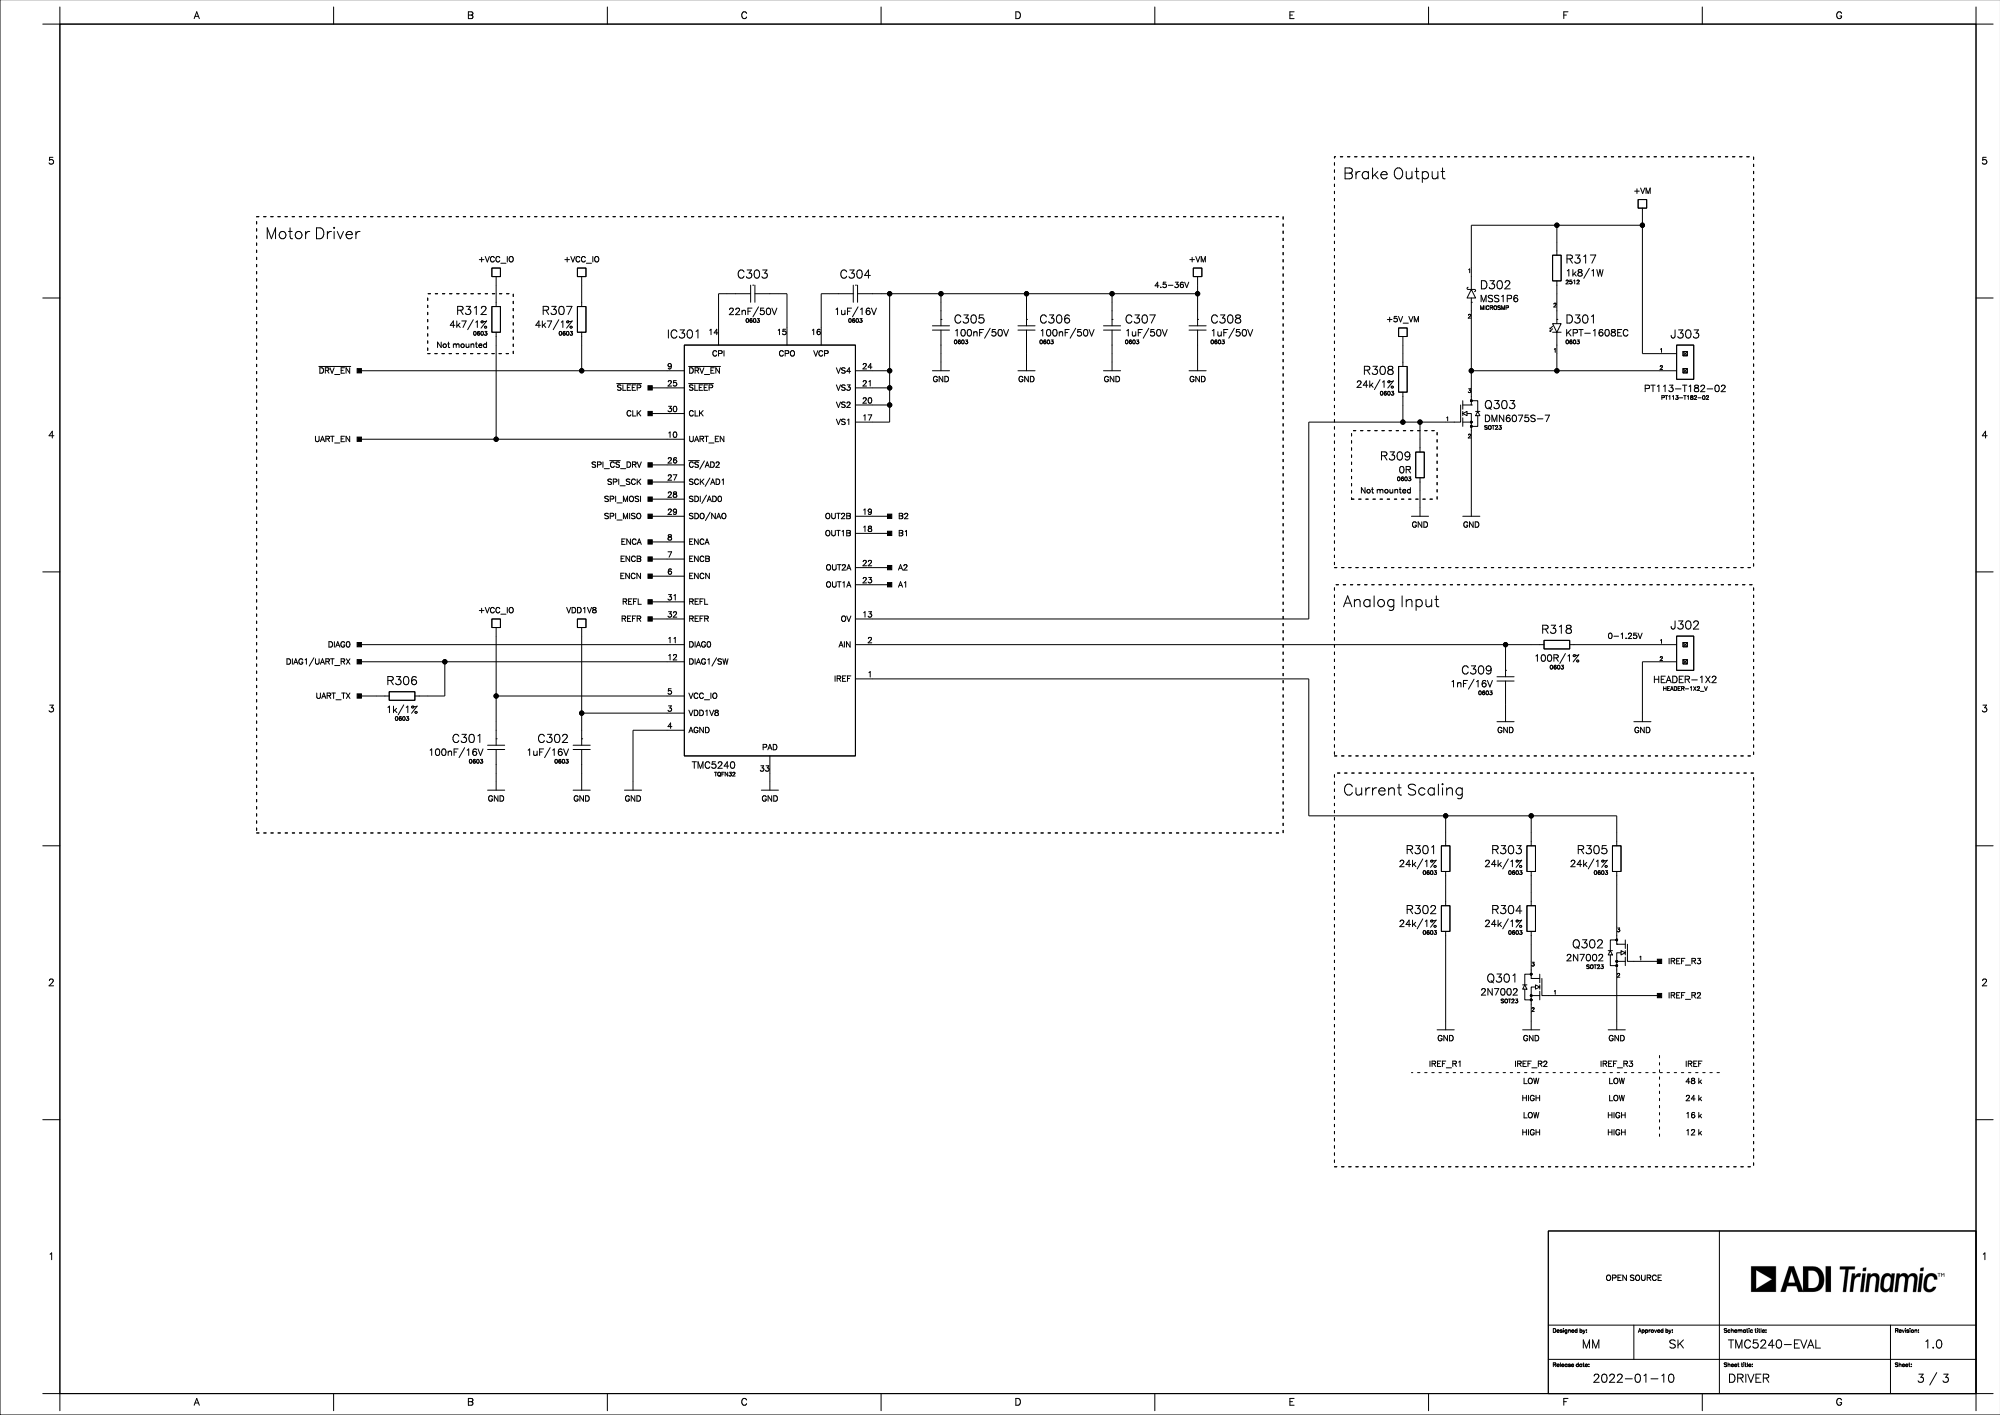
[picture p36: page 3]
