JulesBischof/Praxismodul/04_Konzepte/02_Layout.pdf

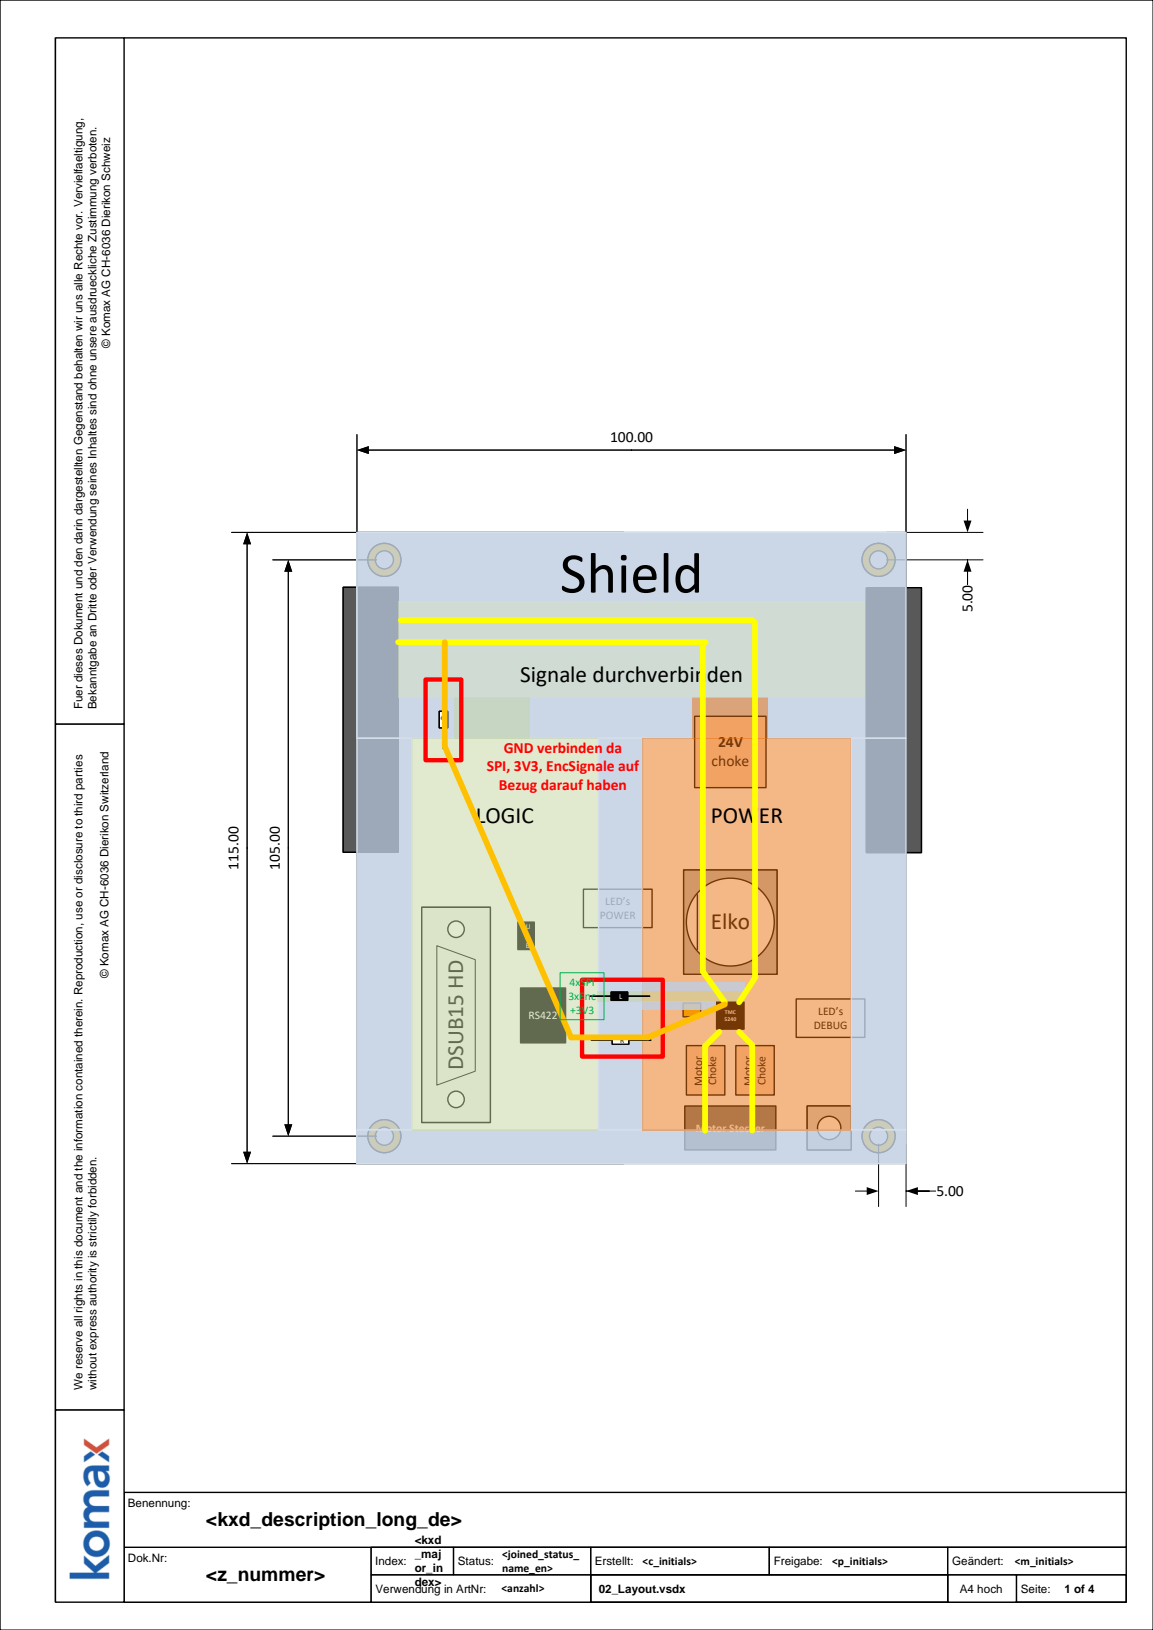
[picture p37: page 1]
Dok.Nr:; Benennung:; Verwendung in ArtNr:; A4 hoch; Seite:; Index:; Status:; Erstellt:; Freigabe:; Geändert:; 02_Layout.vsdx; <kxd_description_long_de>; <z_nummer>; <kxd _maj or_in dex>; <joined_status_ name_en>; <anzahl>; <c_initials>; <p_initials>; <m_initials>; Shield; 24V choke; TMC 5240; Elko S; Motor; Choke; DSUB15 HD; Motor Stecker; LED’s POWER; LED’s DEBUG; LOGIC; POWER; Signale durchverbinden; 4xSPI 3xEnc +3V3

Fuer dieses Dokument und den darin dargestellten Gegenstand behalten wir uns alle Rechte vor. Vervielfaeltigung,

Bekanntgabe an Dritte oder Verwendung seines Inhaltes sind ohne unsere ausdrueckliche Zustimmung verboten.

© Komax AG CH-6036 Dierikon Schweiz

GND verbinden da
SPI, 3V3, EncSignale auf
Bezug darauf haben

We reserve all rights in this document and the information contained therein. Reproduction, use or disclosure to third parties

© Komax AG CH-6036 Dierikon Switzerland

without express authority is strictily forbidden.

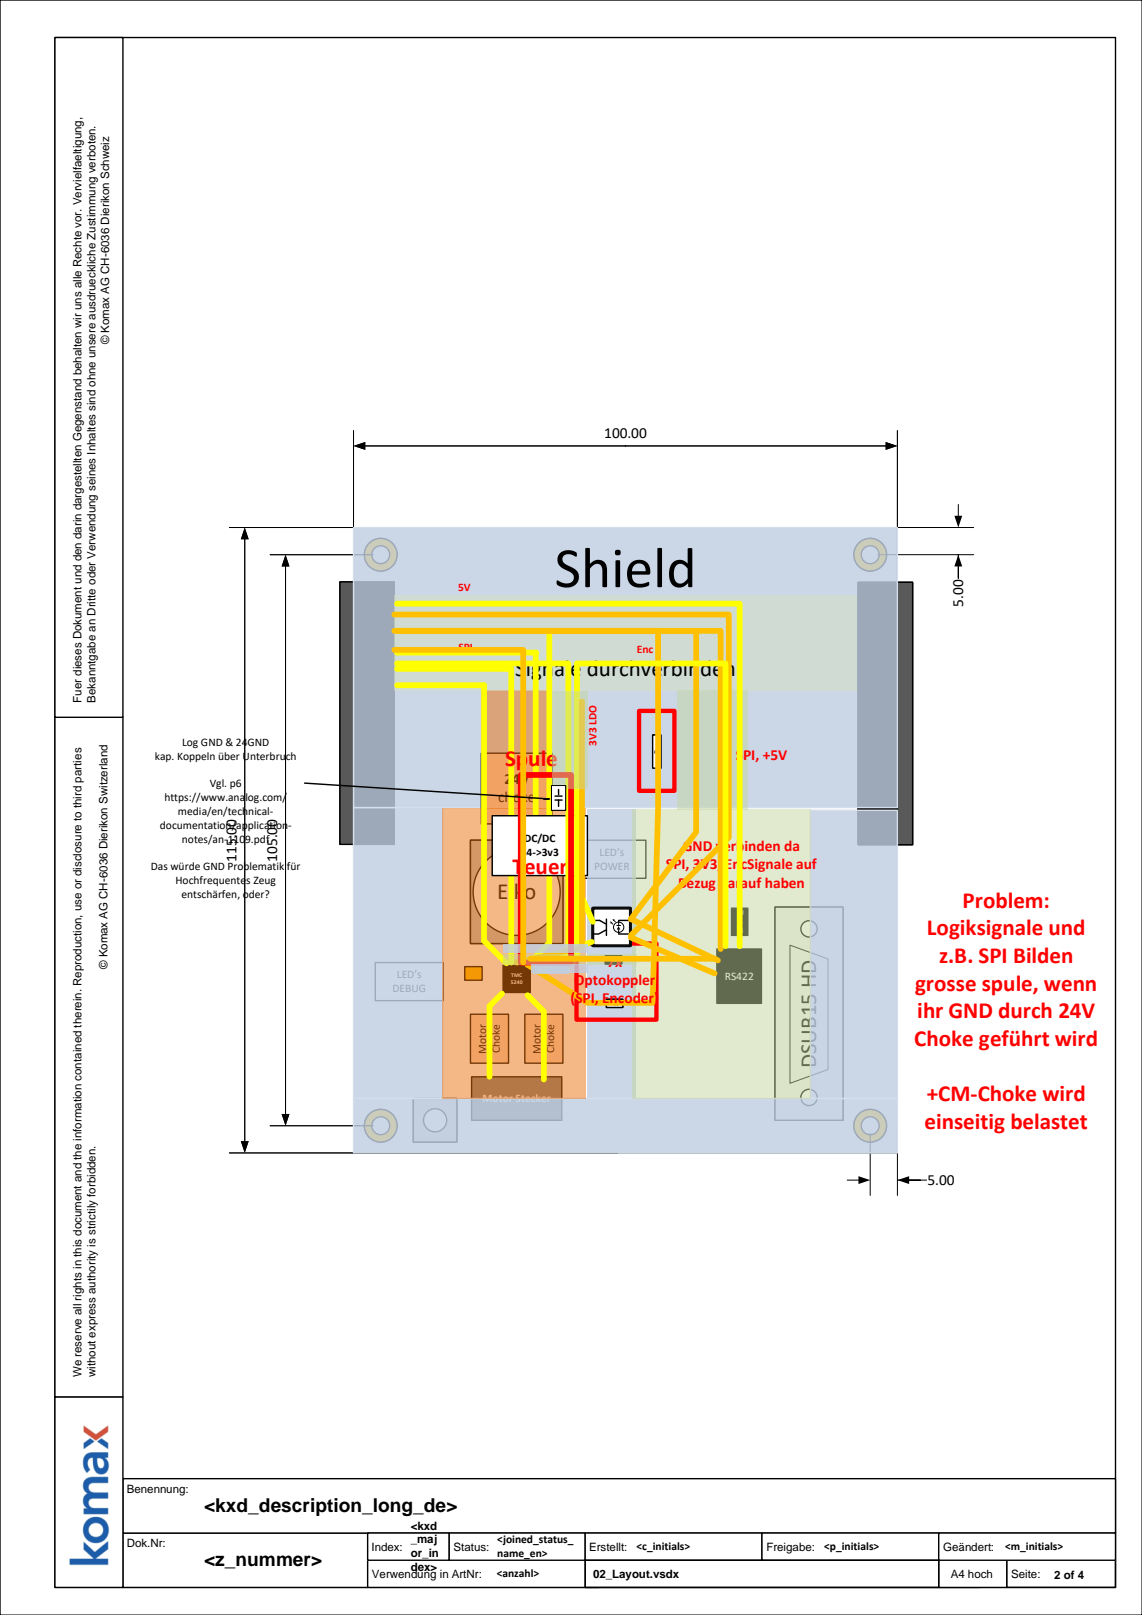
[picture p38: page 2]
Shield; 24V choke; TMC 5240; Elko; Motor; Choke; DSUB15 HD; Motor Stecker; LED’s POWER; LED’s DEBUG; Signale durchverbinden; 7x Optokoppler (SPI, Encoder); SPI, +5V; Teuer!; SPI; Enc 3V³ LDO; Spule; Vgl. p6

Fuer dieses Dokument und den darin dargestellten Gegenstand behalten wir uns alle Rechte vor. Vervielfaeltigung,

Bekanntgabe an Dritte oder Verwendung seines Inhaltes sind ohne unsere ausdrueckliche Zustimmung verboten.

© Komax AG CH-6036 Dierikon Schweiz

Log GND & 24GND
kap. Koppeln über Unterbruch

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

© Komax AG CH-6036 Dierikon Switzerland

https://www.analog.com/
media/en/technical-
documentation/application-
notes/an-1109.pdf

GND verbinden da
SPI, 3V3, EncSignale auf
Bezug darauf haben

Das würde GND Problematik für
Hochfrequentes Zeug
entschärfen, oder?

Problem:
Logiksignale und
z.B. SPI Bilden
grosse spule, wenn
ihr GND durch 24V
Choke geführt wird

+CM-Choke wird
einseitig belastet

without express authority is strictily forbidden.

# 5V & 24V GND unter Treiber zusammenführen

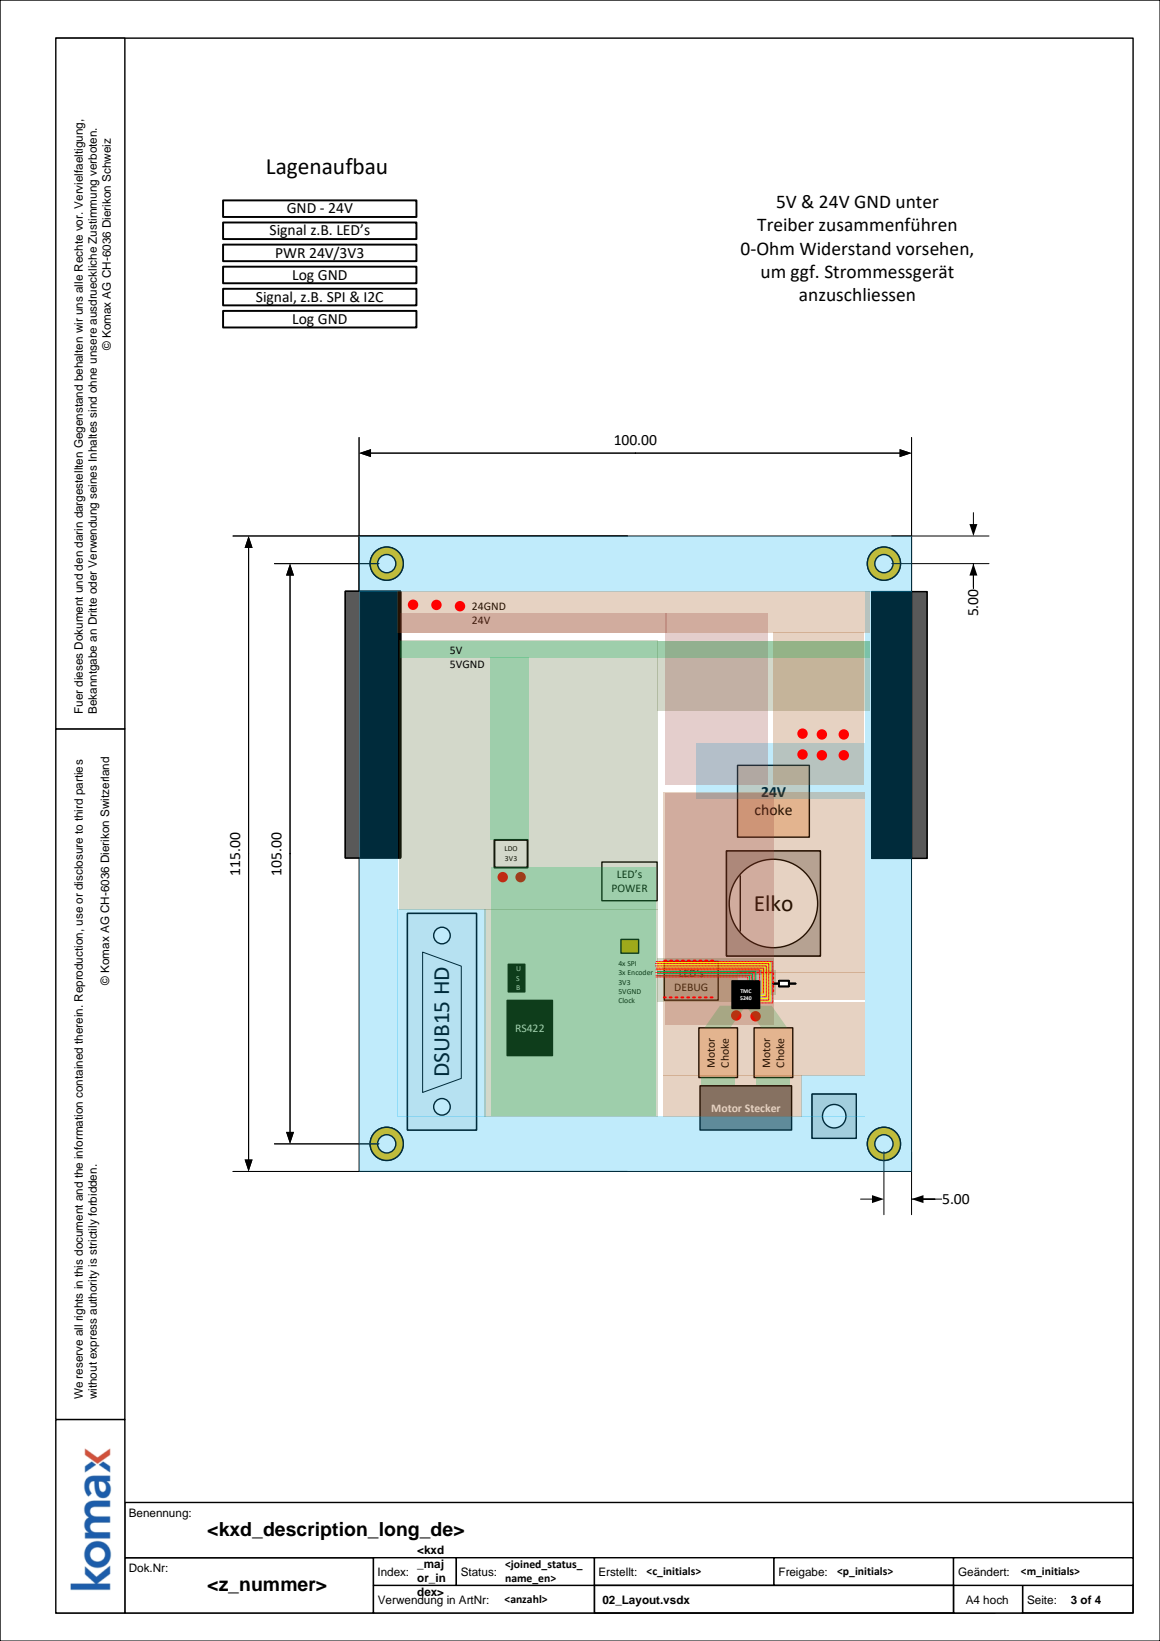
[picture p39: page 3]
DSUB15 HD; LED’s POWER; 24GND 24V; LDO 3V3; 4x SPI 3x Encoder 3V3 5VGND Clock; 24V choke; Elko; Motor; Choke; Motor Stecker; LED’s DEBUG; GND - 24V Signal z.B. LED’s PWR 24V/3V3 Log GND Signal, z.B. SPI & I2C Log GND; 5V 5VGND; TMC 5240; Lagenaufbau

Fuer dieses Dokument und den darin dargestellten Gegenstand behalten wir uns alle Rechte vor. Vervielfaeltigung,

Bekanntgabe an Dritte oder Verwendung seines Inhaltes sind ohne unsere ausdrueckliche Zustimmung verboten.

© Komax AG CH-6036 Dierikon Schweiz

0-Ohm Widerstand vorsehen,
um ggf. Strommessgerät
anzuschliessen

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

© Komax AG CH-6036 Dierikon Switzerland

without express authority is strictily forbidden.

# 5V & 24V GND unter Treiber zusammenführen

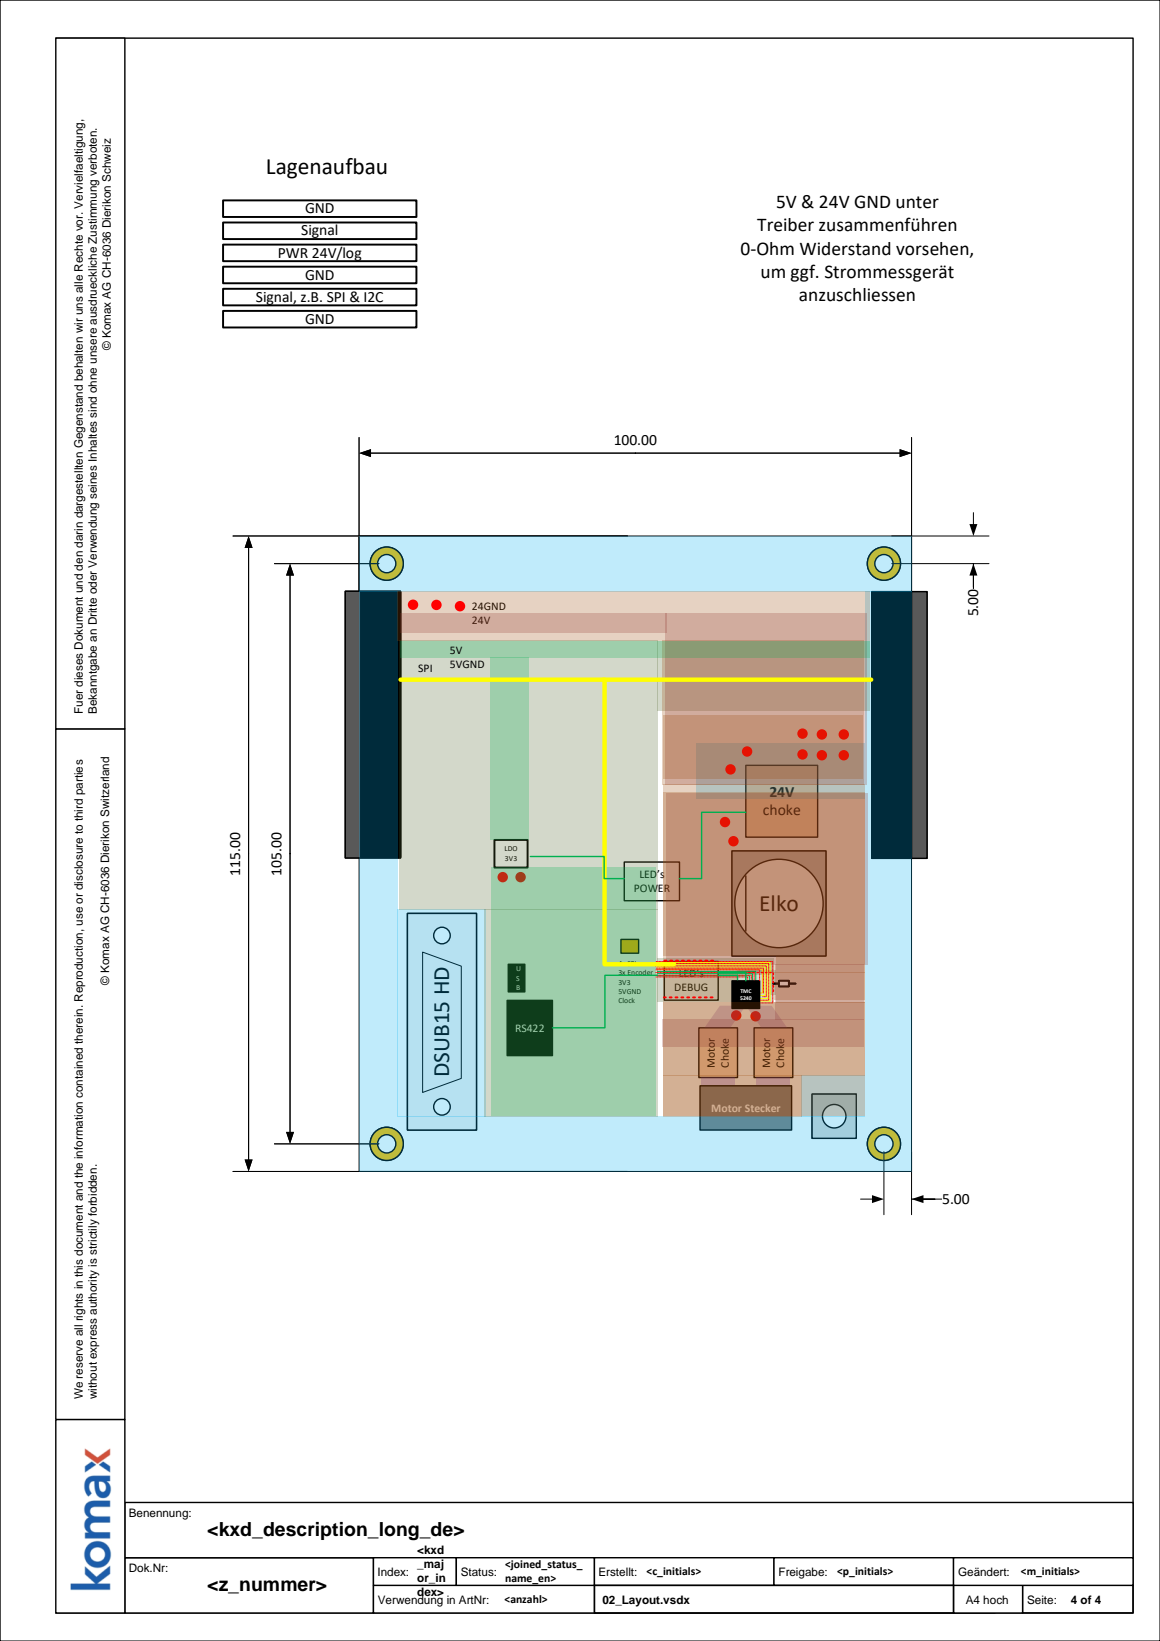
[picture p40: page 4]
DSUB15 HD; LED’s POWER; 24GND 24V; LDO 3V3; 4x SPI 3x Encoder 3V3 5VGND Clock; 24V choke; Elko; Motor; Choke; Motor Stecker; LED’s DEBUG; GND Signal PWR 24V/log GND Signal, z.B. SPI & I2C GND; 5V 5VGND; TMC 5240; Lagenaufbau; SPI

Fuer dieses Dokument und den darin dargestellten Gegenstand behalten wir uns alle Rechte vor. Vervielfaeltigung,

Bekanntgabe an Dritte oder Verwendung seines Inhaltes sind ohne unsere ausdrueckliche Zustimmung verboten.

© Komax AG CH-6036 Dierikon Schweiz

0-Ohm Widerstand vorsehen,
um ggf. Strommessgerät
anzuschliessen

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

© Komax AG CH-6036 Dierikon Switzerland

without express authority is strictily forbidden.
