JulesBischof/Praxismodul/06_Referenzen/TMC5240-EVAL/V10/FABRICATION/TMC5240-EVAL_V10 - Component Placement Drawing.pdf

C201

J202

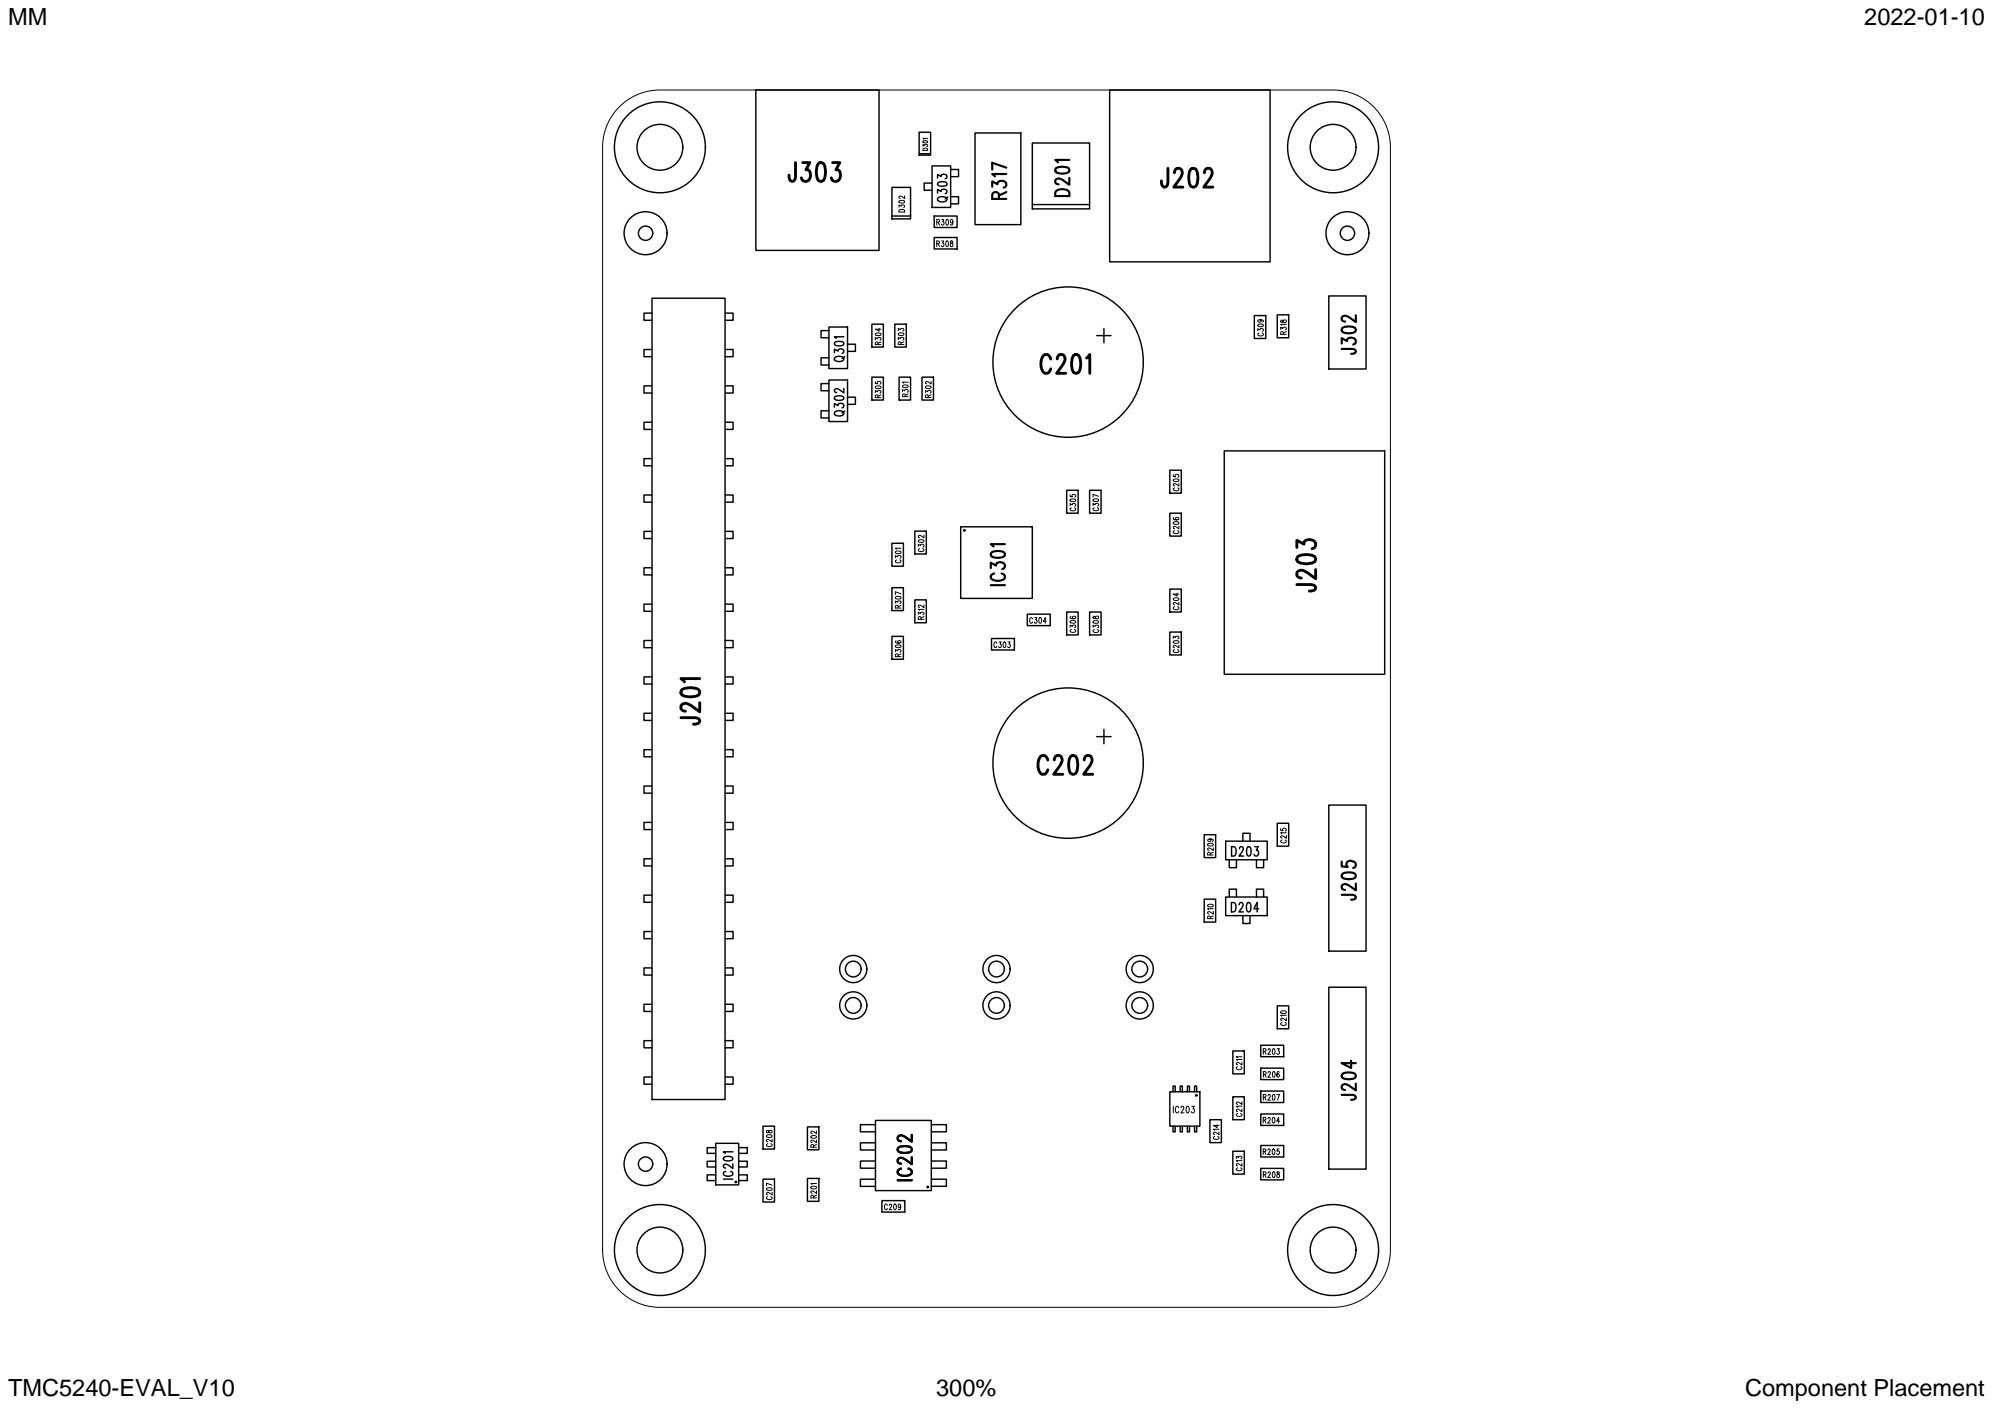
[picture p41: page 1]

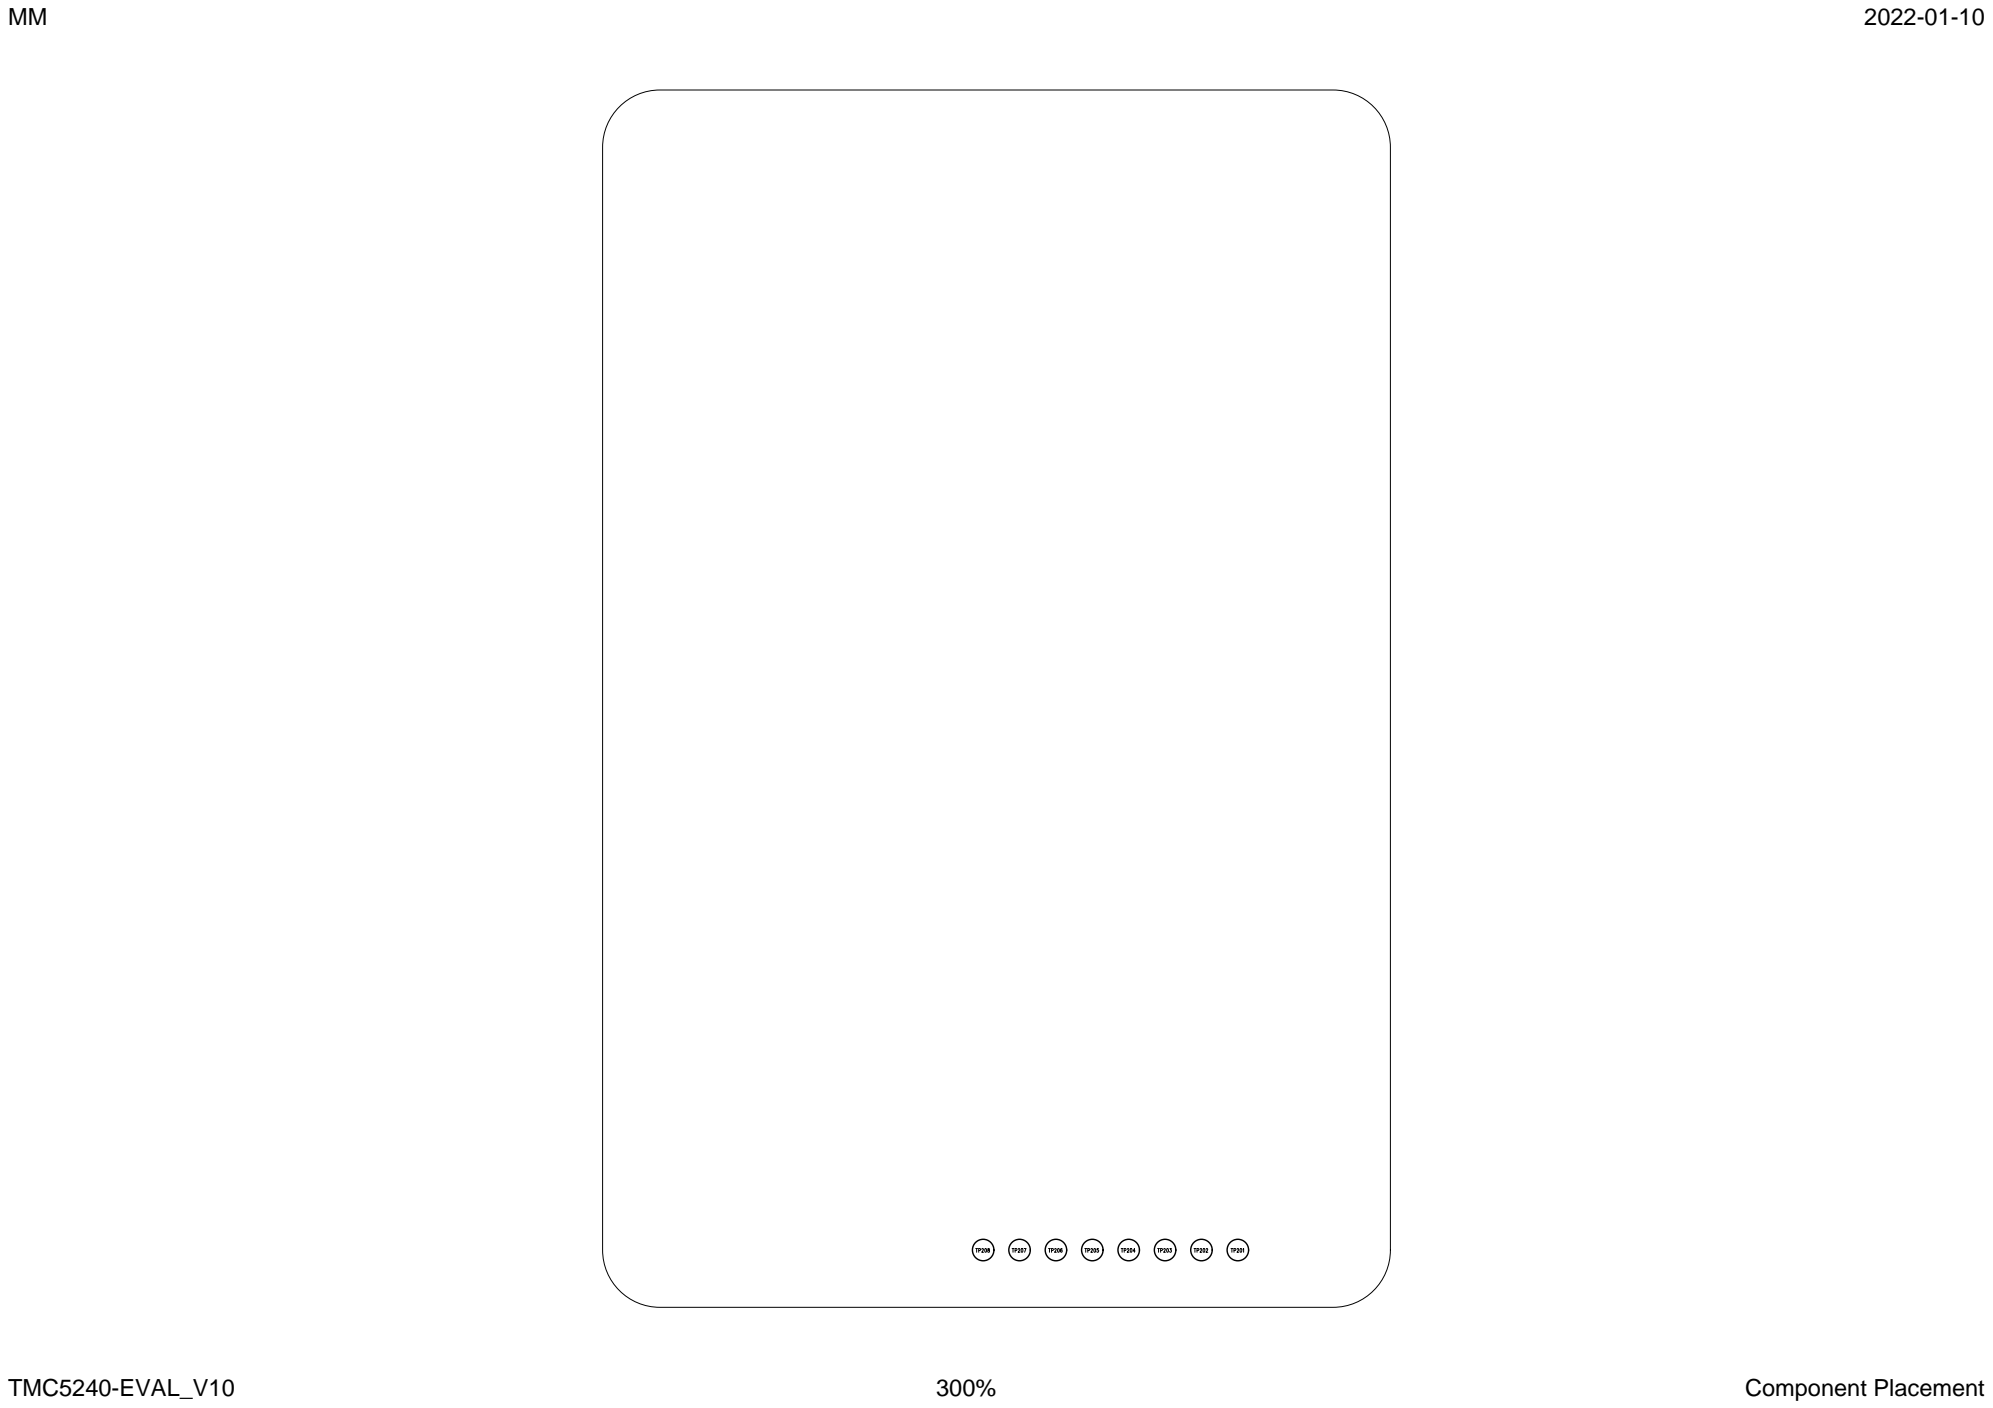
[picture p42: page 2]
