JulesBischof/Praxismodul/06_Referenzen/TMC5240-EVAL/V10/FABRICATION/TMC5240-EVAL_V10 - Drill Drawing.pdf

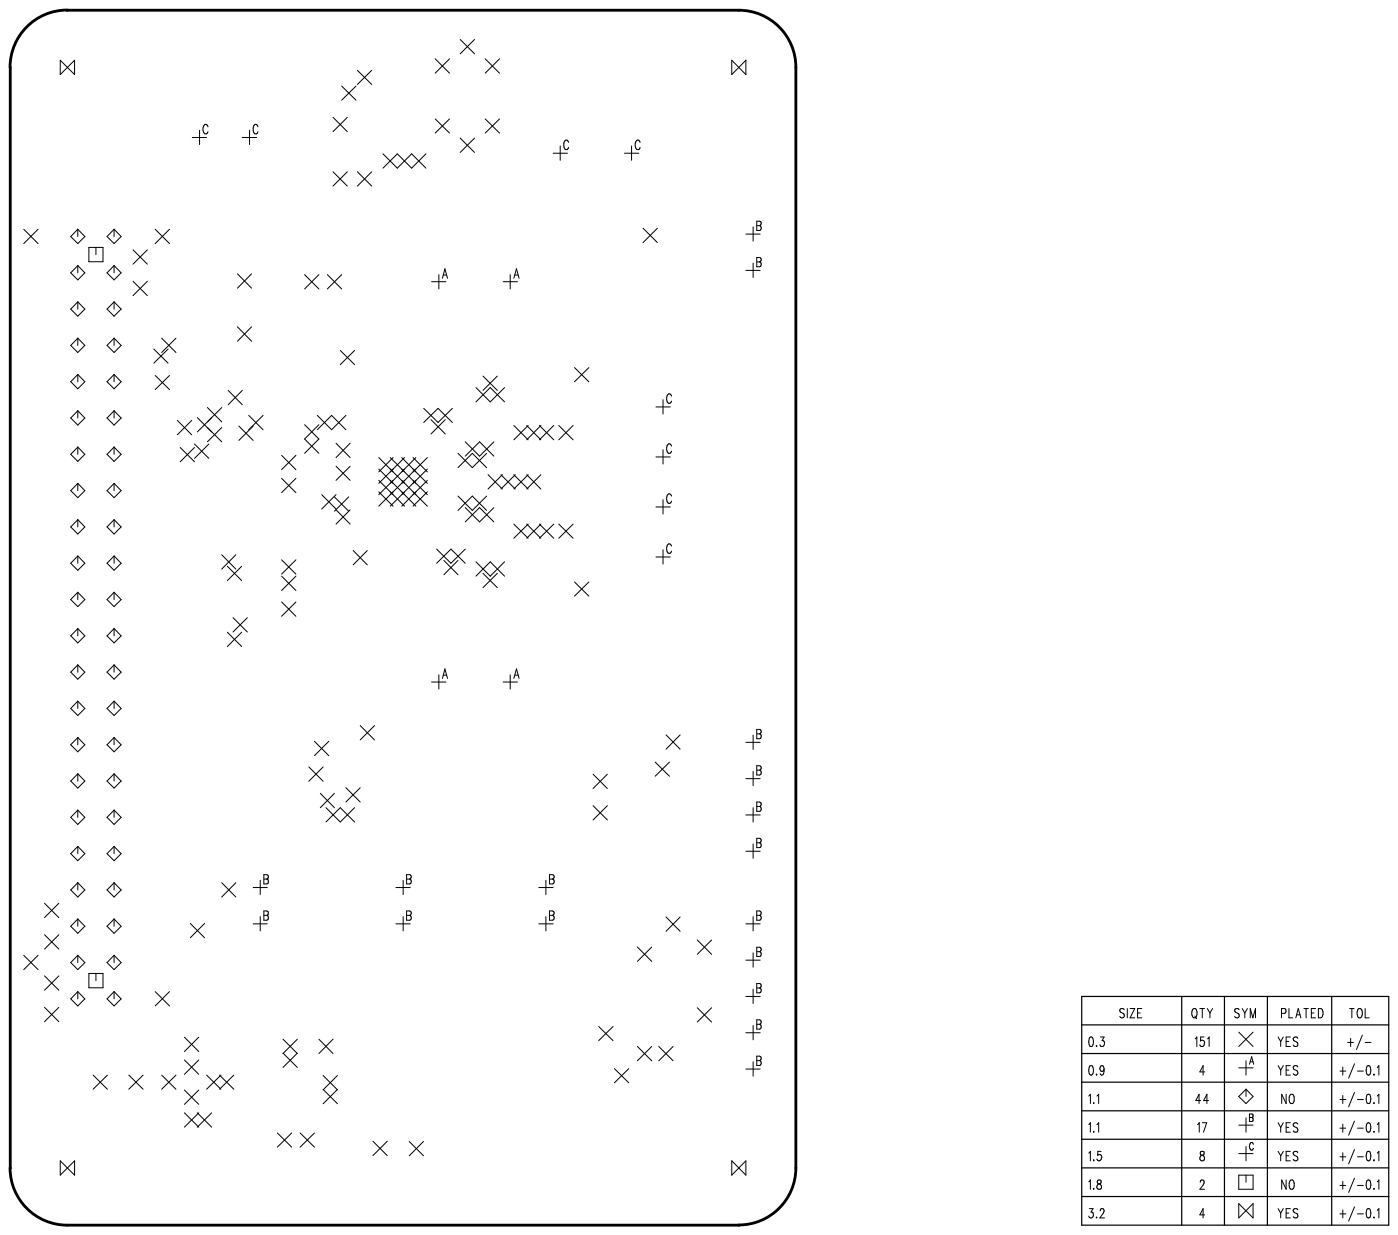
[picture p43: page 1]
