JulesBischof/Praxismodul/06_Referenzen/TMC5240-EVAL/V10/PDF/Other/TMC5240-EVAL_V10 - Bottom.pdf

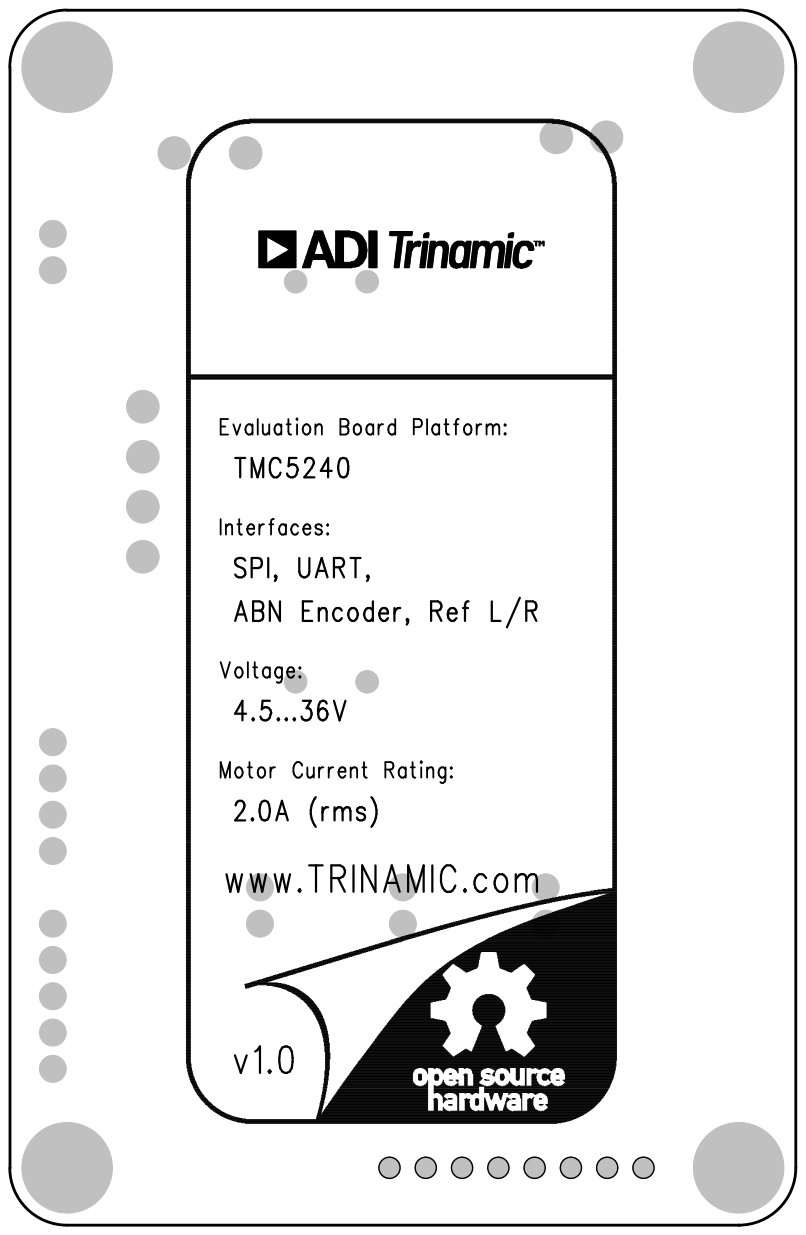
[picture p44: page 1]
