JulesBischof/Praxismodul/06_Referenzen/TMC5240-EVAL/V10/PDF/Other/TMC5240-EVAL_V10 - L1.pdf

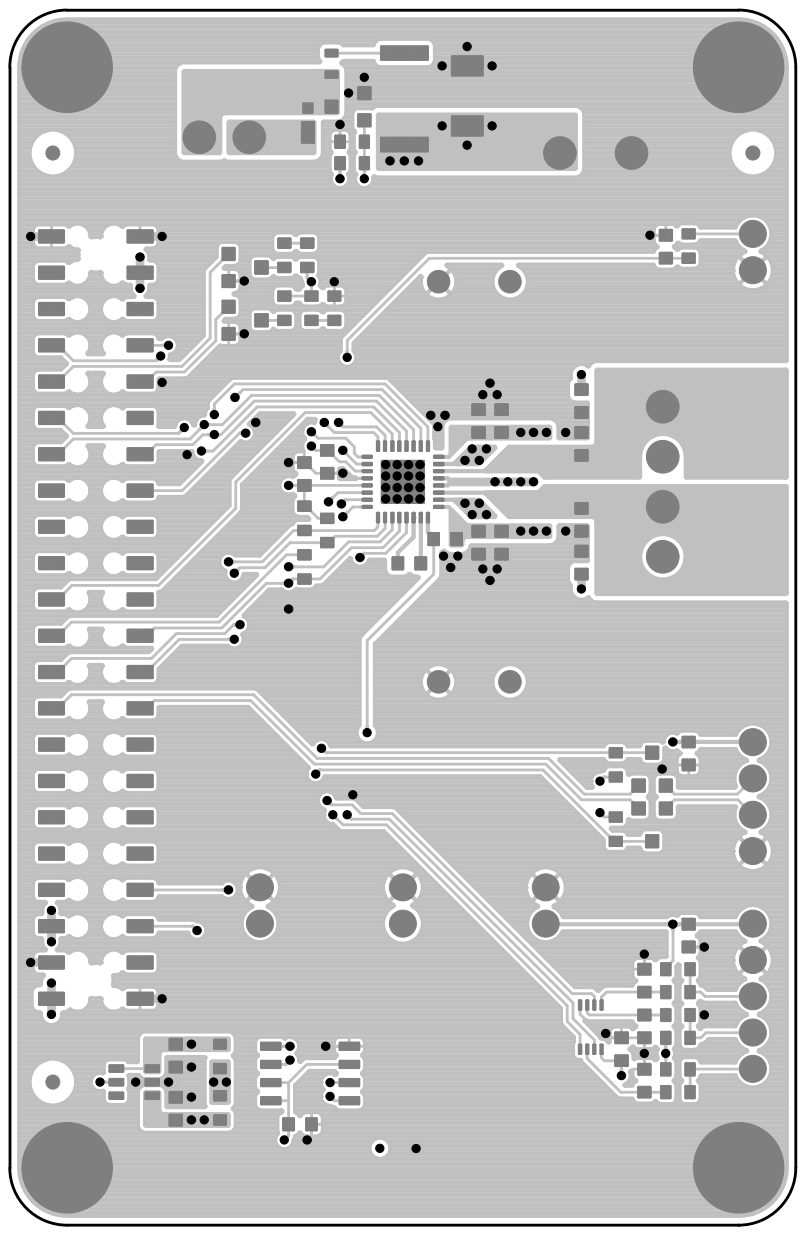
[picture p45: page 1]
