JulesBischof/Praxismodul/06_Referenzen/TMC5240-EVAL/V10/PDF/Other/TMC5240-EVAL_V10 - L2.pdf

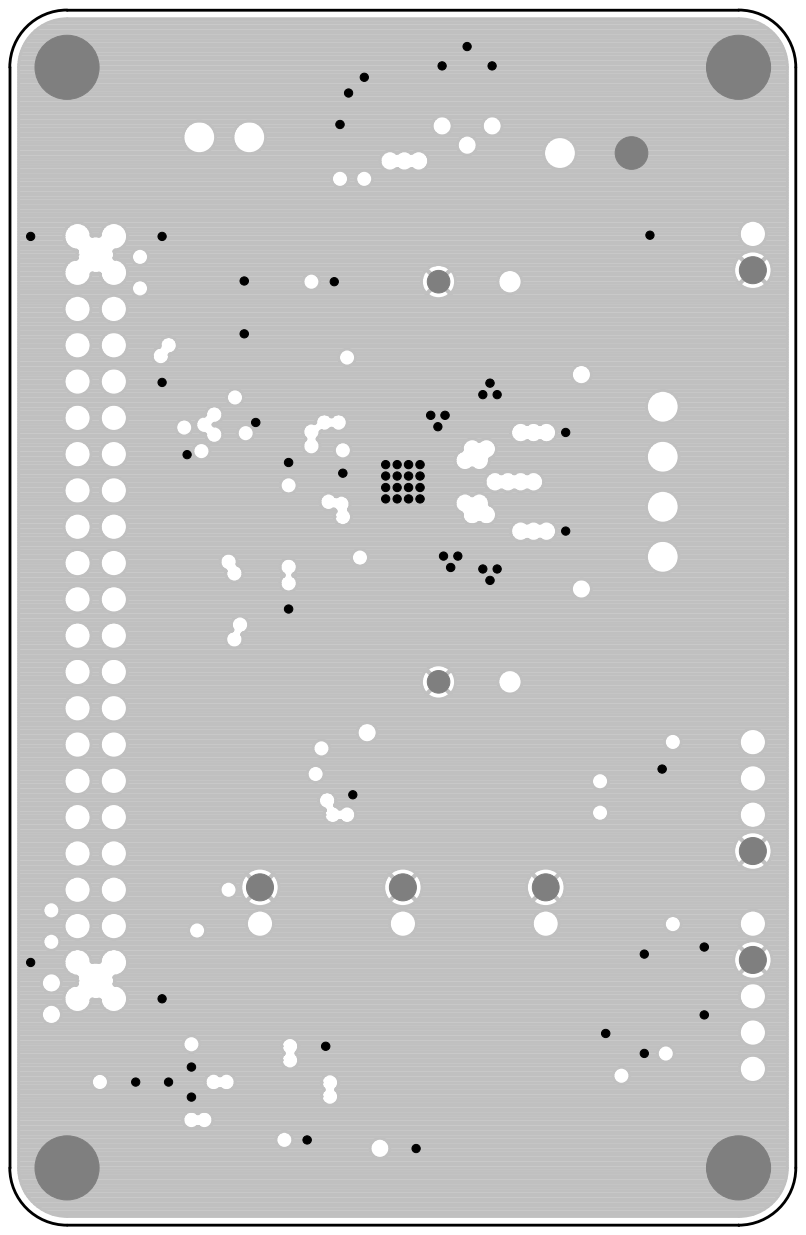
[picture p46: page 1]
