JulesBischof/Praxismodul/06_Referenzen/TMC5240-EVAL/V10/PDF/Other/TMC5240-EVAL_V10 - L3.pdf

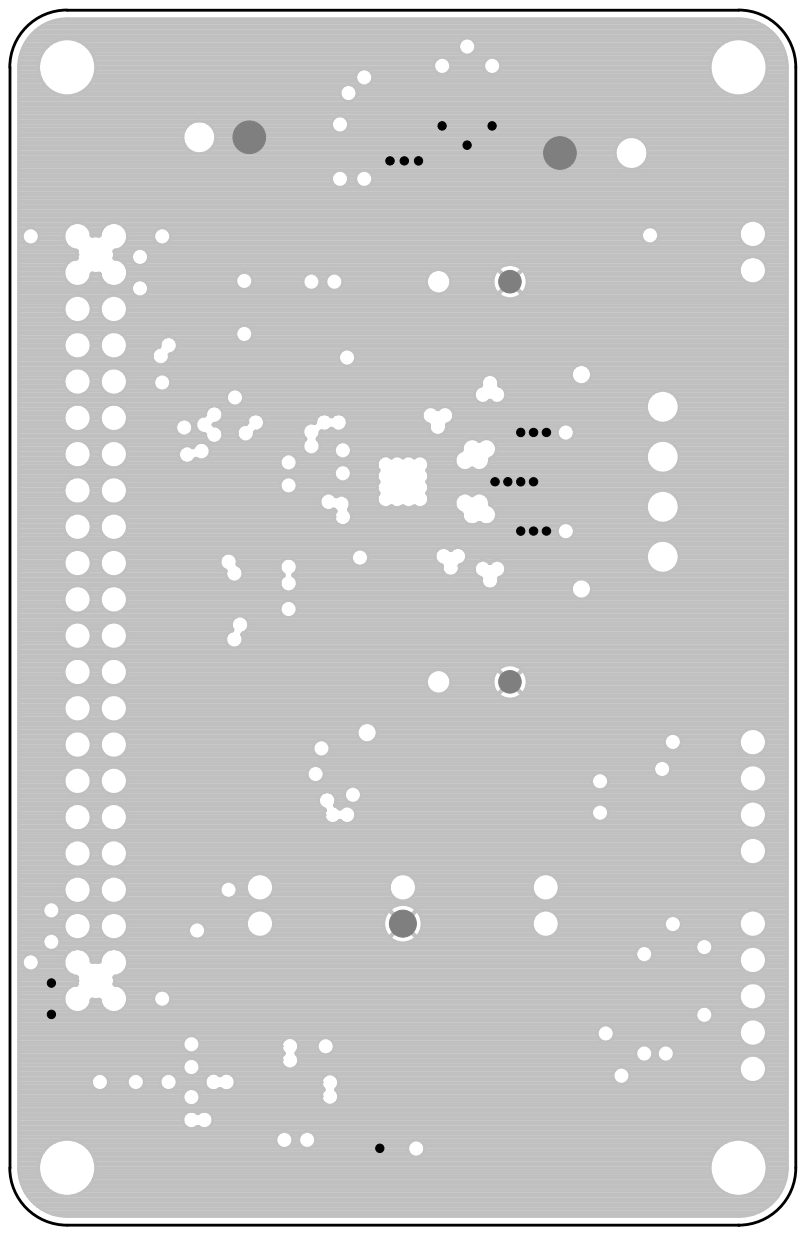
[picture p47: page 1]
