JulesBischof/Praxismodul/08_Auslegungen/06_Simulatonsdaten/01_CM-Filter_REAL.asc

C1: cap; 1µ; V=50 Irms=0 Rser=0.0056 Lser=600p mfg="Würth Elektronik" pn="885012208093 WCAP-CSGP 1206" type="X7R"
C2: cap; 1µ; V=50 Irms=0 Rser=0.0056 Lser=600p mfg="Würth Elektronik" pn="885012208093 WCAP-CSGP 1206" type="X7R"
L1: ind; 2e-8
R1: res; 0.03
R2: res; 0.1
U1: ACM4520_901_2P_T000_s
V1: voltage; AC
Named nets: Uout, 0
.ac dec 10000 1k 1G
