JulesBischof/Praxismodul/08_Auslegungen/06_Simulatonsdaten/01_DM-Filter_REAL.asc

C1: cap; 10µ; V=50 Irms=0 Rser=0.0034 Lser=799p mfg="Würth Elektronik" pn="885012108022 WCAP-CSGP 1206" type="X5R"
L1: ind; 2e-8
R1: res; 0.008321656950
U1: ACM4520_901_2P_T000_s
V1: voltage; AC
Named nets: 0, Uout
.ac dec 10000 1k 1G
