JulesBischof/Praxismodul/(list of files, drawings)

Other design files:
06_Referenzen/SGuard/D00173332_IP3734.PRJPCB
06_Referenzen/SGuard/D00173332_IP3734.SCHLIB
06_Referenzen/SGuard/Documents/01_D00173332_TopSheet.SchDoc
06_Referenzen/SGuard/Documents/02_CtrlExp_Link.SchDoc
06_Referenzen/SGuard/Documents/03_Power_Supply.SchDoc
06_Referenzen/SGuard/Documents/04_Driver.SchDoc
06_Referenzen/SGuard/Documents/05_Encoder_IN.SchDoc
06_Referenzen/SGuard/Documents/06_Input_1-3.SchDoc
06_Referenzen/SGuard/Documents/07_Hardware_ID.SchDoc
06_Referenzen/SGuard/Documents/08_PowerConcept.SchDoc
06_Referenzen/TMC5240-EVAL/V10/CAD/TMC5240-EVAL_V10.pcb
08_Auslegungen/06_Simulatonsdaten/00_Spice_Daten/Pspice_WE-CSGP_DC_Bias_Models/WCAP-CSGP_6-3V_DCBIAS.OLB
08_Auslegungen/06_Simulatonsdaten/00_Spice_Daten/Pspice_WE-CSGP_DC_Bias_Models/WCAP-CSGP_10V_DCBIAS.OLB
08_Auslegungen/06_Simulatonsdaten/00_Spice_Daten/Pspice_WE-CSGP_DC_Bias_Models/WCAP-CSGP_16V_DCBIAS.OLB
08_Auslegungen/06_Simulatonsdaten/00_Spice_Daten/Pspice_WE-CSGP_DC_Bias_Models/WCAP-CSGP_25V_DCBIAS.OLB
08_Auslegungen/06_Simulatonsdaten/00_Spice_Daten/Pspice_WE-CSGP_DC_Bias_Models/WCAP-CSGP_50V_DCBIAS.OLB
08_Auslegungen/06_Simulatonsdaten/00_Spice_Daten/Pspice_WE-CSGP_DC_Bias_Models/WCAP-CSGP_100V_DCBIAS.OLB
08_Auslegungen/06_Simulatonsdaten/00_Spice_Daten/Pspice_WE-CSGP_Simple_Models/WCAP-CSGP_6-3V.OLB
08_Auslegungen/06_Simulatonsdaten/00_Spice_Daten/Pspice_WE-CSGP_Simple_Models/WCAP-CSGP_10V.OLB
08_Auslegungen/06_Simulatonsdaten/00_Spice_Daten/Pspice_WE-CSGP_Simple_Models/WCAP-CSGP_16V.OLB
08_Auslegungen/06_Simulatonsdaten/00_Spice_Daten/Pspice_WE-CSGP_Simple_Models/WCAP-CSGP_25V.OLB
08_Auslegungen/06_Simulatonsdaten/00_Spice_Daten/Pspice_WE-CSGP_Simple_Models/WCAP-CSGP_50V.OLB
08_Auslegungen/06_Simulatonsdaten/00_Spice_Daten/Pspice_WE-CSGP_Simple_Models/WCAP-CSGP_100V.OLB
