JulesBischof/Praxismodul/06_Referenzen/TMC5240-EVAL/V10/CAD/borders_os.ini

[SYMBOLS]
A2SHEETL=Borders:TMC_A2_sheet_os.1
A2SHEETL1=Borders:TMC_A2_sheet_os.1
[ZONE A2SHEETL]
OFFSETLEFT=0
OFFSETRIGHT=0
OFFSETTOP=0
OFFSETBOTTOM=0
VERTNUMBER=5
HORZNUMBER=7
VERTLABELING=1
HORZLABELING=2
[ATTRIBUTES]
APPROVEDBY=SK
DESIGNEDBY=MM
RELEASEDATE=2022-01-10
REVISION=1.0
SHEETTITLE=?
[ANNOTATIONS]
[DEFAULTS]
